koradeh/STM32_Drone/Datasheets/GEPRC-ESP8285-ELRS-Nano-Receiver-Nano-Receiver-diagram.webp

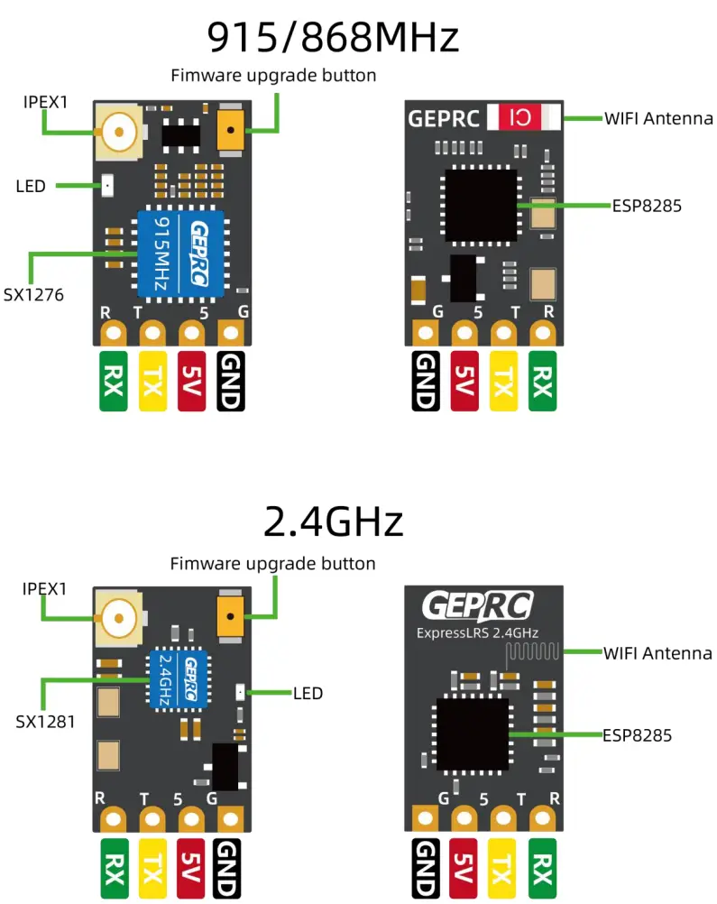
Datasheets/GEPRC-ESP8285-ELRS-Nano-Receiver-Nano-Receiver-diagram.webp
