koradeh/STM32_Drone/Datasheets/SpeedyBee F405 V4.webp

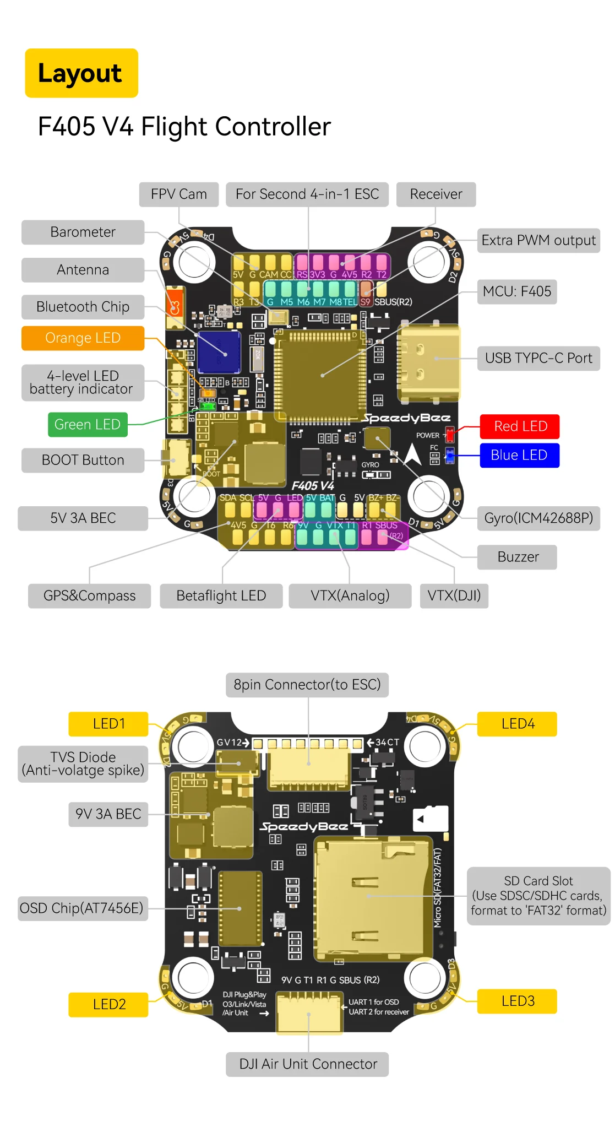
Datasheets/SpeedyBee F405 V4.webp
