koradeh/STM32_Drone/Datasheets/buzzerConnection.png

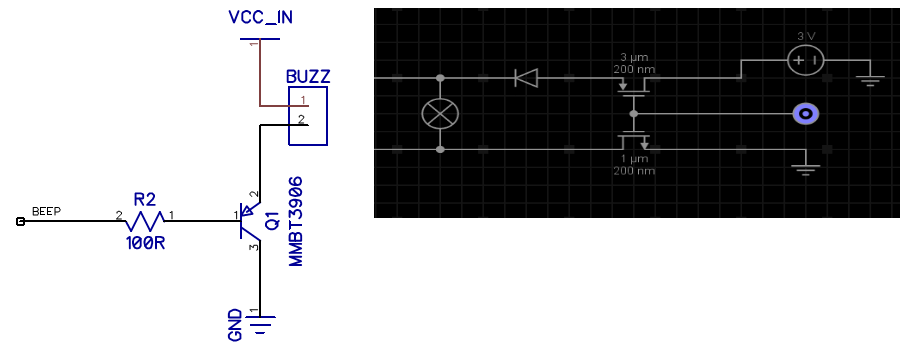
Datasheets/buzzerConnection.png
