koradeh/STM32_Drone/Datasheets/Flight Controller Sample 1.png

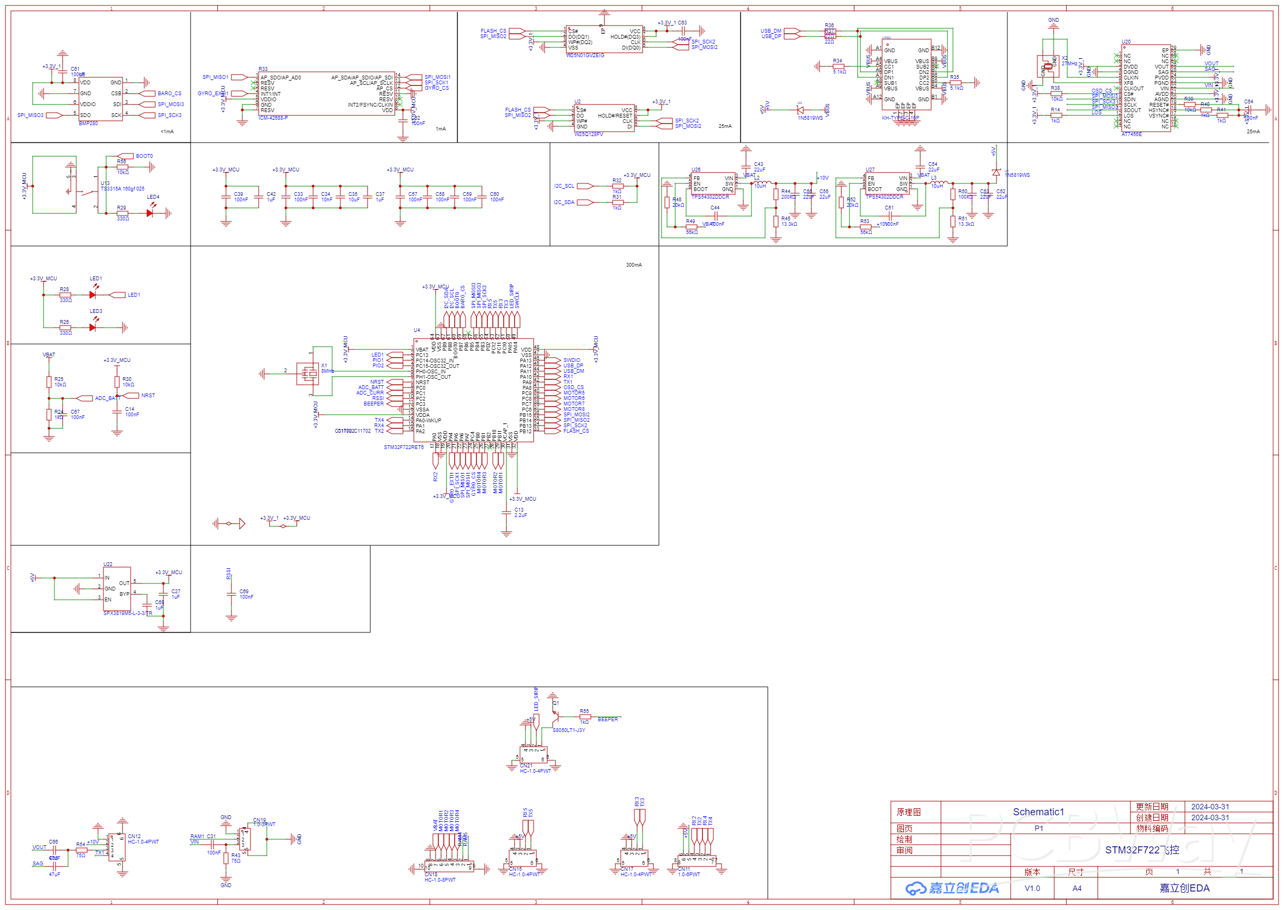
Datasheets/Flight Controller Sample 1.png
