koradeh/STM32_Drone/Sample Firmware/Liberty-X-main/LIBERTY-X.png

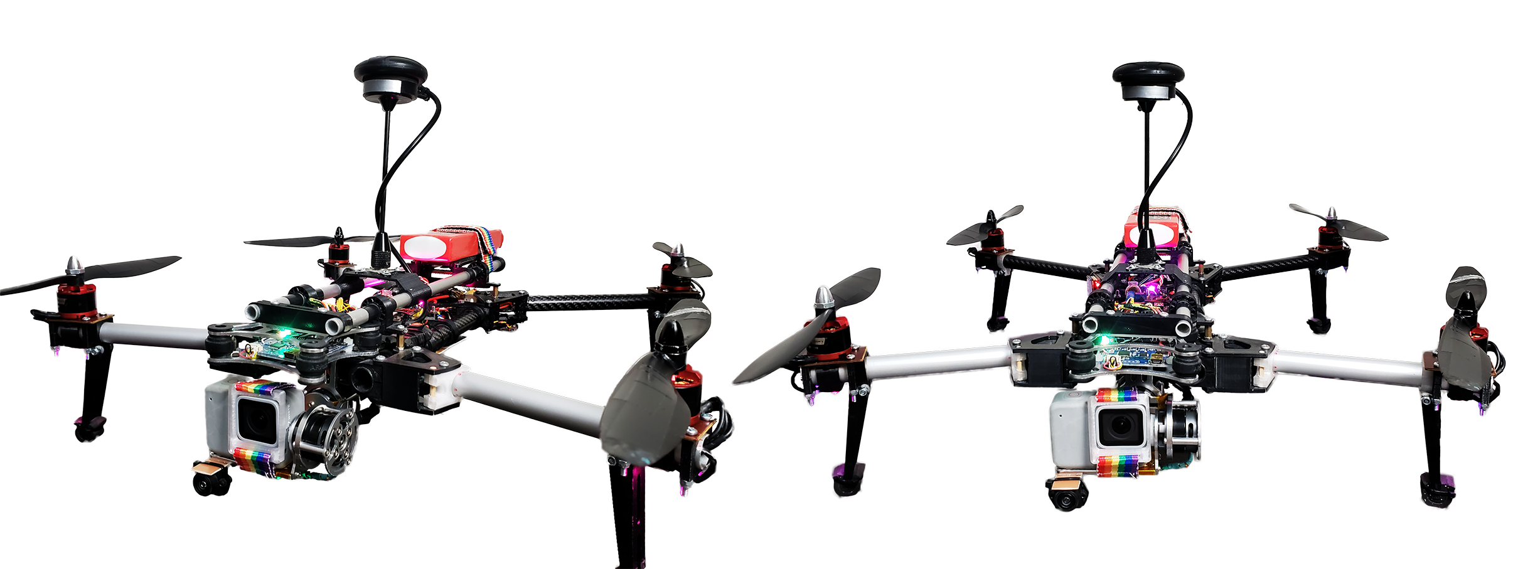
Sample Firmware/Liberty-X-main/LIBERTY-X.png
