koradeh/STM32_Drone/ZenFlyF7II_Clean/ZenFly F71.png

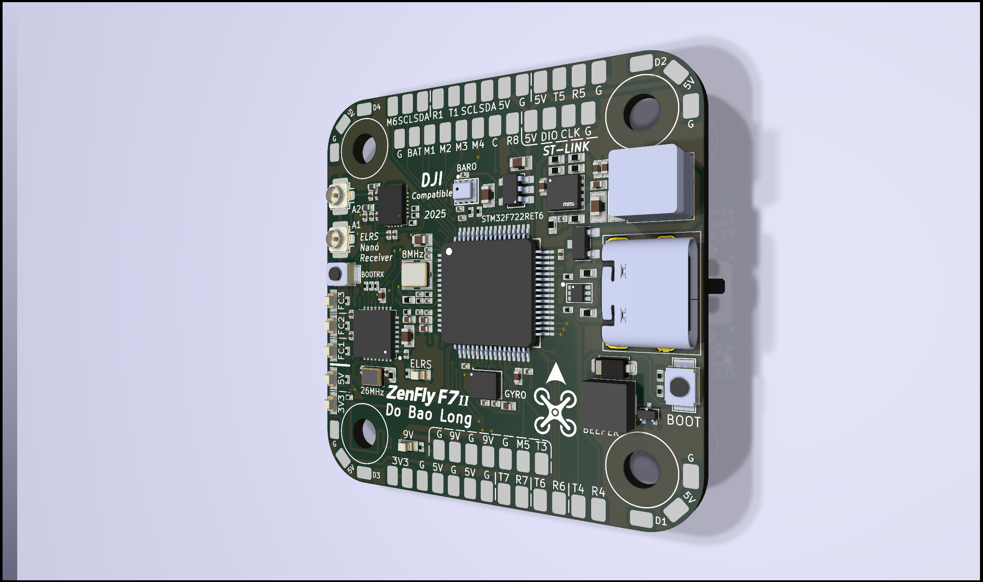
ZenFlyF7II_Clean/ZenFly F71.png
