koradeh/STM32_Drone/ZenFlyF72_Refine/ZenFly F71.jpg

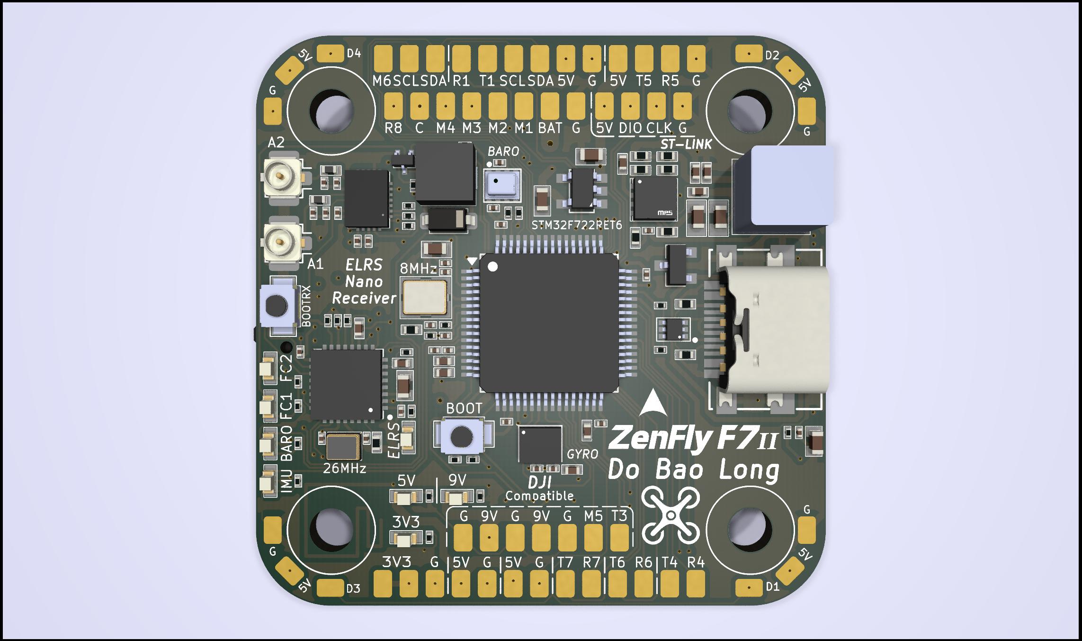
ZenFlyF72_Refine/ZenFly F71.jpg
