koradeh/STM32_Drone/Components.xlsx

Resistor | Value | LCSC | Footprint | Spec
R1 | 0 | None | #0201 | None
R2 | 10K | C319932 | #0201 | 1/32W Thin Film Resistor 15V ±0.5% ±50ppm/℃ 10kΩ 0201 Chip Resistor - Surface Mount ROHS
R3 | 10K | C319932 | #0201 | 1/32W Thin Film Resistor 15V ±0.5% ±50ppm/℃ 10kΩ 0201 Chip Resistor - Surface Mount ROHS
R4 | 4.7K | C852254 | #0201 | 50mW Thin Film Resistor ±25ppm/℃ ±0.1% 4.7kΩ 0201 Chip Resistor - Surface Mount ROHS
R5 | 4.7K | C852254 | #0201 | 50mW Thin Film Resistor ±25ppm/℃ ±0.1% 4.7kΩ 0201 Chip Resistor - Surface Mount ROHS
R6 | 5.1K | C851767 (https://www.lcsc.com/product-detail/Chip-Resistor-Surface-Mount_YAGEO-RC0201DR-075K1L_C851767.html) | #0402 | 50mW Thick Film Resistors ±0.5% ±200ppm/℃ 5.1kΩ 0201 Chip Resistor - Surface Mount ROHS
R7 | 5.1K | C851767 (https://www.lcsc.com/product-detail/Chip-Resistor-Surface-Mount_YAGEO-RC0201DR-075K1L_C851767.html) | #0201 | 50mW Thick Film Resistors ±0.5% ±200ppm/℃ 5.1kΩ 0201 Chip Resistor - Surface Mount ROHS
R8 | 22 | C2991382 (https://www.lcsc.com/product-detail/Chip-Resistor-Surface-Mount_Walsin-Tech-Corp-MR02X22R0FAL_C2991382.html) | #0201 | 1/20W Thick Film Resistors 25V ±100ppm/℃ ±1% 22Ω 0201 Chip Resistor - Surface Mount ROHS
R9 | 22 | C2991382 (https://www.lcsc.com/product-detail/Chip-Resistor-Surface-Mount_Walsin-Tech-Corp-MR02X22R0FAL_C2991382.html) | #0201 | 1/20W Thick Film Resistors 25V ±100ppm/℃ ±1% 22Ω 0201 Chip Resistor - Surface Mount ROHS
R10 | 10K | C319932 | #0201 | 1/32W Thin Film Resistor 15V ±0.5% ±50ppm/℃ 10kΩ 0201 Chip Resistor - Surface Mount ROHS
R11 | 10K | C319932 | #0201 | 1/32W Thin Film Resistor 15V ±0.5% ±50ppm/℃ 10kΩ 0201 Chip Resistor - Surface Mount ROHS
R12 | 12K | C2693077 (https://www.lcsc.com/product-detail/Chip-Resistor-Surface-Mount_RESI-PTFR0402B12K0N9_C2693077.html) | #0402 | 50mW 25V ±100ppm/℃ ±1% 12kΩ 0201 Chip Resistor - Surface Mount ROHS
R13 | 10K | C319932 | #0201 | 1/32W Thin Film Resistor 15V ±0.5% ±50ppm/℃ 10kΩ 0201 Chip Resistor - Surface Mount ROHS
R14 | 18K | C246974 (https://www.lcsc.com/product-detail/Chip-Resistor-Surface-Mount_UNI-ROYAL-Uniroyal-Elec-0201WMF1802TCE_C246974.html) | #0402 | 1/16W Thin Film Resistor 50V ±25ppm/℃ ±0.1% 18kΩ 0402 Chip Resistor - Surface Mount ROHS
R15 | 2K | C490810 | #0201 | 0.05W Thin Film Resistor 25V ±0.1% ±25ppm/℃ 2kΩ 0201 Chip Resistor - Surface Mount ROHS
R16 | 560 | C490810 | #0201 | 0.05W Thin Film Resistor 25V ±0.1% ±25ppm/℃ 2kΩ 0201 Chip Resistor - Surface Mount ROHS
R17 | 330 | C274872 (https://www.lcsc.com/product-detail/Chip-Resistor-Surface-Mount_YAGEO-RC0201FR-07330RL_C274872.html) | #0201 | 50mW Thick Film Resistors 25V ±1% ±200ppm/℃ 330Ω 0201 Chip Resistor - Surface Mount ROHS
R18 | 330 | C274872 (https://www.lcsc.com/product-detail/Chip-Resistor-Surface-Mount_YAGEO-RC0201FR-07330RL_C274872.html) | #0201 | 50mW Thick Film Resistors 25V ±1% ±200ppm/℃ 330Ω 0201 Chip Resistor - Surface Mount ROHS
R19 | 1.1K | C490809 | #0201 | 0.05W Thin Film Resistor 25V ±0.1% ±25ppm/℃ 1.1kΩ 0201 Chip Resistor - Surface Mount ROHS
R20 | 330 | C274872 (https://www.lcsc.com/product-detail/Chip-Resistor-Surface-Mount_YAGEO-RC0201FR-07330RL_C274872.html) | #0201 | 50mW Thick Film Resistors 25V ±1% ±200ppm/℃ 330Ω 0201 Chip Resistor - Surface Mount ROHS
R21 | 330 | C274872 (https://www.lcsc.com/product-detail/Chip-Resistor-Surface-Mount_YAGEO-RC0201FR-07330RL_C274872.html) | #0201 | 50mW Thick Film Resistors 25V ±1% ±200ppm/℃ 330Ω 0201 Chip Resistor - Surface Mount ROHS
R22 | 330 | C274872 (https://www.lcsc.com/product-detail/Chip-Resistor-Surface-Mount_YAGEO-RC0201FR-07330RL_C274872.html) | #0201 | 50mW Thick Film Resistors 25V ±1% ±200ppm/℃ 330Ω 0201 Chip Resistor - Surface Mount ROHS
R23 | 18 | C384425 (https://www.lcsc.com/product-detail/Chip-Resistor-Surface-Mount_Walsin-Tech-Corp-WR02X18R0FAL_C384425.html) | #0201 | 50mW 25V ±100ppm/℃ ±1% 18Ω 0201 Chip Resistor - Surface Mount ROHS
R24 | 10K | C319932 | #0201 | 1/32W Thin Film Resistor 15V ±0.5% ±50ppm/℃ 10kΩ 0201 Chip Resistor - Surface Mount ROHS
R25 | 10K | C319932 | #0201 | 1/32W Thin Film Resistor 15V ±0.5% ±50ppm/℃ 10kΩ 0201 Chip Resistor - Surface Mount ROHS
R26 | 2.2K | C2074393 | #0201 | 50mW Thick Film Resistors 30V ±1% ±100ppm/℃ 2.2kΩ 0201 Chip Resistor - Surface Mount ROHS
R27 | 1.2K | C319992 (https://www.lcsc.com/product-detail/Chip-Resistor-Surface-Mount_Viking-Tech-AR01DTD1201_C319992.html) | #0201 | 1/32W Thin Film Resistor 15V ±0.5% ±50ppm/℃ 1.2kΩ 0201 Chip Resistor - Surface Mount ROHS
R28 | 100K | C2108139 (https://www.lcsc.com/product-detail/Chip-Resistor-Surface-Mount_BOURNS-CR0201-FW-1003GLF_C2108139.html) | #0201 | 50mW Thick Film Resistors 15V ±1% ±200ppm/℃ 100kΩ 0201 Chip Resistor - Surface Mount ROHS
R29 | 330 | C274872 (https://www.lcsc.com/product-detail/Chip-Resistor-Surface-Mount_YAGEO-RC0201FR-07330RL_C274872.html) | #0201 | 50mW Thick Film Resistors 25V ±1% ±200ppm/℃ 330Ω 0201 Chip Resistor - Surface Mount ROHS
R30 | 100K | C2108139 (https://www.lcsc.com/product-detail/Chip-Resistor-Surface-Mount_BOURNS-CR0201-FW-1003GLF_C2108139.html) | #0201 | 50mW Thick Film Resistors 15V ±1% ±200ppm/℃ 100kΩ 0201 Chip Resistor - Surface Mount ROHS
R31_BEC2 | 41.2K | C2683018 (https://www.lcsc.com/product-detail/Chip-Resistor-Surface-Mount_Viking-Tech-ARG02BTC4122_C2683018.html) | #0402 | 1/16W Thin Film Resistor 50V ±25ppm/℃ ±0.1% 41.2kΩ 0402 Chip Resistor - Surface Mount ROHS
R31_BEC1 | 41.2K | C2683018 (https://www.lcsc.com/product-detail/Chip-Resistor-Surface-Mount_Viking-Tech-ARG02BTC4122_C2683018.html) | #0402 | 1/16W Thin Film Resistor 50V ±25ppm/℃ ±0.1% 41.2kΩ 0402 Chip Resistor - Surface Mount ROHS
R30_BEC2 | 7.5K | C728565 (https://www.lcsc.com/product-detail/Chip-Resistor-Surface-Mount_YAGEO-RT0402BRD077K5L_C728565.html) | #0402 | 62.5mW Thin Film Resistor 50V ±25ppm/℃ ±0.1% 7.5kΩ 0402 Chip Resistor - Surface Mount ROHS
R30_BEC1 | 3.92K | C284551 (https://www.lcsc.com/product-detail/Chip-Resistor-Surface-Mount_Viking-Tech-ARG02FTC3921_C284551.html) | #0402 | 1/16W Thin Film Resistor 50V ±25ppm/℃ ±1% 3.92kΩ 0402 Chip Resistor - Surface Mount ROHS
R29_BEC2 | 51K | C284600 (https://www.lcsc.com/product-detail/Chip-Resistor-Surface-Mount_Viking-Tech-ARG02FTC5102_C284600.html) | #0402 | 1/16W Thin Film Resistor 50V ±25ppm/℃ ±1% 51kΩ 0402 Chip Resistor - Surface Mount ROHS
R29_BEC1 | 51K | C284600 (https://www.lcsc.com/product-detail/Chip-Resistor-Surface-Mount_Viking-Tech-ARG02FTC5102_C284600.html) | #0402 | 1/16W Thin Film Resistor 50V ±25ppm/℃ ±1% 51kΩ 0402 Chip Resistor - Surface Mount ROHS
R28_BEC2 | 20 | C2686477 (https://www.lcsc.com/product-detail/Chip-Resistor-Surface-Mount_Viking-Tech-ARG02DTC0200_C2686477.html) | #0402 | 1/16W Thin Film Resistor 50V ±0.5% ±25ppm/℃ 20Ω 0402 Chip Resistor - Surface Mount ROHS
R28_BEC1 | 20 | C2686477 (https://www.lcsc.com/product-detail/Chip-Resistor-Surface-Mount_Viking-Tech-ARG02DTC0200_C2686477.html) | #0402 | 1/16W Thin Film Resistor 50V ±0.5% ±25ppm/℃ 20Ω 0402 Chip Resistor - Surface Mount ROHS
R27_BEC2 | 100K | C852472 (https://www.lcsc.com/product-detail/Chip-Resistor-Surface-Mount_YAGEO-RT0402BRD07100KL_C852472.html) | #0402 | 62.5mW Thin Film Resistor 50V ±25ppm/℃ ±0.1% 100kΩ 0402 Chip Resistor - Surface Mount ROHS
R27_BEC1 | 100K | C852472 (https://www.lcsc.com/product-detail/Chip-Resistor-Surface-Mount_YAGEO-RT0402BRD07100KL_C852472.html) | #0402 | 62.5mW Thin Film Resistor 50V ±25ppm/℃ ±0.1% 100kΩ 0402 Chip Resistor - Surface Mount ROHS
R26_BEC2 | 1M | C1884615 (https://www.lcsc.com/product-detail/Chip-Resistor-Surface-Mount_Vishay-Intertech-MCS04020C1004FE000_C1884615.html) | #0402 | 100mW Thin Film Resistor 50V ±50ppm/℃ ±1% 1MΩ 0402 Chip Resistor - Surface Mount ROHS
R26_BEC1 | 1M | C1884615 | #0402 | 100mW Thin Film Resistor 50V ±50ppm/℃ ±1% 1MΩ 0402 Chip Resistor - Surface Mount ROHS
Capacitor | Value | LCSC | Footprint | Spec
C1 | 100nF | C161494 (https://www.lcsc.com/product-detail/Multilayer-Ceramic-Capacitors-MLCC-SMD-SMT_Murata-Electronics-GRM033Z71A104KE14D_C161494.html) | #0201 | 10V 100nF X7R ±10% 0201 Multilayer Ceramic Capacitors MLCC - SMD/SMT ROHS
C2 | 100nF | C161494 (https://www.lcsc.com/product-detail/Multilayer-Ceramic-Capacitors-MLCC-SMD-SMT_Murata-Electronics-GRM033Z71A104KE14D_C161494.html) | #0201 | 10V 100nF X7R ±10% 0201 Multilayer Ceramic Capacitors MLCC - SMD/SMT ROHS
C3 | 100nF | C161494 (https://www.lcsc.com/product-detail/Multilayer-Ceramic-Capacitors-MLCC-SMD-SMT_Murata-Electronics-GRM033Z71A104KE14D_C161494.html) | #0201 | 10V 100nF X7R ±10% 0201 Multilayer Ceramic Capacitors MLCC - SMD/SMT ROHS
C4 | 100nF | C161494 (https://www.lcsc.com/product-detail/Multilayer-Ceramic-Capacitors-MLCC-SMD-SMT_Murata-Electronics-GRM033Z71A104KE14D_C161494.html) | #0201 | 10V 100nF X7R ±10% 0201 Multilayer Ceramic Capacitors MLCC - SMD/SMT ROHS
C5 | 4.7uF | C913474 (https://www.lcsc.com/product-detail/Multilayer-Ceramic-Capacitors-MLCC-SMD-SMT_Murata-Electronics-GRM188Z71A475KE15D_C913474.html) | #0603 | 10V 4.7uF X7R ±10% 0603 Multilayer Ceramic Capacitors MLCC - SMD/SMT ROHS
C6 | 100nF | C161494 (https://www.lcsc.com/product-detail/Multilayer-Ceramic-Capacitors-MLCC-SMD-SMT_Murata-Electronics-GRM033Z71A104KE14D_C161494.html) | #0201 | 10V 100nF X7R ±10% 0201 Multilayer Ceramic Capacitors MLCC - SMD/SMT ROHS
C7 | 100nF | C161494 (https://www.lcsc.com/product-detail/Multilayer-Ceramic-Capacitors-MLCC-SMD-SMT_Murata-Electronics-GRM033Z71A104KE14D_C161494.html) | #0201 | 10V 100nF X7R ±10% 0201 Multilayer Ceramic Capacitors MLCC - SMD/SMT ROHS
C8 | 2.2uF | C2997286 (https://www.lcsc.com/product-detail/Multilayer-Ceramic-Capacitors-MLCC-SMD-SMT_Murata-Electronics-GRM155Z71A225KE01D_C2997286.html) | #0402 | 10V 2.2uF X7R ±10% 0402 Multilayer Ceramic Capacitors MLCC - SMD/SMT ROHS
C9 | 100nF | C161494 (https://www.lcsc.com/product-detail/Multilayer-Ceramic-Capacitors-MLCC-SMD-SMT_Murata-Electronics-GRM033Z71A104KE14D_C161494.html) | #0201 | 10V 100nF X7R ±10% 0201 Multilayer Ceramic Capacitors MLCC - SMD/SMT ROHS
C10 | 10uF | C2959727 (https://www.lcsc.com/product-detail/Multilayer-Ceramic-Capacitors-MLCC-SMD-SMT_Murata-Electronics-GRM188Z71A106KA73D_C2959727.html) | #0603 | 10V 10uF X7R ±10% 0603 Multilayer Ceramic Capacitors MLCC - SMD/SMT ROHS
C11 | 100nF | C161494 (https://www.lcsc.com/product-detail/Multilayer-Ceramic-Capacitors-MLCC-SMD-SMT_Murata-Electronics-GRM033Z71A104KE14D_C161494.html) | #0201 | 10V 100nF X7R ±10% 0201 Multilayer Ceramic Capacitors MLCC - SMD/SMT ROHS
C12 | 2.2uF | C2997286 (https://www.lcsc.com/product-detail/Multilayer-Ceramic-Capacitors-MLCC-SMD-SMT_Murata-Electronics-GRM155Z71A225KE01D_C2997286.html) | #0402 | 10V 2.2uF X7R ±10% 0402 Multilayer Ceramic Capacitors MLCC - SMD/SMT ROHS
C13 | 10nF | C6049498 (https://www.lcsc.com/product-detail/Multilayer-Ceramic-Capacitors-MLCC-SMD-SMT_Murata-Electronics-GRM033R71A103JA01D_C6049498.html) | #0201 | 10V 10nF X7R ±5% 0201 Multilayer Ceramic Capacitors MLCC - SMD/SMT ROHS
C14 | 100nF | C161494 (https://www.lcsc.com/product-detail/Multilayer-Ceramic-Capacitors-MLCC-SMD-SMT_Murata-Electronics-GRM033Z71A104KE14D_C161494.html) | #0201 | 10V 100nF X7R ±10% 0201 Multilayer Ceramic Capacitors MLCC - SMD/SMT ROHS
C15 | 100nF | C161494 (https://www.lcsc.com/product-detail/Multilayer-Ceramic-Capacitors-MLCC-SMD-SMT_Murata-Electronics-GRM033Z71A104KE14D_C161494.html) | #0201 | 10V 100nF X7R ±10% 0201 Multilayer Ceramic Capacitors MLCC - SMD/SMT ROHS
C16 | 100nF | C161494 (https://www.lcsc.com/product-detail/Multilayer-Ceramic-Capacitors-MLCC-SMD-SMT_Murata-Electronics-GRM033Z71A104KE14D_C161494.html) | #0201 | 10V 100nF X7R ±10% 0201 Multilayer Ceramic Capacitors MLCC - SMD/SMT ROHS
C17 | 1uF | C528974 (https://www.lcsc.com/product-detail/Multilayer-Ceramic-Capacitors-MLCC-SMD-SMT_Murata-Electronics-GRM155Z71A105KE01D_C528974.html) | #0402 | 10V 1uF X7R ±10% 0402 Multilayer Ceramic Capacitors MLCC - SMD/SMT ROHS
C18 | 1uF | C528974 (https://www.lcsc.com/product-detail/Multilayer-Ceramic-Capacitors-MLCC-SMD-SMT_Murata-Electronics-GRM155Z71A105KE01D_C528974.html) | #0402 | 10V 1uF X7R ±10% 0402 Multilayer Ceramic Capacitors MLCC - SMD/SMT ROHS
C19 | 10pF | C18213215 (https://www.lcsc.com/product-detail/Multilayer-Ceramic-Capacitors-MLCC-SMD-SMT_FH-Guangdong-Fenghua-Advanced-Tech-0201CG100J160NT_C18213215.html) | #0201 | 16V 10pF C0G ±5% 0201 Multilayer Ceramic Capacitors MLCC - SMD/SMT ROHS
C20 | 10pF | C18213215 (https://www.lcsc.com/product-detail/Multilayer-Ceramic-Capacitors-MLCC-SMD-SMT_FH-Guangdong-Fenghua-Advanced-Tech-0201CG100J160NT_C18213215.html) | #0201 | 16V 10pF C0G ±5% 0201 Multilayer Ceramic Capacitors MLCC - SMD/SMT ROHS
C21 | 10pF | C18213215 (https://www.lcsc.com/product-detail/Multilayer-Ceramic-Capacitors-MLCC-SMD-SMT_FH-Guangdong-Fenghua-Advanced-Tech-0201CG100J160NT_C18213215.html) | #0201 | 16V 10pF C0G ±5% 0201 Multilayer Ceramic Capacitors MLCC - SMD/SMT ROHS
C22 | 10pF | C18213215 (https://www.lcsc.com/product-detail/Multilayer-Ceramic-Capacitors-MLCC-SMD-SMT_FH-Guangdong-Fenghua-Advanced-Tech-0201CG100J160NT_C18213215.html) | #0201 | 16V 10pF C0G ±5% 0201 Multilayer Ceramic Capacitors MLCC - SMD/SMT ROHS
C23 | 100nF | C161494 (https://www.lcsc.com/product-detail/Multilayer-Ceramic-Capacitors-MLCC-SMD-SMT_Murata-Electronics-GRM033Z71A104KE14D_C161494.html) | #0201 | 10V 100nF X7R ±10% 0201 Multilayer Ceramic Capacitors MLCC - SMD/SMT ROHS
C24 | 10nF | C6049498 (https://www.lcsc.com/product-detail/Multilayer-Ceramic-Capacitors-MLCC-SMD-SMT_Murata-Electronics-GRM033R71A103JA01D_C6049498.html) | #0201 | 10V 10nF X7R ±5% 0201 Multilayer Ceramic Capacitors MLCC - SMD/SMT ROHS
C25 | 4.7uF | C913474 (https://www.lcsc.com/product-detail/Multilayer-Ceramic-Capacitors-MLCC-SMD-SMT_Murata-Electronics-GRM188Z71A475KE15D_C913474.html) | #0603 | 10V 4.7uF X7R ±10% 0603 Multilayer Ceramic Capacitors MLCC - SMD/SMT ROHS
C26 | 4.7uF | C913474 (https://www.lcsc.com/product-detail/Multilayer-Ceramic-Capacitors-MLCC-SMD-SMT_Murata-Electronics-GRM188Z71A475KE15D_C913474.html) | #0603 | 10V 4.7uF X7R ±10% 0603 Multilayer Ceramic Capacitors MLCC - SMD/SMT ROHS
C27 | 100nF | C161494 (https://www.lcsc.com/product-detail/Multilayer-Ceramic-Capacitors-MLCC-SMD-SMT_Murata-Electronics-GRM033Z71A104KE14D_C161494.html) | #0201 | 10V 100nF X7R ±10% 0201 Multilayer Ceramic Capacitors MLCC - SMD/SMT ROHS
C28 | 100nF | C161494 (https://www.lcsc.com/product-detail/Multilayer-Ceramic-Capacitors-MLCC-SMD-SMT_Murata-Electronics-GRM033Z71A104KE14D_C161494.html) | #0201 | 10V 100nF X7R ±10% 0201 Multilayer Ceramic Capacitors MLCC - SMD/SMT ROHS
C29 | 10nF | C6049498 (https://www.lcsc.com/product-detail/Multilayer-Ceramic-Capacitors-MLCC-SMD-SMT_Murata-Electronics-GRM033R71A103JA01D_C6049498.html) | #0201 | 10V 10nF X7R ±5% 0201 Multilayer Ceramic Capacitors MLCC - SMD/SMT ROHS
C30 | 100nF | C161494 (https://www.lcsc.com/product-detail/Multilayer-Ceramic-Capacitors-MLCC-SMD-SMT_Murata-Electronics-GRM033Z71A104KE14D_C161494.html) | #0201 | 10V 100nF X7R ±10% 0201 Multilayer Ceramic Capacitors MLCC - SMD/SMT ROHS
C31 | 100nF | C161494 (https://www.lcsc.com/product-detail/Multilayer-Ceramic-Capacitors-MLCC-SMD-SMT_Murata-Electronics-GRM033Z71A104KE14D_C161494.html) | #0201 | 10V 100nF X7R ±10% 0201 Multilayer Ceramic Capacitors MLCC - SMD/SMT ROHS
C32 | 470nF | C36911354 (https://www.lcsc.com/product-detail/Multilayer-Ceramic-Capacitors-MLCC-SMD-SMT_HRE-CGA0402X7R474K100GT_C36911354.html) | #0402 | 10V 470nF X7R ±10% 0402 Multilayer Ceramic Capacitors MLCC - SMD/SMT ROHS
C33 | 18pF | C18213178 (https://www.lcsc.com/product-detail/Multilayer-Ceramic-Capacitors-MLCC-SMD-SMT_FH-Guangdong-Fenghua-Advanced-Tech-0201CG180J160NT_C18213178.html) | #0201 | 16V 18pF C0G ±5% 0201 Multilayer Ceramic Capacitors MLCC - SMD/SMT ROHS
C34 | 18pF | C18213178 (https://www.lcsc.com/product-detail/Multilayer-Ceramic-Capacitors-MLCC-SMD-SMT_FH-Guangdong-Fenghua-Advanced-Tech-0201CG180J160NT_C18213178.html) | #0201 | 16V 18pF C0G ±5% 0201 Multilayer Ceramic Capacitors MLCC - SMD/SMT ROHS
C35 | 1.2pF | C20069200 (https://www.lcsc.com/product-detail/Multilayer-Ceramic-Capacitors-MLCC-SMD-SMT_HRE-CGA0201C0G1R2C250ET_C20069200.html) | #0201 | 25V 1.2pF C0G 0201 Multilayer Ceramic Capacitors MLCC - SMD/SMT ROHS
C36 | 1.2pF | C20069200 (https://www.lcsc.com/product-detail/Multilayer-Ceramic-Capacitors-MLCC-SMD-SMT_HRE-CGA0201C0G1R2C250ET_C20069200.html) | #0201 | 25V 1.2pF C0G 0201 Multilayer Ceramic Capacitors MLCC - SMD/SMT ROHS
C37 | 1.2pF | C20069200 (https://www.lcsc.com/product-detail/Multilayer-Ceramic-Capacitors-MLCC-SMD-SMT_HRE-CGA0201C0G1R2C250ET_C20069200.html) | #0201 | 25V 1.2pF C0G 0201 Multilayer Ceramic Capacitors MLCC - SMD/SMT ROHS
C38 | 1.2pF | C20069200 (https://www.lcsc.com/product-detail/Multilayer-Ceramic-Capacitors-MLCC-SMD-SMT_HRE-CGA0201C0G1R2C250ET_C20069200.html) | #0201 | 25V 1.2pF C0G 0201 Multilayer Ceramic Capacitors MLCC - SMD/SMT ROHS
C39 | 10pF | C18213215 (https://www.lcsc.com/product-detail/Multilayer-Ceramic-Capacitors-MLCC-SMD-SMT_FH-Guangdong-Fenghua-Advanced-Tech-0201CG100J160NT_C18213215.html) | #0201 | 16V 10pF C0G ±5% 0201 Multilayer Ceramic Capacitors MLCC - SMD/SMT ROHS
C40 | 10pF | C18213215 (https://www.lcsc.com/product-detail/Multilayer-Ceramic-Capacitors-MLCC-SMD-SMT_FH-Guangdong-Fenghua-Advanced-Tech-0201CG100J160NT_C18213215.html) | #0201 | 16V 10pF C0G ±5% 0201 Multilayer Ceramic Capacitors MLCC - SMD/SMT ROHS
C41 | 1uF | C528974 (https://www.lcsc.com/product-detail/Multilayer-Ceramic-Capacitors-MLCC-SMD-SMT_Murata-Electronics-GRM155Z71A105KE01D_C528974.html) | #0402 | 10V 1uF X7R ±10% 0402 Multilayer Ceramic Capacitors MLCC - SMD/SMT ROHS
C42 | 1uF | C528974 (https://www.lcsc.com/product-detail/Multilayer-Ceramic-Capacitors-MLCC-SMD-SMT_Murata-Electronics-GRM155Z71A105KE01D_C528974.html) | #0402 | 10V 1uF X7R ±10% 0402 Multilayer Ceramic Capacitors MLCC - SMD/SMT ROHS
C43 | 10uF | C2959727 (https://www.lcsc.com/product-detail/Multilayer-Ceramic-Capacitors-MLCC-SMD-SMT_Murata-Electronics-GRM188Z71A106KA73D_C2959727.html) | #0603 | 10V 10uF X7R ±10% 0603 Multilayer Ceramic Capacitors MLCC - SMD/SMT ROHS
C29_BEC1 | 10uF | C22367826 (https://www.lcsc.com/product-detail/Multilayer-Ceramic-Capacitors-MLCC-SMD-SMT_Chinocera-HGC0603R5106K350NTHJ_C22367826.html) | #0603 | 35V 10uF X5R ±10% 0603 Multilayer Ceramic Capacitors MLCC - SMD/SMT ROHS
C29_BEC2 | 10uF | C22367826 (https://www.lcsc.com/product-detail/Multilayer-Ceramic-Capacitors-MLCC-SMD-SMT_Chinocera-HGC0603R5106K350NTHJ_C22367826.html) | #0603 | 35V 10uF X5R ±10% 0603 Multilayer Ceramic Capacitors MLCC - SMD/SMT ROHS
C30_BEC1 | 10uF | C22367826 (https://www.lcsc.com/product-detail/Multilayer-Ceramic-Capacitors-MLCC-SMD-SMT_Chinocera-HGC0603R5106K350NTHJ_C22367826.html) | #0603 | 35V 10uF X5R ±10% 0603 Multilayer Ceramic Capacitors MLCC - SMD/SMT ROHS
C30_BEC2 | 10uF | C22367826 (https://www.lcsc.com/product-detail/Multilayer-Ceramic-Capacitors-MLCC-SMD-SMT_Chinocera-HGC0603R5106K350NTHJ_C22367826.html) | #0603 | 35V 10uF X5R ±10% 0603 Multilayer Ceramic Capacitors MLCC - SMD/SMT ROHS
C31_BEC1 | 1uF | C361059 (https://www.lcsc.com/product-detail/Multilayer-Ceramic-Capacitors-MLCC-SMD-SMT_Murata-Electronics-GRM155R6YA105KE11D_C361059.html) | #0402 | 35V 1uF X5R ±10% 0402 Multilayer Ceramic Capacitors MLCC - SMD/SMT ROHS
C31_BEC2 | 1uF | C361059 (https://www.lcsc.com/product-detail/Multilayer-Ceramic-Capacitors-MLCC-SMD-SMT_Murata-Electronics-GRM155R6YA105KE11D_C361059.html) | #0402 | 35V 1uF X5R ±10% 0402 Multilayer Ceramic Capacitors MLCC - SMD/SMT ROHS
C32_BEC1 | 100nF | C181043 (https://www.lcsc.com/product-detail/Multilayer-Ceramic-Capacitors-MLCC-SMD-SMT_Murata-Electronics-GRM033R6YA104KE14D_C181043.html) | #0201 | 35V 100nF X5R ±10% 0201 Multilayer Ceramic Capacitors MLCC - SMD/SMT ROHS
C32_BEC2 | 100nF | C181043 (https://www.lcsc.com/product-detail/Multilayer-Ceramic-Capacitors-MLCC-SMD-SMT_Murata-Electronics-GRM033R6YA104KE14D_C181043.html) | #0201 | 35V 100nF X5R ±10% 0201 Multilayer Ceramic Capacitors MLCC - SMD/SMT ROHS
C33_BEC1 | 100nF | C181043 (https://www.lcsc.com/product-detail/Multilayer-Ceramic-Capacitors-MLCC-SMD-SMT_Murata-Electronics-GRM033R6YA104KE14D_C181043.html) | #0201 | 35V 100nF X5R ±10% 0201 Multilayer Ceramic Capacitors MLCC - SMD/SMT ROHS
C33_BEC2 | 100nF | C181043 (https://www.lcsc.com/product-detail/Multilayer-Ceramic-Capacitors-MLCC-SMD-SMT_Murata-Electronics-GRM033R6YA104KE14D_C181043.html) | #0201 | 35V 100nF X5R ±10% 0201 Multilayer Ceramic Capacitors MLCC - SMD/SMT ROHS
C34_BEC1 | 22uF | C6119868 (https://www.lcsc.com/product-detail/Multilayer-Ceramic-Capacitors-MLCC-SMD-SMT_HRE-CGA0603X5R226M160JT_C6119868.html) | #0603 | 16V 22uF X5R ±20% 0603 Multilayer Ceramic Capacitors MLCC - SMD/SMT ROHS
C34_BEC2 | 22uF | C3845593 (https://www.lcsc.com/product-detail/Multilayer-Ceramic-Capacitors-MLCC-SMD-SMT_Murata-Electronics-GRM158R61A226ME15D_C3845593.html) | #0402 | 10V 22uF X5R ±20% 0402 Multilayer Ceramic Capacitors MLCC - SMD/SMT ROHS
C35_BEC1 | 22uF | C6119868 (https://www.lcsc.com/product-detail/Multilayer-Ceramic-Capacitors-MLCC-SMD-SMT_HRE-CGA0603X5R226M160JT_C6119868.html) | #0603 | 16V 22uF X5R ±20% 0603 Multilayer Ceramic Capacitors MLCC - SMD/SMT ROHS
C35_BEC2 | 22uF | C3845593 (https://www.lcsc.com/product-detail/Multilayer-Ceramic-Capacitors-MLCC-SMD-SMT_Murata-Electronics-GRM158R61A226ME15D_C3845593.html) | #0402 | 10V 22uF X5R ±20% 0402 Multilayer Ceramic Capacitors MLCC - SMD/SMT ROHS
Others | Name | LCSC | Footprint | Specification
BZ1 | KLJ-4020 | C556936 (https://www.lcsc.com/product-detail/Buzzers_KELIKING-KLJ-4020_C556936.html) |  | 73dB 4kHz SMD,4x4mm Buzzers ROHS
D1 | BAT54C, 215 | C37704 (https://www.lcsc.com/product-detail/Schottky-Diodes_Nexperia-BAT54C-215_C37704.html?s_z=n_BAt54C%252C%2520215) | SOT-23 | 30V 1 pair of common cathodes 800mV@100mA 200mA SOT-23 Schottky Diodes ROHS
D2 | SMF45A | C5764435 (https://www.lcsc.com/product-detail/ESD-and-Surge-Protection-TVS-ESD_YFW-SMF45A_C5764435.html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) | SOD-123FL | 2.8A 200W 72.7V 50V Unidirectional 45V SOD-123FL ESD and Surge Protection (TVS/ESD) ROHS
D4 | LMBR130T1G | C48974 (https://www.lcsc.com/product-detail/Schottky-Diodes_LRC-LMBR130T1G_C48974.html) | SOD-123 | 30V 350mV 1A SOD-123 Schottky Diodes ROHS
D5 | 1N4148WS | C2128 (https://www.lcsc.com/product-detail/Switching-Diodes_Jiangsu-Changjing-Electronics-Technology-Co-Ltd-1N4148WS_C2128.html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) | SOD-323 | 100V Independent Type 1.25V@150mA 4ns 150mA SOD-323 Switching Diodes ROHS
D6 | 1N4148WS | C2128 (https://www.lcsc.com/product-detail/Switching-Diodes_Jiangsu-Changjing-Electronics-Technology-Co-Ltd-1N4148WS_C2128.html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) | SOD-323 | 100V Independent Type 1.25V@150mA 4ns 150mA SOD-323 Switching Diodes ROHS
FB1 | BLM03AX121SN1D | C83991 (https://www.lcsc.com/product-detail/Ferrite-Beads_Murata-Electronics-BLM03AX121SN1D_C83991.html?s_z=n_FB) | #0201 | 230mΩ ±25% 120Ω@100MHz 0201 Ferrite Beads ROHS
FL1 | 2450FM07D0034T | Shopee | SMD-4P, 0.5x1mm | 100MHz 0.75dB SMD-4P,0.5x1mm RF Filters ROHS (Designed for SX1280)
Q2 | MMBT3904TT1G | C242260 (https://www.lcsc.com/product-detail/Bipolar-BJT_onsemi-MMBT3904TT1G_C242260.html?s_z=n_MMBT3904TT1G) | SOT-416 | 40V 200mW 100@0.1mA,1.0V 200mA NPN SOT-416 Bipolar (BJT) ROHS
J14 | U.FL-R-SMT-1(10) | C88373 (https://www.lcsc.com/product-detail/Coaxial-Connectors-RF_HRS-Hirose-U-FL-R-SMT-1-10_C88373.html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) | FL_Hirose_U.FL-R-SMT-1_Vertical | 1 Inner pin IPEX Board-End 1.25mm -40℃~+90℃ 6GHz 50Ω 2mm SMD Coaxial Connectors (RF) ROHS
J17 | U.FL-R-SMT-1(10) | C88373 (https://www.lcsc.com/product-detail/Coaxial-Connectors-RF_HRS-Hirose-U-FL-R-SMT-1-10_C88373.html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) | FL_Hirose_U.FL-R-SMT-1_Vertical | 1 Inner pin IPEX Board-End 1.25mm -40℃~+90℃ 6GHz 50Ω 2mm SMD Coaxial Connectors (RF) ROHS
LED1 | 19-213/Y2C-CQ2R2L/3T(CY) | C72038 (https://www.lcsc.com/product-detail/LED-Indication-Discrete_Everlight-Elec-19-213-Y2C-CQ2R2L-3T-CY_C72038.html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) | #0603 | 20mA Colorless Transparent Lens -40℃~+85℃ 585.5nm~591.5nm Yellow 120° 60mW 0603 LED Indication - Discrete ROHS
LED2 | 19-213/Y2C-CQ2R2L/3T(CY) | C72038 (https://www.lcsc.com/product-detail/LED-Indication-Discrete_Everlight-Elec-19-213-Y2C-CQ2R2L-3T-CY_C72038.html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) | #0603 | 20mA Colorless Transparent Lens -40℃~+85℃ 585.5nm~591.5nm Yellow 120° 60mW 0603 LED Indication - Discrete ROHS
LED4 | 19-213/Y2C-CQ2R2L/3T(CY) | C72038 (https://www.lcsc.com/product-detail/LED-Indication-Discrete_Everlight-Elec-19-213-Y2C-CQ2R2L-3T-CY_C72038.html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) | #0603 | 20mA Colorless Transparent Lens -40℃~+85℃ 585.5nm~591.5nm Yellow 120° 60mW 0603 LED Indication - Discrete ROHS
LED3 | 19-213/R6C-AP1Q2B/5T | C2984264 (https://www.lcsc.com/product-detail/LED-Indication-Discrete_Everlight-Elec-19-213-R6C-AP1Q2B-5T_C2984264.html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) | #0603 | 112mcd 617.5nm~633.5nm Red 0603 LED Indication - Discrete ROHS
LED5 | 19-213/R6C-AP1Q2B/5T | C2984264 (https://www.lcsc.com/product-detail/LED-Indication-Discrete_Everlight-Elec-19-213-R6C-AP1Q2B-5T_C2984264.html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) | #0603 | 112mcd 617.5nm~633.5nm Red 0603 LED Indication - Discrete ROHS
LED6 | 19-213/GVC-AMNB/5T | C2986021 (https://www.lcsc.com/product-detail/LED-Indication-Discrete_Everlight-Elec-19-213-GVC-AMNB-5T_C2986021.html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) | #0603 | 20mA Colorless Transparent Lens -40℃~+85℃ 563.5nm~571.5nm Yellow-green 120° 60mW 0603 LED Indication - Discrete ROHS
LED7 | 19-213/GHC-XS1T1N/5T | C2984266 (https://www.lcsc.com/product-detail/LED-Indication-Discrete_Everlight-Elec-19-213-GHC-XS1T1N-5T_C2984266.html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) | #0603 | 360mcd Colorless Transparent Lens -40℃~+85℃ 515nm~530nm Emerald 120° 95mW 3.7V 0603 LED Indication - Discrete ROHS
SW1 | B3U-1000P | C231329 (https://www.lcsc.com/product-detail/Tactile-Switches_Omron-Electronics-B3U-1000P_C231329.html?s_z=n_B3U-1000) | Custom | 2.5mm 1.6mm Round Button 50mA Standing paste 3mm SPST 153gf 12V SMD,2.5x3mm Tactile Switches ROHS
SW2 | TA-3514-A1-B | C513999 (https://www.lcsc.com/product-detail/Slide-Switches_Yuandi-TA-3514-A1-B_C513999.html?s_z=n_TA-3514-A1-B) | Custom | SMD,2.7x5mm Slide Switches ROHS
SW3 | B3U-1000P | C231329 (https://www.lcsc.com/product-detail/Tactile-Switches_Omron-Electronics-B3U-1000P_C231329.html?s_z=n_B3U-1000) | Custom | 2.5mm 1.6mm Round Button 50mA Standing paste 3mm SPST 153gf 12V SMD,2.5x3mm Tactile Switches ROHS
L1 | 10uH (FEXL0550A-100M) | C5378517 (https://www.lcsc.com/product-detail/Power-Inductors_cjiang-Changjiang-Microelectronics-Tech-FEXL0550A-100M_C5378517.html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) | Custom | 5A 10uH Winding Inductor ±20% 6.5A SMD,5.5x5.3mm Power Inductors ROHS
L2 | 10uH (FEXL0550A-100M) | C5378517 (https://www.lcsc.com/product-detail/Power-Inductors_cjiang-Changjiang-Microelectronics-Tech-FEXL0550A-100M_C5378517.html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) | Custom | 5A 10uH Winding Inductor ±20% 6.5A SMD,5.5x5.3mm Power Inductors ROHS
L3 | 15uH (MGFL2012F150MT-LF) | C486333 (https://www.lcsc.com/product-detail/Inductors-SMD_microgate-MGFL2012F150MT-LF_C486333.html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) | #0805 | 400mA 15uH ±20% 500mΩ 0805 Inductors (SMD) ROHS
L4 | 3nH (LQW15AN3N0B00D) | C269824 (https://www.lcsc.com/product-detail/Power-Inductors_Murata-Electronics-LQW15AN3N0B00D_C269824.html) | #0402 | 750mA 3nH 0402 Power Inductors ROHS
FL2 | MEM1608P75R0T001 (CLC Filter) | C6300481 (https://www.lcsc.com/product-detail/EMI-RFI-Filters-LC-RC-Networks_TDK-MEM1608P75R0T001_C6300481.html) | #0603 | 0603(1608METRIC),3PCPAD EMI/RFI Filters (LC, RC Networks) ROHS
J21 | 503398-1892 | C428492 (https://www.lcsc.com/product-detail/SD-Card-Memory-Card-Connector_MOLEX-5033981892_C428492.html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) | Custom | *-25℃~+85℃ 1.28mm Card Slot MicroSD card (TF card) Self-bouncing SMD SD Card / Memory Card Connector ROHS
