koradeh/STM32_Drone/Footprints/2450FM07D0034T/2450FM07A0035T_JOT.step

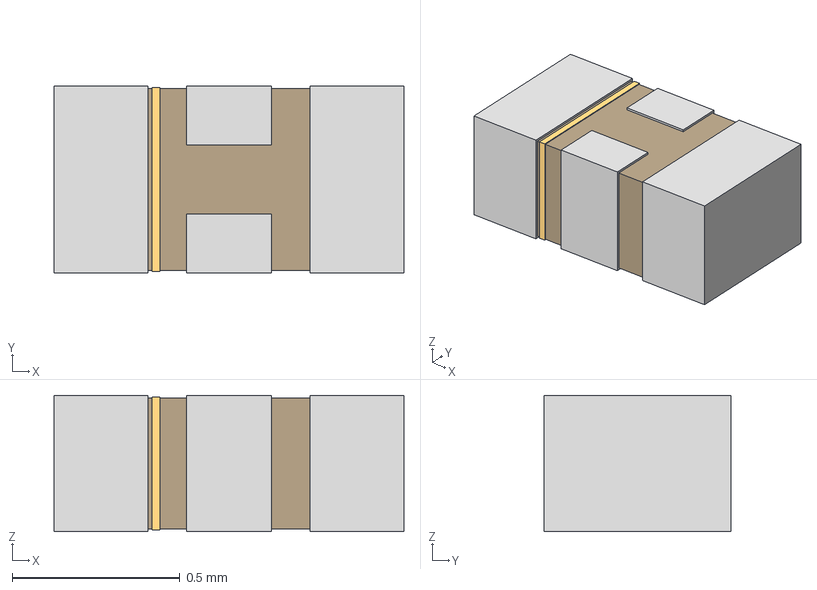
[picture p8: CAD file, 2025-04-08]
Footprints/2450FM07D0034T/2450FM07A0035T_JOT.step
1.04 x 0.558 x 0.406 mm
