koradeh/STM32_Drone/Footprints/AT7456E/AT7456E.stp

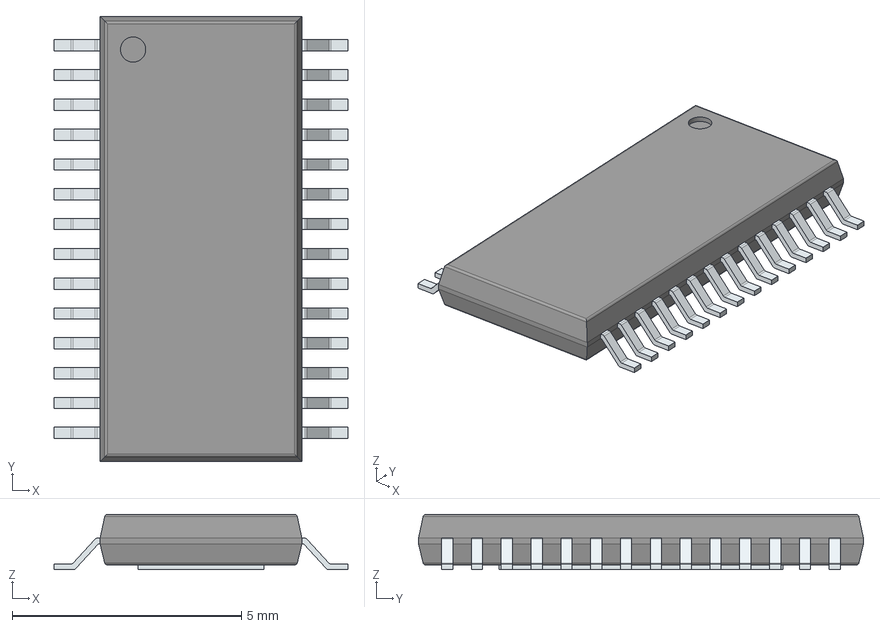
[picture p9: CAD file, 2025-04-08]
Footprints/AT7456E/AT7456E.stp
6.40 x 9.70 x 1.20 mm
PinsArrayLR
ThermalPad
