koradeh/STM32_Drone/Footprints/B3U-1000P/B3U-1000P.step

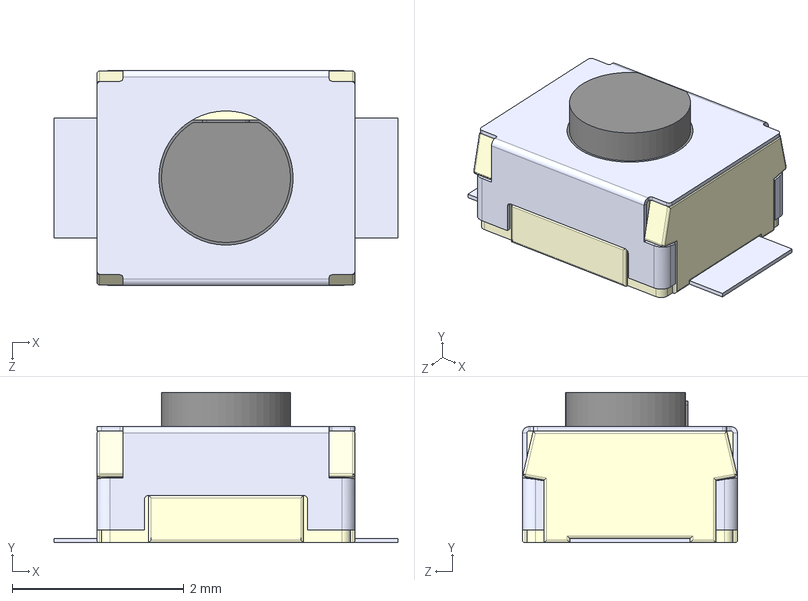
[picture p10: CAD file, 2025-04-08]
Footprints/B3U-1000P/B3U-1000P.step
4.00 x 1.75 x 2.50 mm
