koradeh/STM32_Drone/Footprints/BAT54C,215/SMD-DIODE-SCHOTTKY-30V-200MA_SOT-23_.step

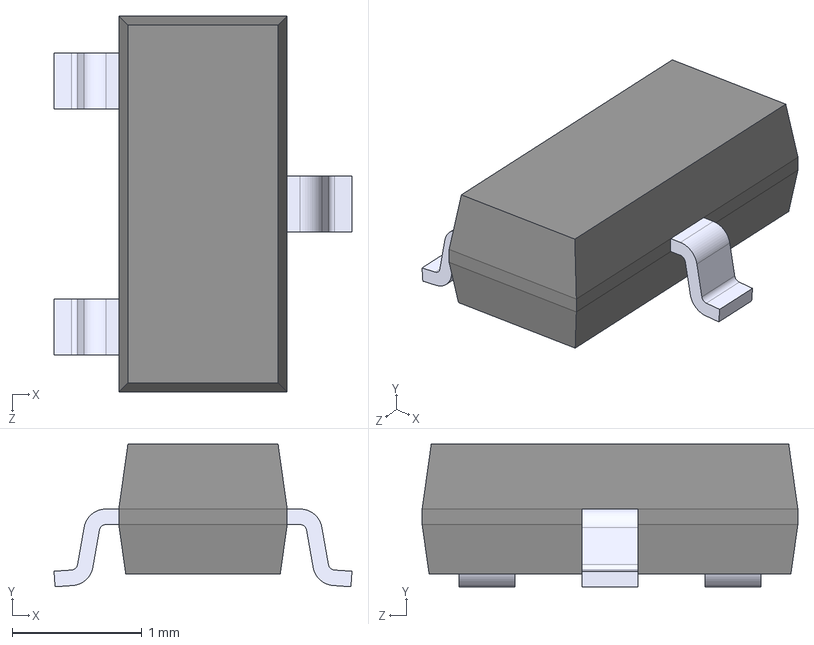
[picture p11: CAD file, 2025-04-08]
Footprints/BAT54C,215/SMD-DIODE-SCHOTTKY-30V-200MA_SOT-23_.step
2.30 x 1.10 x 2.90 mm
