koradeh/STM32_Drone/Footprints/BMP280/BMP280.step

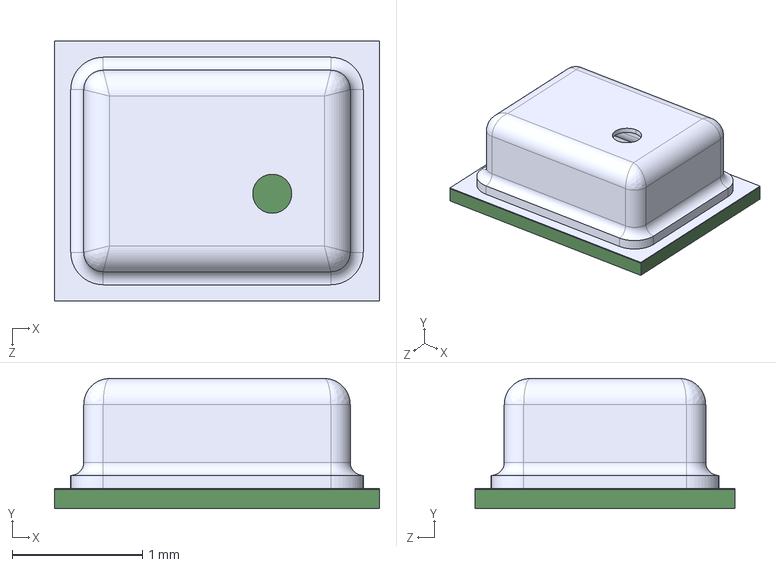
[picture p12: CAD file, 2025-04-08]
Footprints/BMP280/BMP280.step
2.50 x 1.00 x 2.00 mm
