koradeh/STM32_Drone/Footprints/ESP8285/ESP8285.step

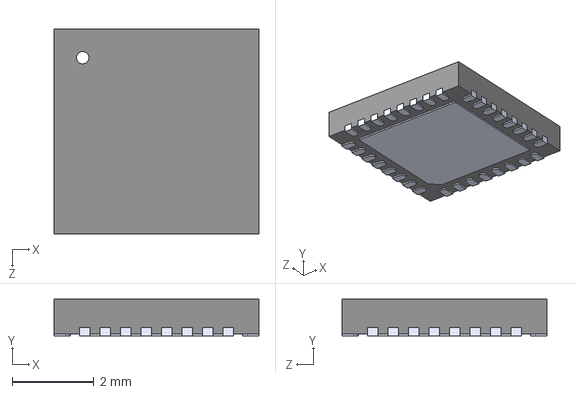
[picture p13: CAD file, 2025-04-08]
Footprints/ESP8285/ESP8285.step
5.00 x 0.9 x 5.00 mm
