koradeh/STM32_Drone/Footprints/FEXL0550A-100M.STEP

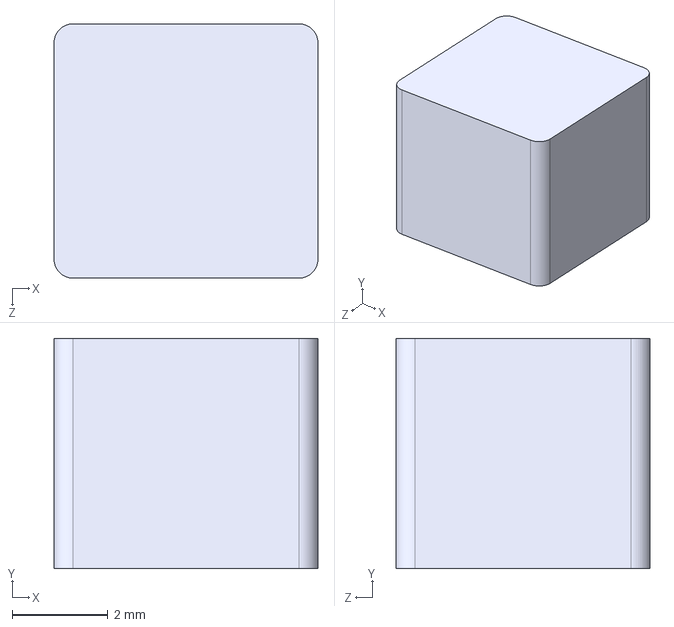
[picture p14: CAD file, 2025-04-08]
Footprints/FEXL0550A-100M.STEP
5.50 x 4.80 x 5.30 mm
