koradeh/STM32_Drone/Footprints/ICM-42688-P/ICM-42688-P.step

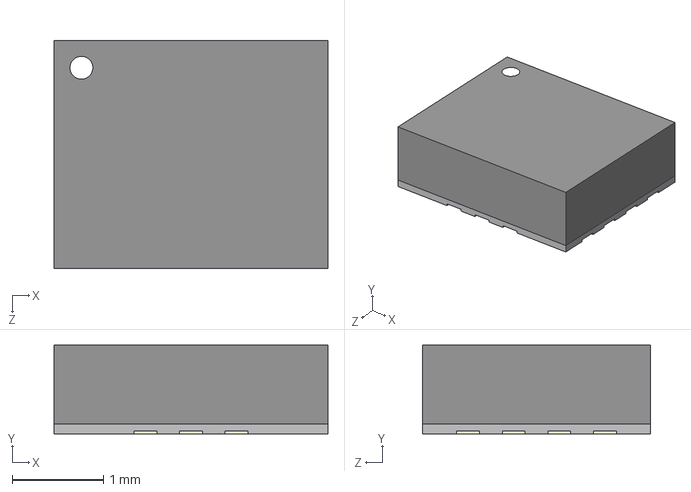
[picture p15: CAD file, 2025-04-08]
Footprints/ICM-42688-P/ICM-42688-P.step
3.00 x 0.97 x 2.50 mm
