koradeh/STM32_Drone/Footprints/Inductors/100M/YSPI0420-100M.stp

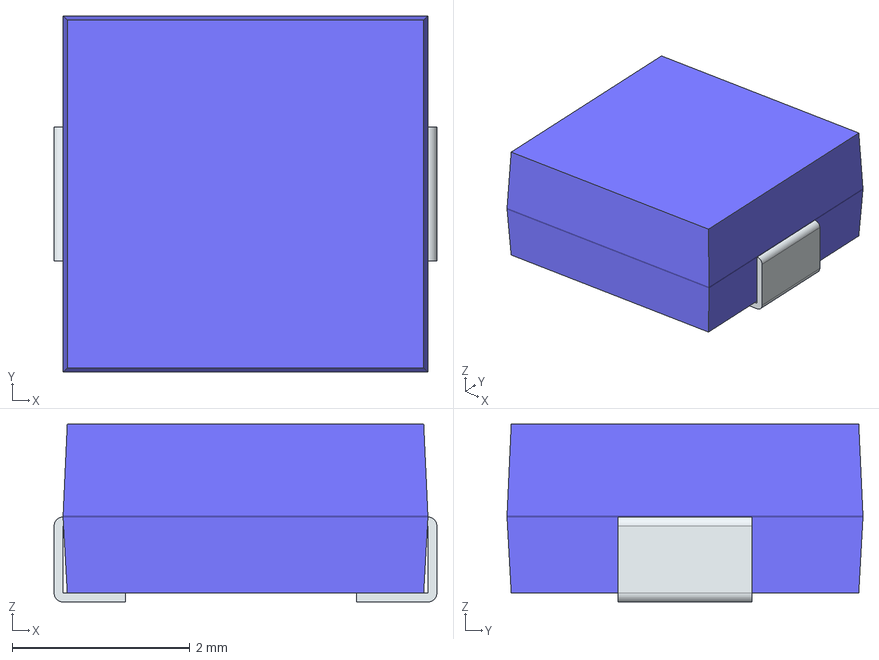
[picture p16: CAD file, 2025-04-08]
Footprints/Inductors/100M/YSPI0420-100M.stp
4.30 x 4.00 x 2.00 mm
FilletPin1
FilletPin2
