koradeh/STM32_Drone/Footprints/KLJ-4020/KLJ-4020.stp

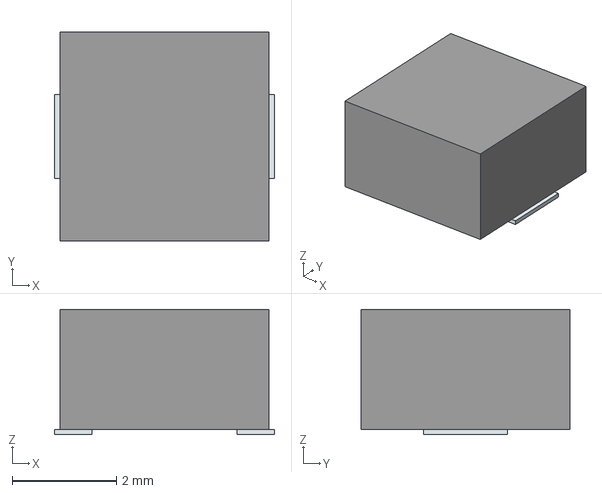
[picture p17: CAD file, 2025-04-08]
Footprints/KLJ-4020/KLJ-4020.stp
4.22 x 4.00 x 2.40 mm
Pins
