koradeh/STM32_Drone/Footprints/MMBT3904TT1G/MMBT3904TT1G.step

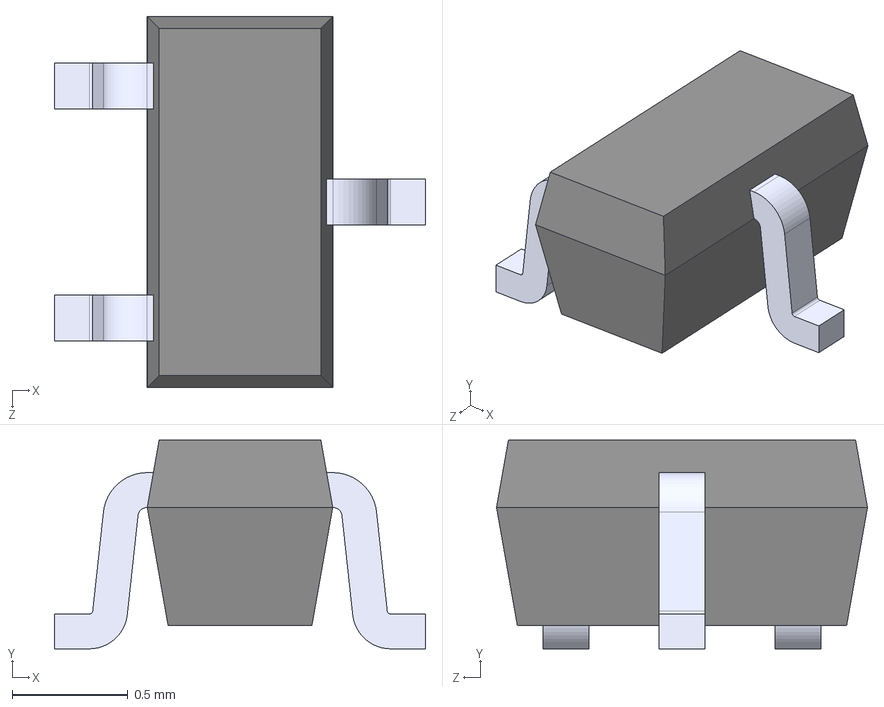
[picture p18: CAD file, 2025-04-08]
Footprints/MMBT3904TT1G/MMBT3904TT1G.step
1.60 x 0.9 x 1.60 mm
