koradeh/STM32_Drone/Footprints/MP9943GQZ/MP9943GQ-Z.step

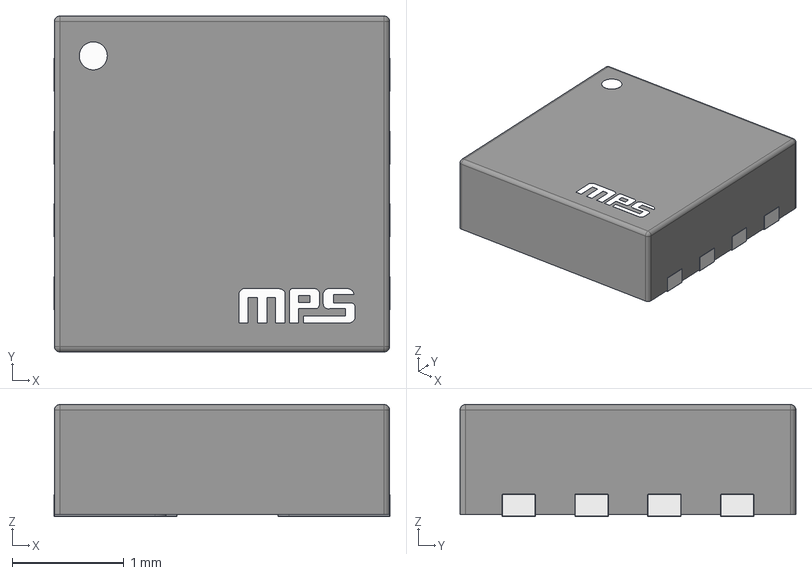
[picture p19: CAD file, 2025-04-08]
Footprints/MP9943GQZ/MP9943GQ-Z.step
3.00 x 3.00 x 1.00 mm
Pads
Pin1_Dot
Monolithic Power Systems
