koradeh/STM32_Drone/Footprints/SE2431/SE2431L_SKY.step

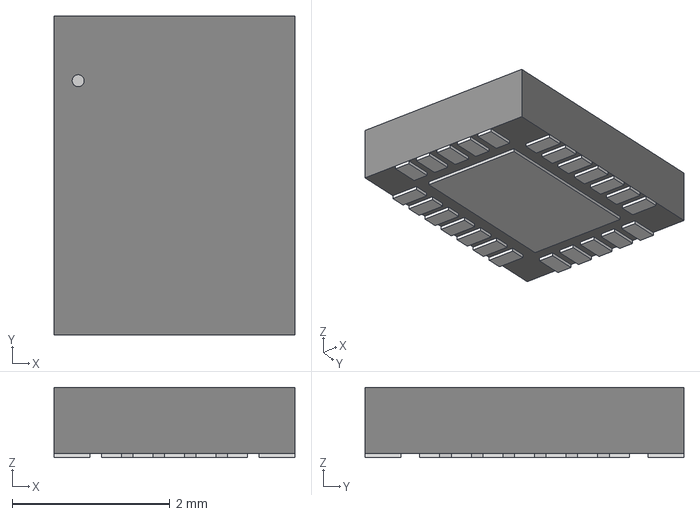
[picture p20: CAD file, 2025-04-08]
Footprints/SE2431/SE2431L_SKY.step
3.05 x 4.04 x 0.892 mm
