koradeh/STM32_Drone/Footprints/SM03B-SRSS-TB_LF__SN_/SM03B-SRSS-TB_LF__SN_.step

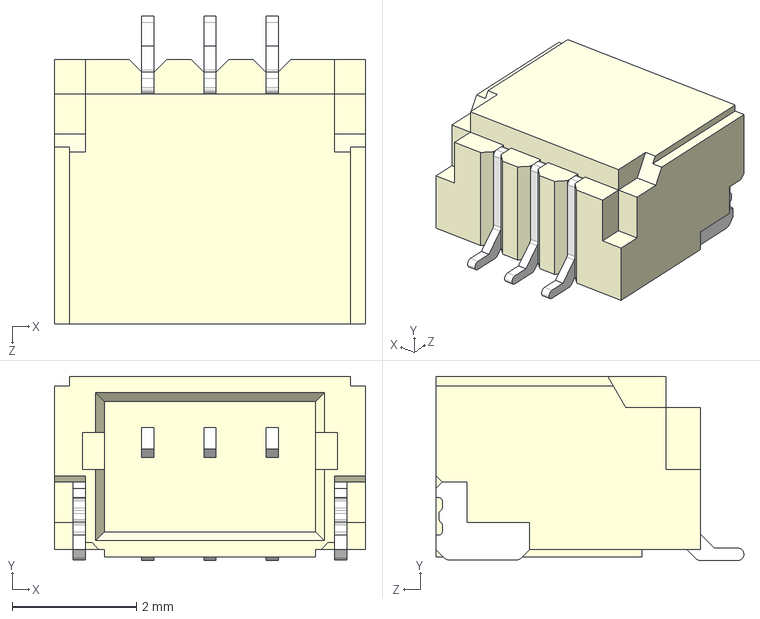
[picture p21: CAD file, 2025-04-08]
Footprints/SM03B-SRSS-TB_LF__SN_/SM03B-SRSS-TB_LF__SN_.step
5.00 x 2.96 x 4.95 mm
