koradeh/STM32_Drone/Footprints/SM04B-SRSS-TB_LF__SN_/SM04B-SRSS-TB_LF__SN_.step

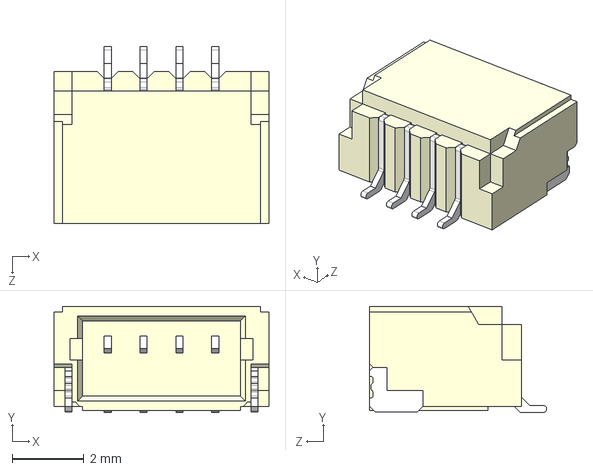
[picture p22: CAD file, 2025-04-08]
Footprints/SM04B-SRSS-TB_LF__SN_/SM04B-SRSS-TB_LF__SN_.step
6.00 x 2.96 x 4.95 mm
