koradeh/STM32_Drone/Footprints/SM06B-SRSS-TB_LF__SN_/SM06B-SRSS-TB_LF__SN_.step

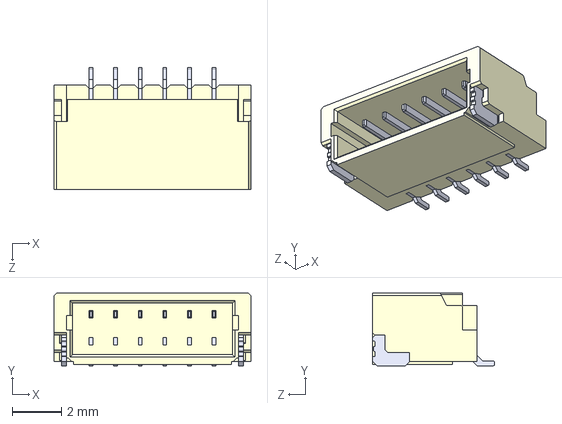
[picture p23: CAD file, 2025-04-08]
Footprints/SM06B-SRSS-TB_LF__SN_/SM06B-SRSS-TB_LF__SN_.step
8.00 x 2.95 x 4.95 mm
