koradeh/STM32_Drone/Footprints/SM08B-SRSS-TB_LF_SN_/SM08B-SRSS-TB_LF_SN.step

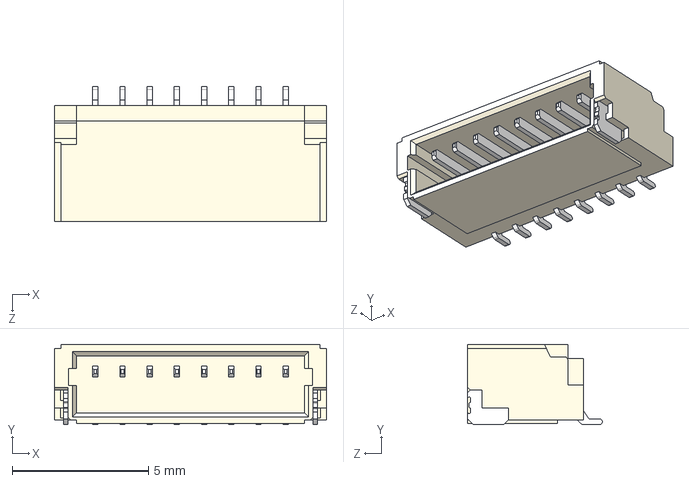
[picture p24: CAD file, 2025-04-08]
Footprints/SM08B-SRSS-TB_LF_SN_/SM08B-SRSS-TB_LF_SN.step
10.00 x 2.95 x 4.95 mm
