koradeh/STM32_Drone/Footprints/STM32F722RET6/STM32F722RET6.step

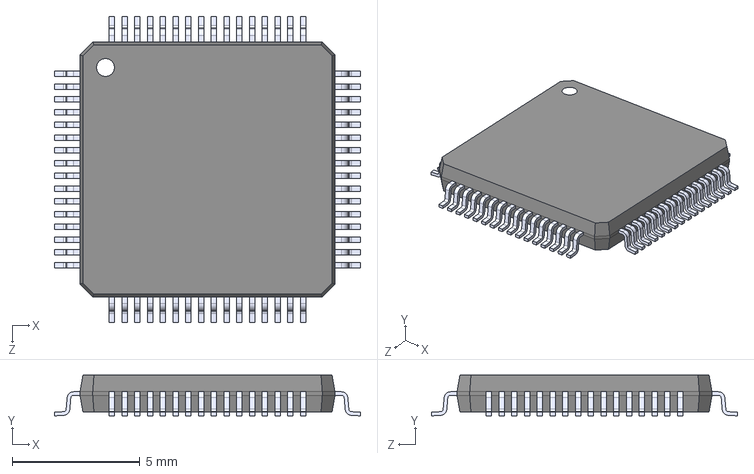
[picture p25: CAD file, 2025-04-08]
Footprints/STM32F722RET6/STM32F722RET6.step
12.0 x 1.60 x 12.0 mm
