koradeh/STM32_Drone/Footprints/SX1280/SX1280IMLTRT.step

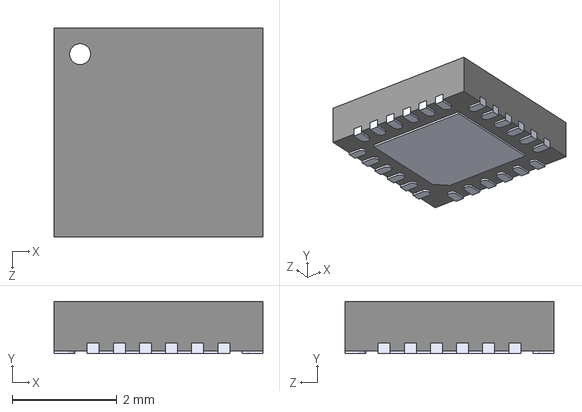
[picture p26: CAD file, 2025-04-08]
Footprints/SX1280/SX1280IMLTRT.step
4.00 x 1.00 x 4.00 mm
