koradeh/STM32_Drone/Footprints/TYPE-C_16PIN_2MD__073_/TYPE-C_16PIN_2MD__073_.step

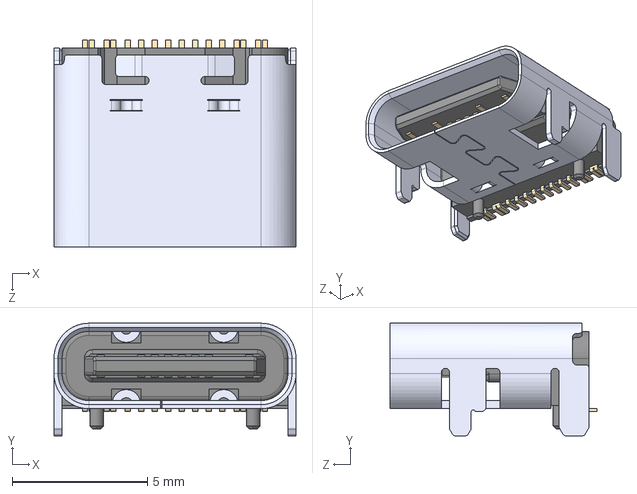
[picture p27: CAD file, 2025-04-08]
Footprints/TYPE-C_16PIN_2MD__073_/TYPE-C_16PIN_2MD__073_.step
8.94 x 4.16 x 7.65 mm
