koradeh/STM32_Drone/Footprints/USBLC6-2P6/USBLC6-2P6.step

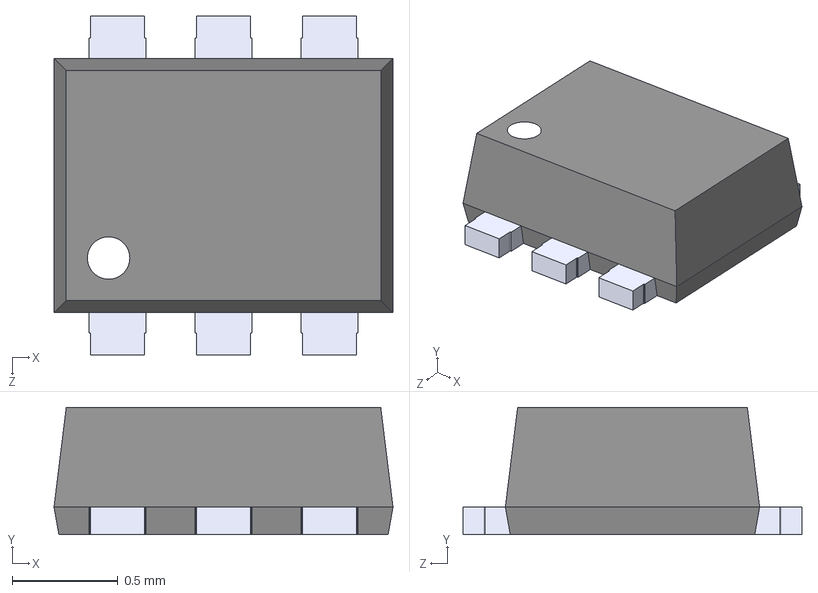
[picture p28: CAD file, 2025-04-08]
Footprints/USBLC6-2P6/USBLC6-2P6.step
1.60 x 0.6 x 1.60 mm
