koradeh/STM32_Drone/Footprints/W25Q128JVSIQ/W25Q128JVSIQ.step

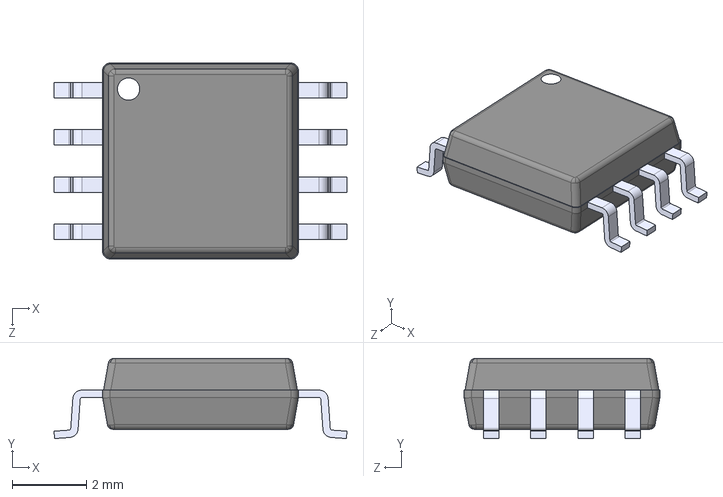
[picture p29: CAD file, 2025-04-08]
Footprints/W25Q128JVSIQ/W25Q128JVSIQ.step
7.90 x 2.16 x 5.28 mm
