koradeh/STM32_Drone/(list of files, cad)

Other CAD files:
Footprints/503398-1892/503398-1892.step
Footprints/TLV75733PDBVR/TLV75733PDBVR.step
Footprints/X50328MSB2GI/X50328MSB2GI.step
