koradeh/STM32_Drone/ZenFlyF72_Refine/ZenFly F71.kicad_pcb

## KiCad design ZenFlyF72_Refine/ZenFly F71.kicad_pcb (2025-04-08)

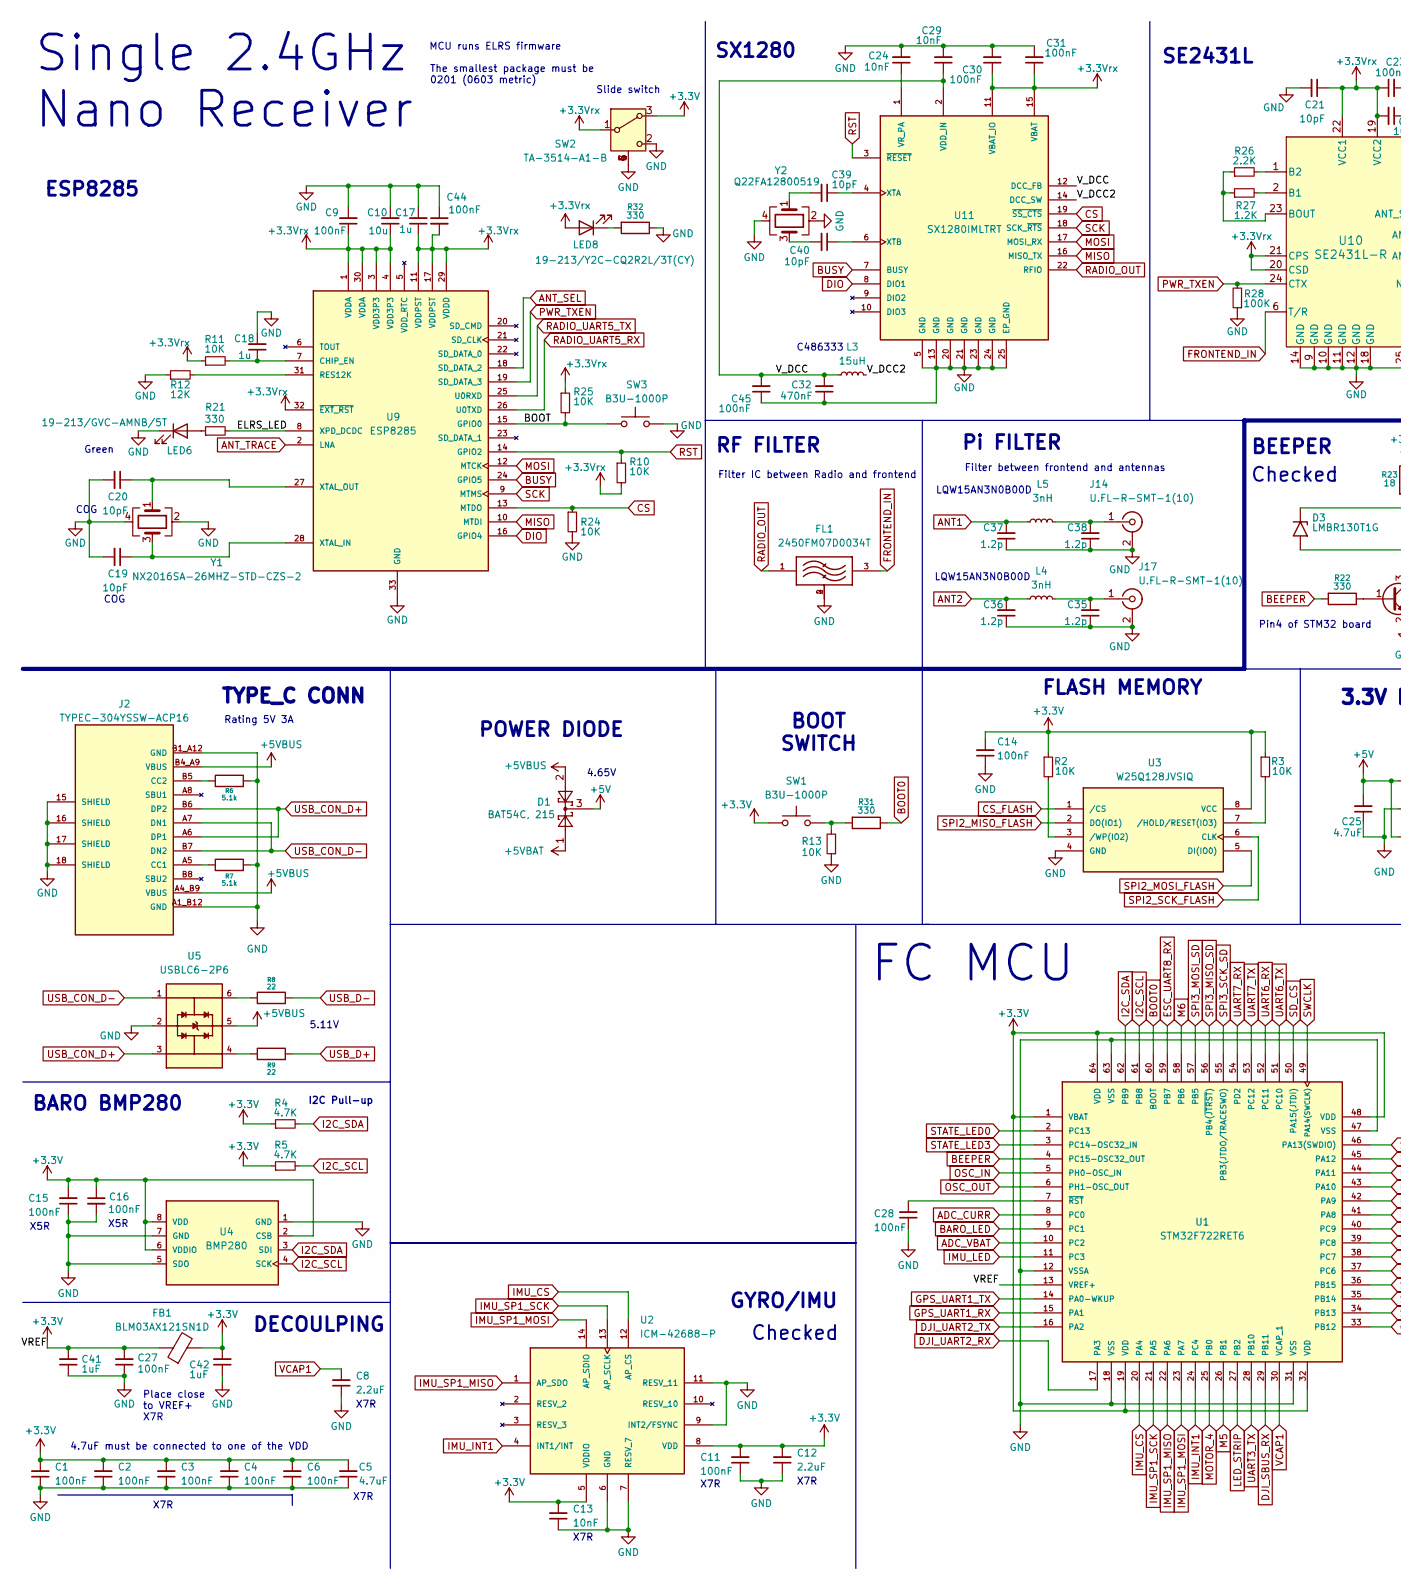
[picture p30: schematic ZenFly F71.kicad_sch, part in row 1, column 1]

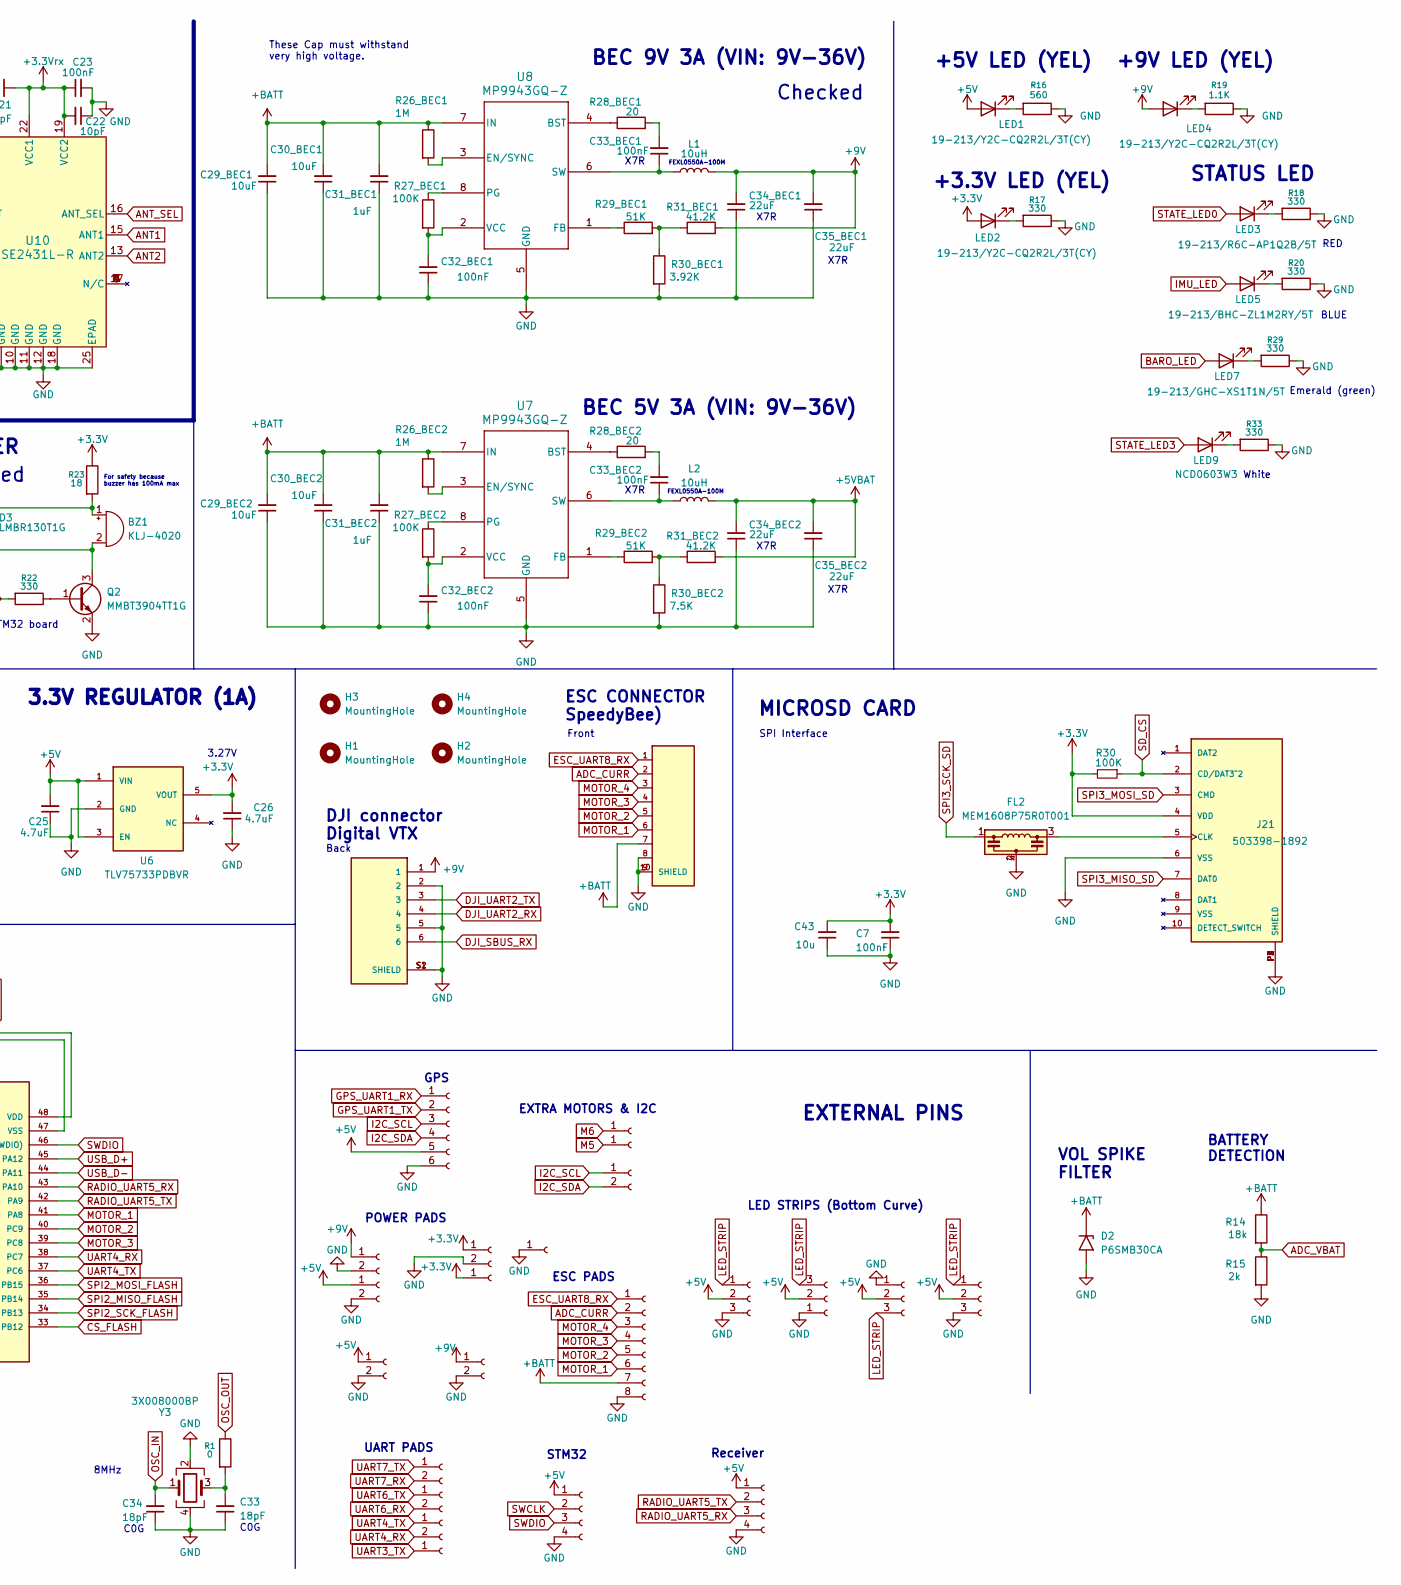
[picture p31: schematic ZenFly F71.kicad_sch, part in row 1, column 2]

Parts:
BZ1: KLJ-4020
C1, C2, C3, C4, C6, C7, C9, C11, C14, C15, C16, C23, C27, C28, C30, C31, C33_BEC1, C33_BEC2, C44, C45: 100nF; C_0201_0603Metric
C5, C25, C26: 4.7uF; C_0603_1608Metric
C8, C12: 2.2uF; C_0402_1005Metric
C10, C43: 10u; C_0603_1608Metric
C13, C24, C29: 10nF; C_0201_0603Metric
C17, C18: 1u; C_0402_1005Metric
C19, C20, C21, C22, C39, C40: 10pF; C_0201_0603Metric
C29_BEC1, C29_BEC2, C30_BEC1, C30_BEC2: 10uF; C_0805_2012Metric
C31_BEC1, C31_BEC2, C41, C42: 1uF; C_0402_1005Metric
C32: 470nF; C_0402_1005Metric
C32_BEC1, C32_BEC2: 100nF; C_0402_1005Metric
C33, C34: 18pF; C_0201_0603Metric
C34_BEC1, C35_BEC1: 22uF; C_0603_1608Metric
C34_BEC2, C35_BEC2: 22uF; C_0402_1005Metric
C35, C36, C37, C38: 1.2p; C_0201_0603Metric
D1: BAT54C, 215; SMD-DIODE-SCHOTTKY-30V-200MA_SOT-23
D2: P6SMB30CA; D_SMB
D3: LMBR130T1G; D_SOD-123
FB1: BLM03AX121SN1D; C_0201_0603Metric
FL1: 2450FM07D0034T; PARTREV 1.2
FL2: MEM1608P75R0T001
H1, H2, H3, H4: MountingHole; MountingHole_3.2mm_M3
J1, J6, J9, J10, J13, J22, J23, J25, J27: Conn_01x02_Socket; SMD_2Pads_Small
J2: TYPEC-304YSSW-ACP16; TYPEC-304-ACP16_XNP; PARTREV A
J3, J18, J19, J20: Conn_01x03_Socket; SMD_3Pads_41mmCurve
J4: SM06B-SRSS-TB_LF__SN_; JST_SM06B-SRSS-TB_LF__SN_
J5, J7: Conn_01x04_Socket; SMD_4Pads_Small
J8: SM08B-SRSS-TB_LF__SN_; SM08B-SRSS-TB_LF_SN
J11: Conn_01x06_Socket; SMD_6Pads_Small
J12, J15, J24, J26, J28: Conn_01x01_Socket; SMD_1Pad_Small
J14, J17: U.FL-R-SMT-1(10); U.FL_Hirose_U.FL-R-SMT-1_Vertical
J16: Conn_01x08_Socket; SMD_8Pads_Small
J21: 503398-1892; MOLEX_503398-1892; PARTREV 0
L1, L2: 10uH; FEXL0550A-100M
L3: 15uH; L_0805_2012Metric
L4, L5: 3nH; L_0402_1005Metric
LED1, LED2, LED4, LED8: 19-213/Y2C-CQ2R2L/3T(CY); LED_0603
LED3: 19-213/R6C-AP1Q2B/5T; LED_0603
LED5: 19-213/BHC-ZL1M2RY/5T; LED_0603
LED6: 19-213/GVC-AMNB/5T; LED_0603
LED7: 19-213/GHC-XS1T1N/5T; LED_0603
LED9: NCD0603W3; LED_0603
Q2: MMBT3904TT1G; TRANS_MMBT3904TT1G
R1: 0; R_0201_0603Metric
R2, R3, R10, R11, R13, R24, R25: 10K; R_0201_0603Metric
R4, R5: 4.7K; R_0201_0603Metric
R6, R7: 5.1k; R_0402_1005Metric
R8, R9: 22; R_0201_0603Metric
R12: 12K; R_0402_1005Metric
R14: 18k; R_0402_1005Metric
R15: 2k; R_0201_0603Metric
R16: 560; R_0201_0603Metric
R17, R18, R20, R21, R22, R29, R31, R32, R33: 330; R_0201_0603Metric
R19: 1.1K; R_0201_0603Metric
R23: 18; R_0201_0603Metric
R26: 2.2K; R_0201_0603Metric
R26_BEC1, R26_BEC2: 1M; R_0402_1005Metric
R27: 1.2K; R_0201_0603Metric
R27_BEC1, R27_BEC2: 100K; R_0402_1005Metric
R28, R30: 100K; R_0201_0603Metric
R28_BEC1, R28_BEC2: 20; R_0402_1005Metric
R29_BEC1, R29_BEC2: 51K; R_0402_1005Metric
R30_BEC1: 3.92K; R_0402_1005Metric
R30_BEC2: 7.5K; R_0402_1005Metric
R31_BEC1, R31_BEC2: 41.2K; R_0402_1005Metric
SW1, SW3: B3U-1000P; SW_B3U-1000P
SW2: TA-3514-A1-B; Slide Switch TA-3514-A1-B
U1: STM32F722RET6
U2: ICM-42688-P; PARTREV 1.2
U3: W25Q128JVSIQ; SOIC127P790X216-8N; PARTREV I
U4: BMP280; XDCR_BMP280; PART_REV 1.19
U5: USBLC6-2P6; PARTREV 5
U6: TLV75733PDBVR; PARTREV Aprill 2011
U7, U8: MP9943GQ-Z; QFN-8_MP9943_MNP
U9: ESP8285; QFN50P500X500X90-33N; PARTREV 2.0
U10: SE2431L-R; SE2431L_SKY-L
U11: SX1280IMLTRT; XCVR_SX1280IMLTRT; PARTREV 3.3
Y1: NX2016SA-26MHZ-STD-CZS-2; Crystal_SMD_2016-4Pin_2.0x1.6mm
Y2: Q22FA12800519; Crystal_SMD_2016-4Pin_2.0x1.6mm
Y3: 3X008000BP; Crystal_SMD_3225-4Pin_3.2x2.5mm

Connections:
+3.3V: C1.2, C2.2, C3.2, C4.2, C5.2, C6.2, C7.2, C11.2, C12.2, C13.2, C14.2, C15.2, C16.1, C26.2, C27.2, C41.2, C42.2, C43.2, FB1.1, FB1.2, J10.1, J15.1, J21.4 (VDD), LED2.E, R2.1, R3.1, R4.1, R5.1, R23.1, R30.2, SW1.1, SW2.3 (A), U1.1 (VBAT), U1.13 (VREF+), U1.19 (VDD), U1.32 (VDD), U1.48 (VDD), U1.64 (VDD), U2.5 (VDDIO), U2.8 (VDD), U3.8 (VCC), U4.2 (CSB), U4.6 (VDDIO), U4.8 (VDD), U6.5 (VOUT)
+3.3Vrx: C9.1, C10.1, C17.1, C21.1, C22.2, C23.1, C30.1, C31.1, C44.2, LED8.E, R10.2, R11.1, R25.1, SW2.1 (B), U9.1 (VDDA), U9.3 (VDD3P3), U9.4 (VDD3P3), U9.11 (VDDPST), U9.17 (VDDPST), U9.29 (VDDD), U9.30 (VDDA), U9.32 (~EXT_RST), U10.19 (VCC2), U10.20 (CSD), U10.21 (CPS), U10.22 (VCC1), U11.11 (VBAT_IO), U11.15 (VBAT)
+5V: C25.2, D1.3, J3.2, J5.1, J7.1, J11.5, J13.1, J18.2, J19.2, J20.2, J27.1, LED1.E, U6.1 (VIN), U6.3 (EN)
+5VBAT: C34_BEC2.2, C35_BEC2.2, D1.1, L2.2, R31_BEC2.2
+5VBUS: D1.2, J2.A4_B9 (VBUS), J2.B4_A9 (VBUS), U5.5
+9V: C34_BEC1.2, C35_BEC1.2, J4.1, J6.1, J22.1, L1.2, LED4.E, R31_BEC1.2
+BATT: C29_BEC1.2, C29_BEC2.2, C30_BEC1.2, C30_BEC2.2, C31_BEC1.2, C31_BEC2.2, D2.1 (A1), J8.7, J16.7, R14.1, R26_BEC1.1, R26_BEC2.1, U7.7 (IN), U8.7 (IN)
/BOOT: R25.2, SW3.1, U9.15 (GPIO0)
/ELRS_LED: R21.2, U9.8 (XPD_DCDC)
/V_DCC: C29.1, C32.2, C45.2, L3.1, U11.2 (VDD_IN), U11.12 (DCC_FB)
/V_DCC2: L3.2, U11.14 (DCC_SW)
ADC_CURR: J8.2, J16.2, U1.8 (PC0)
ADC_VBAT: R14.2, R15.1, U1.10 (PC2)
ANT1: C37.2, L5.1, U10.15 (ANT1)
ANT2: C36.2, L4.1, U10.13 (ANT2)
ANT_SEL: U9.18 (SD_DATA_2), U10.16 (ANT_SEL)
ANT_TRACE: U9.2 (LNA)
BARO_LED: LED7.E, U1.9 (PC1)
BEEPER: R22.2, U1.4 (PC15-OSC32_OUT)
BOOT0: R31.1, U1.60 (BOOT)
BUSY: U9.24 (GPIO5), U11.7 (BUSY)
CS: R24.1, U9.13 (MTDO), U11.19 (~SS_CTS)
CS_FLASH: U1.33 (PB12), U3.1 (/CS)
DIO: U9.16 (GPIO4), U11.8 (DIO1)
DJI_SBUS_RX: J4.6, U1.29 (PB11)
DJI_UART2_RX: J4.4, U1.17 (PA3)
DJI_UART2_TX: J4.3, U1.16 (PA2)
ESC_UART8_RX: J8.1, J16.1, U1.59 (PB7)
FRONTEND_IN: FL1.3, U10.6 (T/R)
GND: C1.1, C2.1, C3.1, C4.1, C5.1, C6.1, C7.1, C8.1, C9.2, C10.2, C11.1, C12.1, C13.1, C14.1, C15.1, C16.2, C17.2, C18.2, C19.2, C20.2, C21.2, C22.1, C23.2, C24.2, C25.1, C26.1, C27.1, C28.1, C29.2, C29_BEC1.1, C29_BEC2.1, C30.2, C30_BEC1.1, C30_BEC2.1, C31.2, C31_BEC1.1, C31_BEC2.1, C32.1, C32_BEC1.1, C32_BEC2.1, C33.1, C34.1, C34_BEC1.1, C34_BEC2.1, C35.1, C35_BEC1.1, C35_BEC2.1, C36.1, C37.1, C38.1, C41.1, C42.1, C43.1, C44.1, C45.1, D2.2 (A2), FL1.2, FL1.4, FL2.2, FL2.4, J2.15 (SHIELD), J2.16 (SHIELD), J2.17 (SHIELD), J2.18 (SHIELD), J2.A1_B12 (GND), J2.B1_A12 (GND), J3.1, J4.2, J4.5, J4.S1 (SHIELD), J4.S2 (SHIELD), J5.4, J6.2, J7.4, J8.8, J8.9 (SHIELD), J8.10 (SHIELD), J10.2, J11.6, J12.1, J13.2, J14.2 (Ext), J16.8, J17.2 (Ext), J18.3, J19.3, J20.1, J21.6 (VSS), J21.P1 (SHIELD), J21.P2 (SHIELD), J21.P3 (SHIELD), J21.P4 (SHIELD), J22.2, J27.2, LED6.C, Q2.2 (E), R6.2, R7.2, R12.1, R13.1, R15.2, R16.1, R17.1, R18.1, R19.1, R20.1, R24.2, R28.1, R29.1, R30_BEC1.2, R30_BEC2.2, R32.1, R33.1, SW2.2 (C), SW2.4 (G), SW2.5 (G), SW2.6 (G), SW2.7 (G), SW3.2, U1.12 (VSSA), U1.18 (VSS), U1.31 (VSS), U1.47 (VSS), U1.63 (VSS), U2.6 (GND), U2.7 (RESV_7), U2.9 (INT2/FSYNC), U2.11 (RESV_11), U3.4 (GND), U4.1 (GND), U4.5 (SDO), U4.7 (GND), U5.2, U6.2 (GND), U7.5 (GND), U8.5 (GND), U9.33 (GND), U10.9 (GND), U10.10 (GND), U10.11 (GND), U10.12 (GND), U10.14 (GND), U10.18 (GND), U10.25 (EPAD), U11.5 (GND), U11.13 (GND), U11.20 (GND), U11.21 (GND), U11.23 (GND), U11.24 (GND), U11.25 (EP_GND), Y1.2, Y1.4, Y2.2, Y2.4, Y3.2, Y3.4
GPS_UART1_RX: J11.1, U1.15 (PA1)
GPS_UART1_TX: J11.2, U1.14 (PA0-WKUP)
I2C_SCL: J1.1, J11.3, R5.2, U1.61 (PB8), U4.4 (SCK)
I2C_SDA: J1.2, J11.4, R4.2, U1.62 (PB9), U4.3 (SDI)
IMU_CS: U1.20 (PA4), U2.12 (AP_CS)
IMU_INT1: U1.24 (PC4), U2.4 (INT1/INT)
IMU_LED: LED5.E, U1.11 (PC3)
IMU_SP1_MISO: U1.22 (PA6), U2.1 (AP_SDO)
IMU_SP1_MOSI: U1.23 (PA7), U2.14 (AP_SDIO)
IMU_SP1_SCK: U1.21 (PA5), U2.13 (AP_SCLK)
LED_STRIP: J3.3, J18.1, J19.1, J20.3, U1.27 (PB2)
M5: J28.1, U1.26 (PB1)
M6: J24.1, U1.58 (PB6)
MISO: U9.10 (MTDI), U11.16 (MISO_TX)
MOSI: U9.12 (MTCK), U11.17 (MOSI_RX)
MOTOR_1: J8.6, J16.6, U1.41 (PA8)
MOTOR_2: J8.5, J16.5, U1.40 (PC9)
MOTOR_3: J8.4, J16.4, U1.39 (PC8)
MOTOR_4: J8.3, J16.3, U1.25 (PB0)
unnamed: BZ1.1 (+), D3.1 (A1), R23.2
unnamed: BZ1.2 (-), D3.2 (A2), Q2.3 (C)
unnamed: C33.2, R1.2, Y3.3
unnamed: C33_BEC1.2, R28_BEC1.2
unnamed: C33_BEC2.2, R28_BEC2.2
unnamed: C39.2, Y2.1
unnamed: C40.2, Y2.3
unnamed: J2.A5 (CC1), R7.1
unnamed: J2.B5 (CC2), R6.1
unnamed: C38.2, J14.1 (In), L5.2
unnamed: C35.2, J17.1 (In), L4.2
unnamed: FL2.3, J21.5 (CLK)
unnamed: LED1.C, R16.2
unnamed: LED2.C, R17.2
unnamed: LED3.C, R18.2
unnamed: LED4.C, R19.2
unnamed: LED5.C, R20.2
unnamed: LED6.E, R21.1
unnamed: LED7.C, R29.2
unnamed: LED8.C, R32.2
unnamed: LED9.C, R33.2
unnamed: Q2.1 (B), R22.1
unnamed: R8.1, U5.6
unnamed: R9.1, U5.4
unnamed: R13.2, R31.2, SW1.2
unnamed: R29_BEC1.2, R30_BEC1.1, R31_BEC1.1
unnamed: R29_BEC2.2, R30_BEC2.1, R31_BEC2.1
unnamed: C28.2, U1.7 (~RST)
unnamed: R3.2, U3.7 (/HOLD/RESET(IO3))
unnamed: R2.2, U3.3 (/WP(IO2))
unnamed: R28_BEC2.1, U7.4 (BST)
unnamed: R26_BEC2.2, U7.3 (EN/SYNC)
unnamed: R29_BEC2.1, U7.1 (FB)
unnamed: R27_BEC2.1, U7.8 (PG)
unnamed: C33_BEC2.1, L2.1, U7.6 (SW)
unnamed: C32_BEC2.2, R27_BEC2.2, U7.2 (VCC)
unnamed: R28_BEC1.1, U8.4 (BST)
unnamed: R26_BEC1.2, U8.3 (EN/SYNC)
unnamed: R29_BEC1.1, U8.1 (FB)
unnamed: R27_BEC1.1, U8.8 (PG)
unnamed: C33_BEC1.1, L1.1, U8.6 (SW)
unnamed: C32_BEC1.2, R27_BEC1.2, U8.2 (VCC)
unnamed: C18.1, R11.2, U9.7 (CHIP_EN)
unnamed: R12.2, U9.31 (RES12K)
unnamed: C19.1, U9.28 (XTAL_IN), Y1.3
unnamed: C20.1, U9.27 (XTAL_OUT), Y1.1
unnamed: R27.2, U10.2 (B1)
unnamed: R26.2, U10.1 (B2)
unnamed: R26.1, R27.1, U10.23 (BOUT)
unnamed: C24.1, U11.1 (VR_PA)
unnamed: C39.1, U11.4 (XTA)
unnamed: C40.1, U11.6 (XTB)
OSC_IN: C34.2, U1.5 (PH0-OSC_IN), Y3.1
OSC_OUT: R1.1, U1.6 (PH1-OSC_OUT)
PWR_TXEN: R28.2, U9.19 (SD_DATA_3), U10.24 (CTX)
RADIO_OUT: FL1.1, U11.22 (RFIO)
RADIO_UART5_RX: J5.3, U1.43 (PA10), U9.26 (U0TXD)
RADIO_UART5_TX: J5.2, U1.42 (PA9), U9.25 (U0RXD)
RST: R10.1, U9.14 (GPIO2), U11.3 (~RESET)
SCK: U9.9 (MTMS), U11.18 (SCK_~RTS)
SD_CS: J21.2 (CD/DAT3^2), R30.1, U1.50 (PA15(JTDI))
SPI2_MISO_FLASH: U1.35 (PB14), U3.2 (DO(IO1))
SPI2_MOSI_FLASH: U1.36 (PB15), U3.5 (DI(IO0))
SPI2_SCK_FLASH: U1.34 (PB13), U3.6 (CLK)
SPI3_MISO_SD: J21.7 (DAT0), U1.56 (PB4(~JTRST))
SPI3_MOSI_SD: J21.3 (CMD), U1.57 (PB5)
SPI3_SCK_SD: FL2.1, U1.55 (PB3(JTDO/TRACESWO))
STATE_LED0: LED3.E, U1.2 (PC13)
STATE_LED3: LED9.E, U1.3 (PC14-OSC32_IN)
SWCLK: J7.2, U1.49 (PA14(SWCLK))
SWDIO: J7.3, U1.46 (PA13(SWDIO))
UART3_TX: J26.1, U1.28 (PB10)
UART4_RX: J25.2, U1.38 (PC7)
UART4_TX: J25.1, U1.37 (PC6)
UART6_RX: J23.2, U1.52 (PC11)
UART6_TX: J23.1, U1.51 (PC10)
UART7_RX: J9.2, U1.54 (PD2)
UART7_TX: J9.1, U1.53 (PC12)
USB_CON_D+: J2.A6 (DP1), J2.B6 (DP2), U5.3
USB_CON_D-: J2.A7 (DN1), J2.B7 (DN2), U5.1
USB_D+: R9.2, U1.45 (PA12)
USB_D-: R8.2, U1.44 (PA11)
VCAP1: C8.2, U1.30 (VCAP_1)

Notes on the sheet:
LQW15AN3N0B00D
Rating 5V 3A
ESC CONNECTOR SpeedyBee)
Checked
X7R
Pin4 of STM32 board
+3.3V LED (YEL)
UART PADS
Single 2.4GHz Nano Receiver
BLUE
Place close to VREF+ X7R
RF FILTER
STM32
SX1280
FEXL0550A-100M
SE2431L
C486333
STATUS LED
White
X5R
BEC 5V 3A (VIN: 9V-36V)
Back
These Cap must withstand very high voltage.
LED STRIPS (Bottom Curve)
Filter IC between Radio and frontend
Emerald (green)
EXTERNAL PINS
BEC 9V 3A (VIN: 9V-36V)
C0G
COG
5.11V
POWER DIODE
Receiver
4.65V
BOOT SWITCH
Front
DECOULPING
GPS
+9V LED (YEL)
Filter between frontend and antennas
VOL SPIKE FILTER
BATTERY DETECTION
The smallest package must be 0201 (0603 metric)
3.27V
ESP8285
TYPE_C CONN
ESC PADS
BARO BMP280
For safety because buzzer has 100mA max
MICROSD CARD
3.3V REGULATOR (1A)
+5V LED (YEL)
FLASH MEMORY
FC MCU
8MHz
MCU runs ELRS firmware
Slide switch
I2C Pull-up
POWER PADS
4.7uF must be connected to one of the VDD
DJI connector Digital VTX
SPI Interface
RED
BEEPER
Pi FILTER
Green
GYRO/IMU
EXTRA MOTORS & I2C

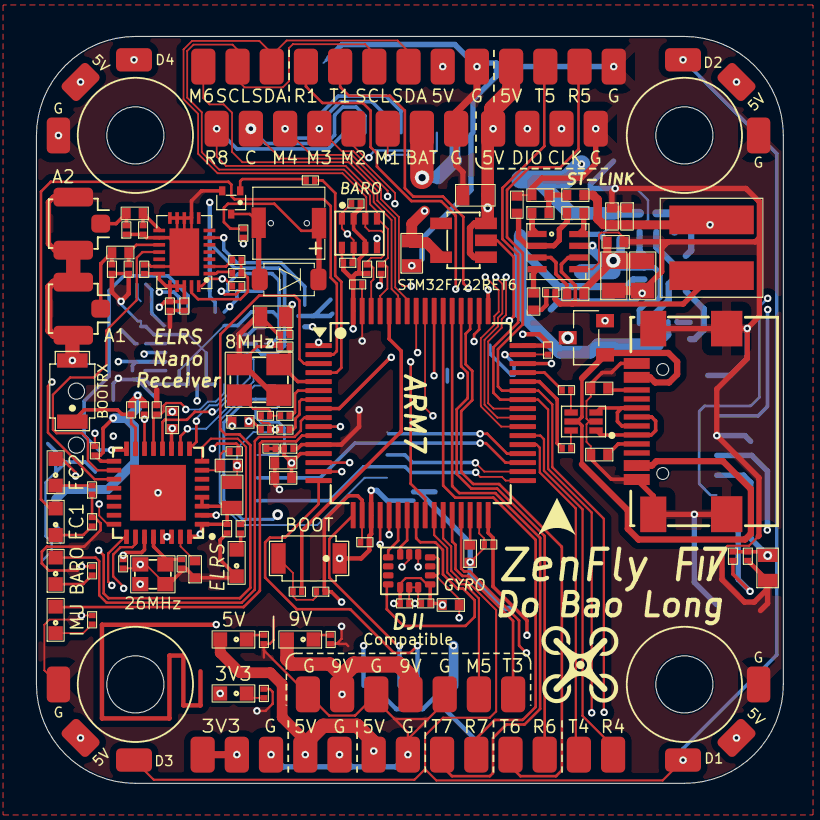
[picture p32: board ZenFly F71.kicad_pcb from above]

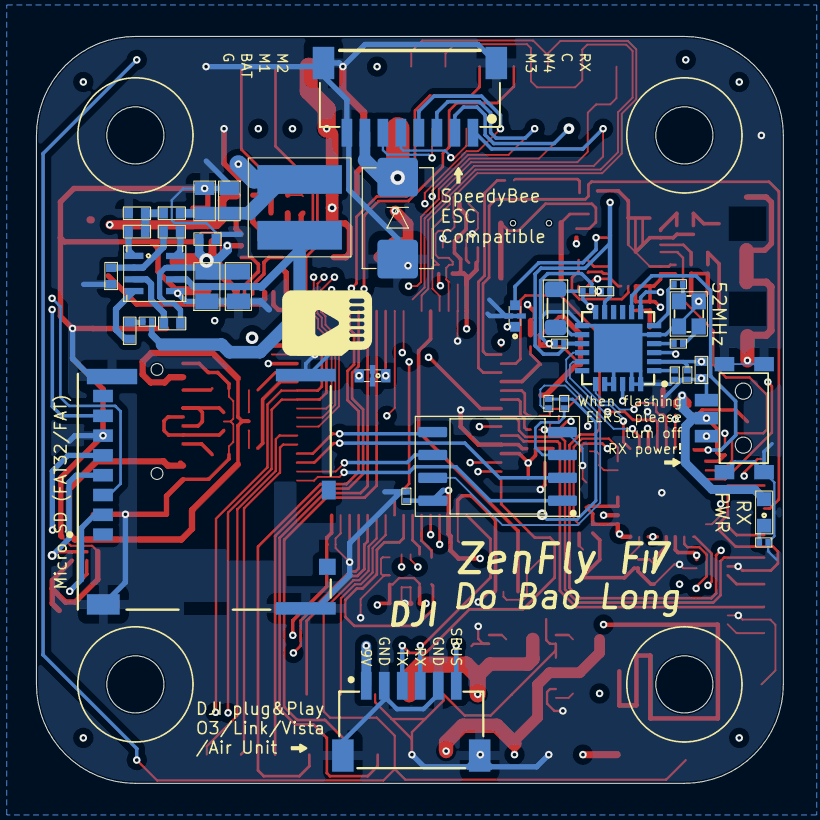
[picture p33: board ZenFly F71.kicad_pcb from below]

Board: 4 copper layers, 41.5 x 41.5 mm, 175 parts (39 on the bottom side), 131 nets.
