koradeh/STM32_Drone/Flight Controller Sample/STM32F7_FC-main/Flight_Controller.kicad_pcb

## KiCad design Flight Controller Sample/STM32F7_FC-main/Flight_Controller.kicad_pcb (2025-04-08)

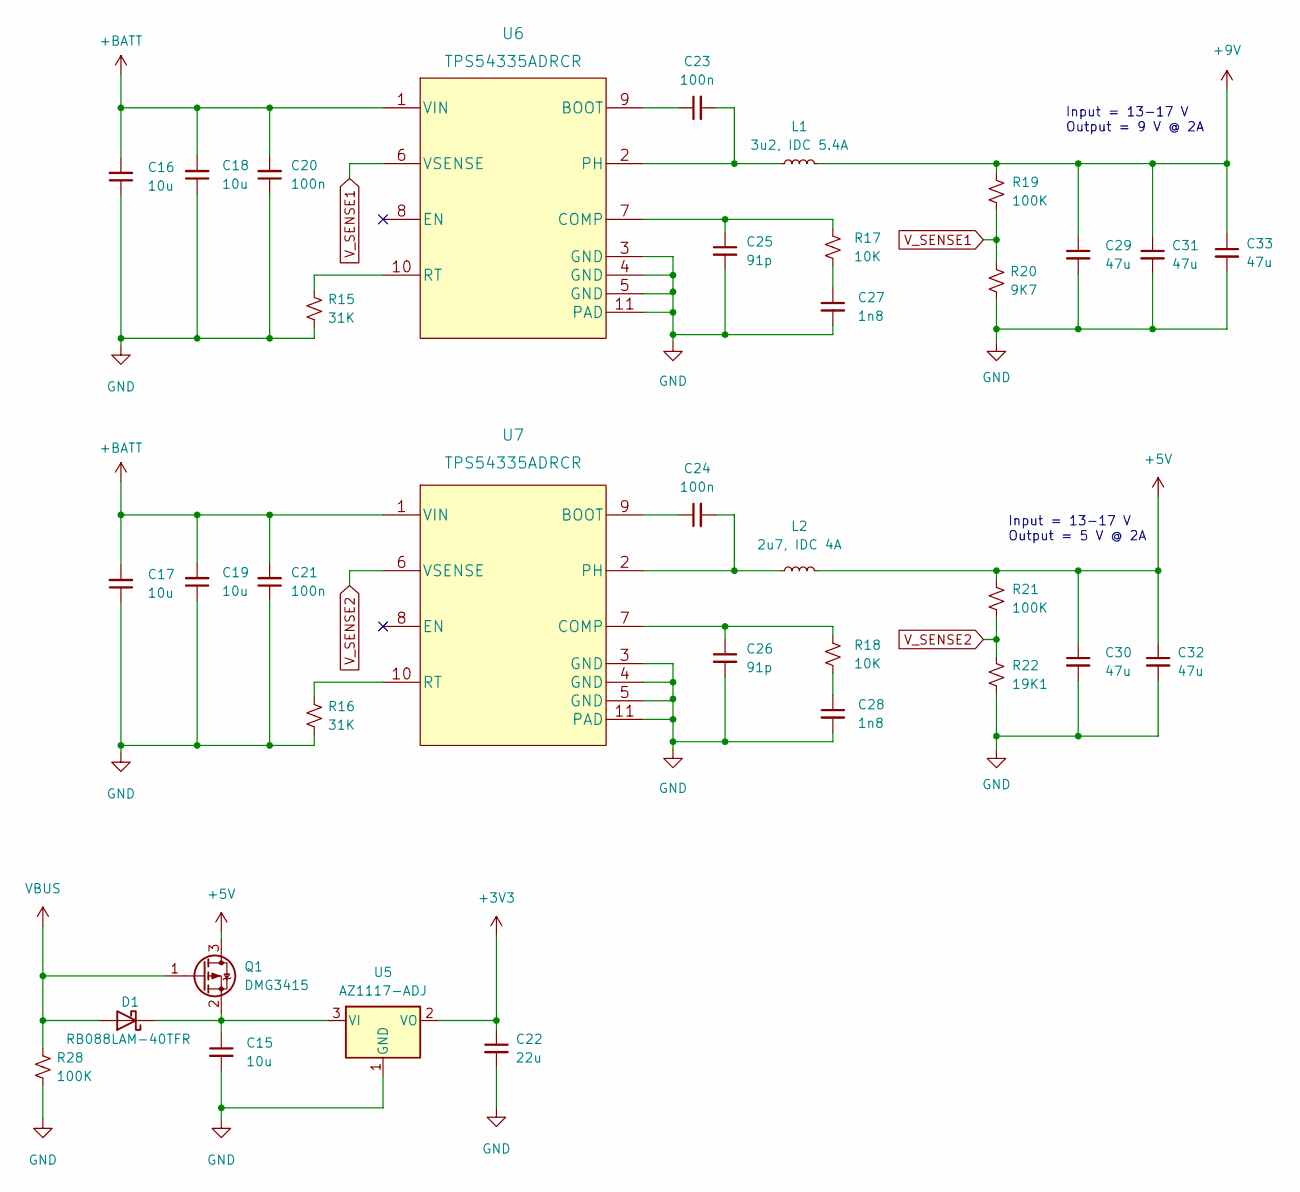
[picture p34: schematic FC_Power.kicad_sch]

Parts:
C15, C16, C17, C18, C19: 10u; C_0805_2012Metric
C20, C21, C23, C24: 100n; C_0402_1005Metric
C22: 22u; C_0805_2012Metric
C25, C26: 91p; C_0201_0603Metric
C27, C28: 1n8; C_0603_1608Metric
C29, C30, C31, C32, C33: 47u; C_1210_3225Metric
D1: RB088LAM-40TFR; D_SOD-123
L1: 3u2, IDC 5.4A; MDE0530-6R8M
L2: 2u7, IDC 4A; MDE0530-6R8M
Q1: DMG3415; SOT-23
R15, R16: 31K; R_0402_1005Metric
R17, R18: 10K; R_0402_1005Metric
R19: 100K; R_0402_1005Metric
R20: 9K7; R_0402_1005Metric
R21, R28: 100K; R_0201_0603Metric
R22: 19K1; R_0201_0603Metric
U5: AZ1117-ADJ; SOT-223-3_TabPin2
U6, U7: TPS54335ADRCR

Connections:
+3V3: C22.1, U5.2 (VO); also elsewhere on the board
+5V: C30.1, C32.1, L2.2, Q1.3 (D), R21.1; also elsewhere on the board
+9V: C29.1, C31.1, C33.1, L1.2, R19.1; also elsewhere on the board
+BATT: C16.2, C17.2, C18.2, C19.2, C20.2, C21.2, U6.1 (VIN), U7.1 (VIN); also elsewhere on the board
GND: C15.2, C16.1, C17.1, C18.1, C19.1, C20.1, C21.1, C22.2, C25.2, C26.2, C27.2, C28.2, C29.2, C30.2, C31.2, C32.2, C33.2, R15.2, R16.2, R20.2, R22.2, R28.2, U5.1 (GND), U6.3 (GND), U6.4 (GND), U6.5 (GND), U6.11 (PAD), U7.3 (GND), U7.4 (GND), U7.5 (GND), U7.11 (PAD); also elsewhere on the board
unnamed: C15.1, D1.1 (K), Q1.2 (S), U5.3 (VI)
unnamed: C23.1, U6.9 (BOOT)
unnamed: C23.2, L1.1, U6.2 (PH)
unnamed: C24.1, U7.9 (BOOT)
unnamed: C24.2, L2.1, U7.2 (PH)
unnamed: C25.1, R17.1, U6.7 (COMP)
unnamed: C26.1, R18.1, U7.7 (COMP)
unnamed: C27.1, R17.2
unnamed: C28.1, R18.2
unnamed: R15.1, U6.10 (RT)
unnamed: R16.1, U7.10 (RT)
VBUS: D1.2 (A), Q1.1 (G), R28.1; also elsewhere on the board
V_SENSE1: R19.2, R20.1, U6.6 (VSENSE)
V_SENSE2: R21.2, R22.1, U7.6 (VSENSE)

Notes on the sheet:
Input = 13-17 V Output = 9 V @ 2A
Input = 13-17 V Output = 5 V @ 2A

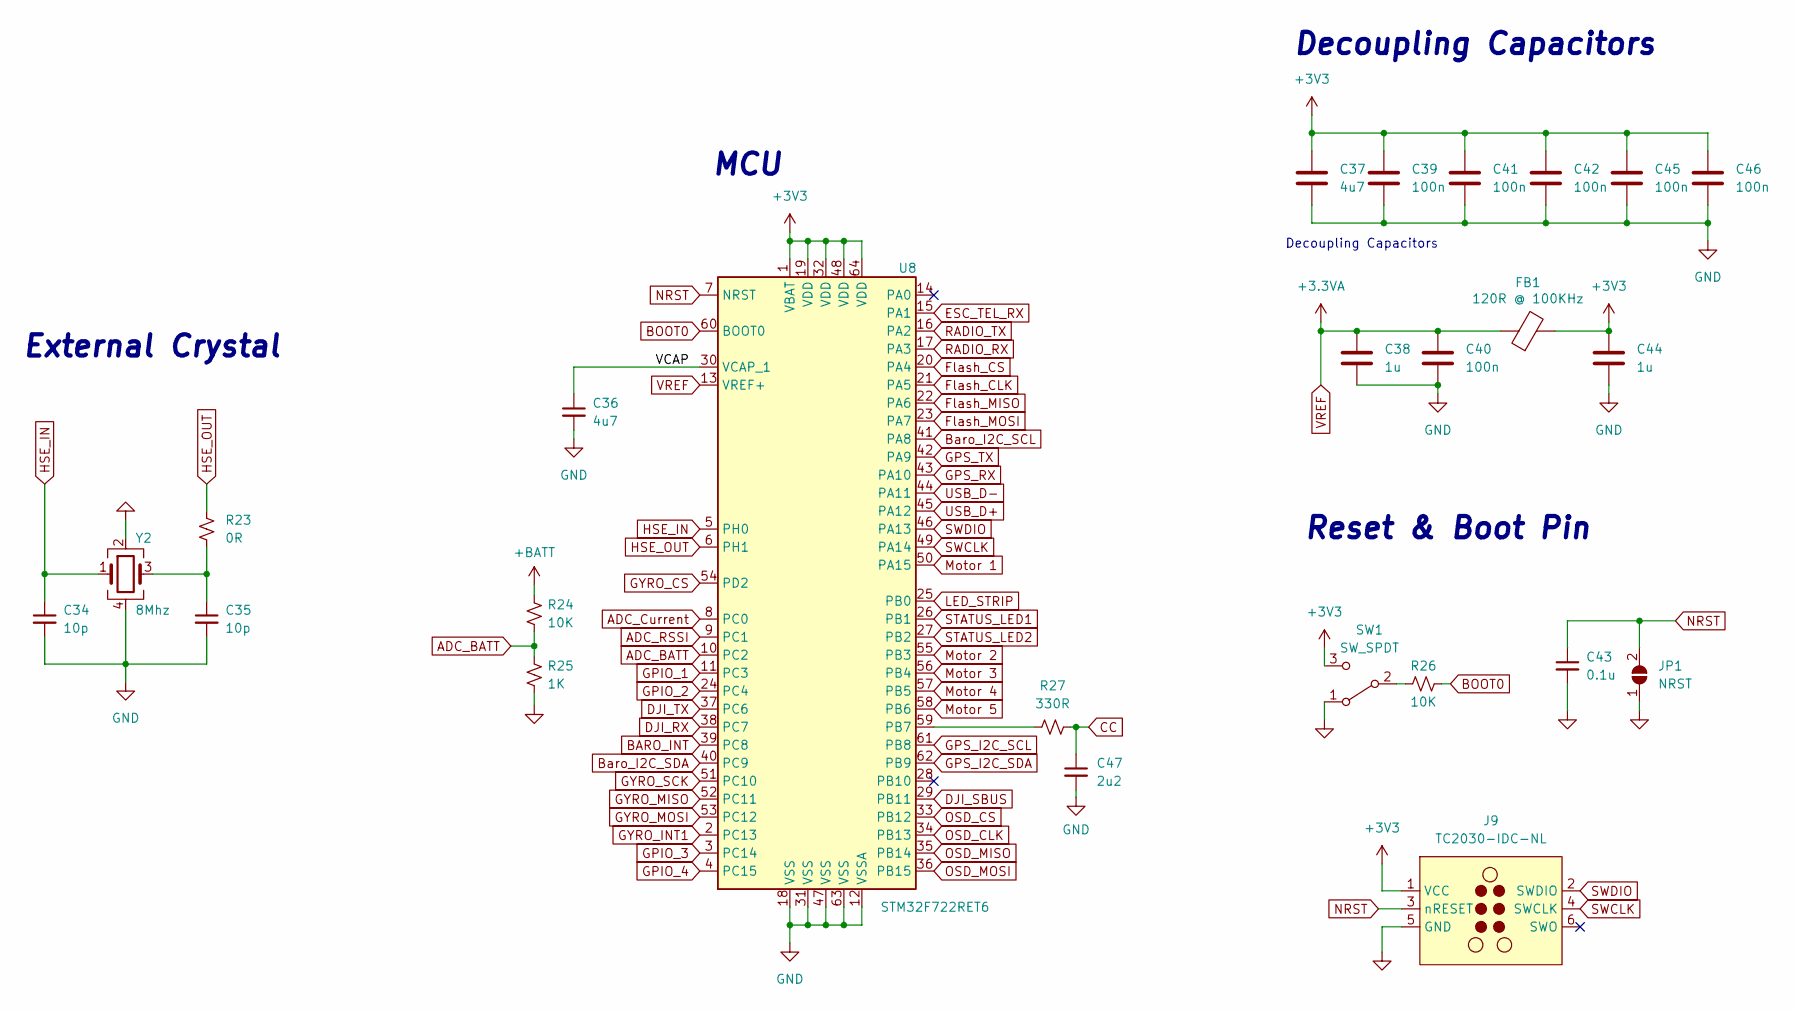
[picture p35: schematic FC_MCU.kicad_sch]

Parts:
C34, C35: 10p; C_0402_1005Metric
C36: 4u7; C_0603_1608Metric
C37: 4u7; C_0402_1005Metric
C38, C44: 1u; C_0402_1005Metric
C39, C40, C41, C42, C45, C46: 100n; C_0201_0603Metric
C43: 0.1u; C_0402_1005Metric
C47: 2u2; C_0603_1608Metric
FB1: 120R @ 100KHz; R_0603_1608Metric
J9: TC2030-IDC-NL; Tag-Connect_TC2030-IDC-NL_2x03_P1.27mm_Vertical
JP1: NRST; SolderJumper-2_P1.3mm_Open_TrianglePad1.0x1.5mm
R23: 0R; R_0402_1005Metric
R24: 10K; R_0201_0603Metric
R25: 1K; R_0201_0603Metric
R26: 10K; R_0402_1005Metric
R27: 330R; R_0603_1608Metric
SW1: SW_SPDT; SSSS810701
U8: STM32F722RET6; LQFP-64_10x10mm_P0.5mm
Y2: 8Mhz; Crystal_SMD_3225-4Pin_3.2x2.5mm

Connections:
+3V3: C37.1, C39.1, C41.1, C42.1, C44.1, C45.1, C46.1, FB1.2, J9.1 (VCC), SW1.3 (C), U8.1 (VBAT), U8.19 (VDD), U8.32 (VDD), U8.48 (VDD), U8.64 (VDD); also elsewhere on the board
+BATT: R24.1; also elsewhere on the board
/MCU/VCAP: C36.1, U8.30 (VCAP_1)
ADC_BATT: R24.2, R25.1, U8.10 (PC2)
ADC_Current: U8.8 (PC0); also elsewhere on the board
ADC_RSSI: U8.9 (PC1)
BARO_INT: U8.39 (PC8); also elsewhere on the board
BOOT0: R26.2, U8.60 (BOOT0)
Baro_I2C_SCL: U8.41 (PA8); also elsewhere on the board
Baro_I2C_SDA: U8.40 (PC9); also elsewhere on the board
CC: C47.1, R27.2; also elsewhere on the board
DJI_RX: U8.38 (PC7); also elsewhere on the board
DJI_SBUS: U8.29 (PB11); also elsewhere on the board
DJI_TX: U8.37 (PC6); also elsewhere on the board
ESC_TEL_RX: U8.15 (PA1); also elsewhere on the board
Flash_CLK: U8.21 (PA5); also elsewhere on the board
Flash_CS: U8.20 (PA4); also elsewhere on the board
Flash_MISO: U8.22 (PA6); also elsewhere on the board
Flash_MOSI: U8.23 (PA7); also elsewhere on the board
GND: C34.2, C35.2, C36.2, C37.2, C38.2, C39.2, C40.2, C41.2, C42.2, C43.2, C44.2, C45.2, C46.2, C47.2, J9.5 (GND), JP1.1 (A), R25.2, SW1.1 (A), U8.12 (VSSA), U8.18 (VSS), U8.31 (VSS), U8.47 (VSS), U8.63 (VSS), Y2.2, Y2.4; also elsewhere on the board
GPIO_1: U8.11 (PC3); also elsewhere on the board
GPIO_2: U8.24 (PC4); also elsewhere on the board
GPIO_3: U8.3 (PC14); also elsewhere on the board
GPIO_4: U8.4 (PC15); also elsewhere on the board
GPS_I2C_SCL: U8.61 (PB8); also elsewhere on the board
GPS_I2C_SDA: U8.62 (PB9); also elsewhere on the board
GPS_RX: U8.43 (PA10); also elsewhere on the board
GPS_TX: U8.42 (PA9); also elsewhere on the board
GYRO_CS: U8.54 (PD2); also elsewhere on the board
GYRO_INT1: U8.2 (PC13); also elsewhere on the board
GYRO_MISO: U8.52 (PC11); also elsewhere on the board
GYRO_MOSI: U8.53 (PC12); also elsewhere on the board
GYRO_SCK: U8.51 (PC10); also elsewhere on the board
HSE_IN: C34.1, U8.5 (PH0), Y2.1
HSE_OUT: R23.1, U8.6 (PH1)
LED_STRIP: U8.25 (PB0); also elsewhere on the board
Motor 1: U8.50 (PA15); also elsewhere on the board
Motor 2: U8.55 (PB3); also elsewhere on the board
Motor 3: U8.56 (PB4); also elsewhere on the board
Motor 4: U8.57 (PB5); also elsewhere on the board
Motor 5: U8.58 (PB6); also elsewhere on the board
NRST: C43.1, J9.3 (nRESET), JP1.2 (B), U8.7 (NRST)
unnamed: C35.1, R23.2, Y2.3
unnamed: R26.1, SW1.2 (B)
unnamed: R27.1, U8.59 (PB7)
OSD_CLK: U8.34 (PB13); also elsewhere on the board
OSD_CS: U8.33 (PB12); also elsewhere on the board
OSD_MISO: U8.35 (PB14); also elsewhere on the board
OSD_MOSI: U8.36 (PB15); also elsewhere on the board
RADIO_RX: U8.17 (PA3); also elsewhere on the board
RADIO_TX: U8.16 (PA2); also elsewhere on the board
STATUS_LED1: U8.26 (PB1); also elsewhere on the board
STATUS_LED2: U8.27 (PB2); also elsewhere on the board
SWCLK: J9.4 (SWCLK), U8.49 (PA14)
SWDIO: J9.2 (SWDIO), U8.46 (PA13)
USB_D+: U8.45 (PA12); also elsewhere on the board
USB_D-: U8.44 (PA11); also elsewhere on the board
VREF: C38.1, C40.1, FB1.1, U8.13 (VREF+)

Notes on the sheet:
External Crystal
MCU
Decoupling Capacitors
Reset & Boot Pin
