koradeh/STM32_Drone/Flight Controller Sample/STM32F7_FC-main/Flight_Controller.kicad_pcb

## KiCad design Flight Controller Sample/STM32F7_FC-main/Flight_Controller.kicad_pcb (continued)

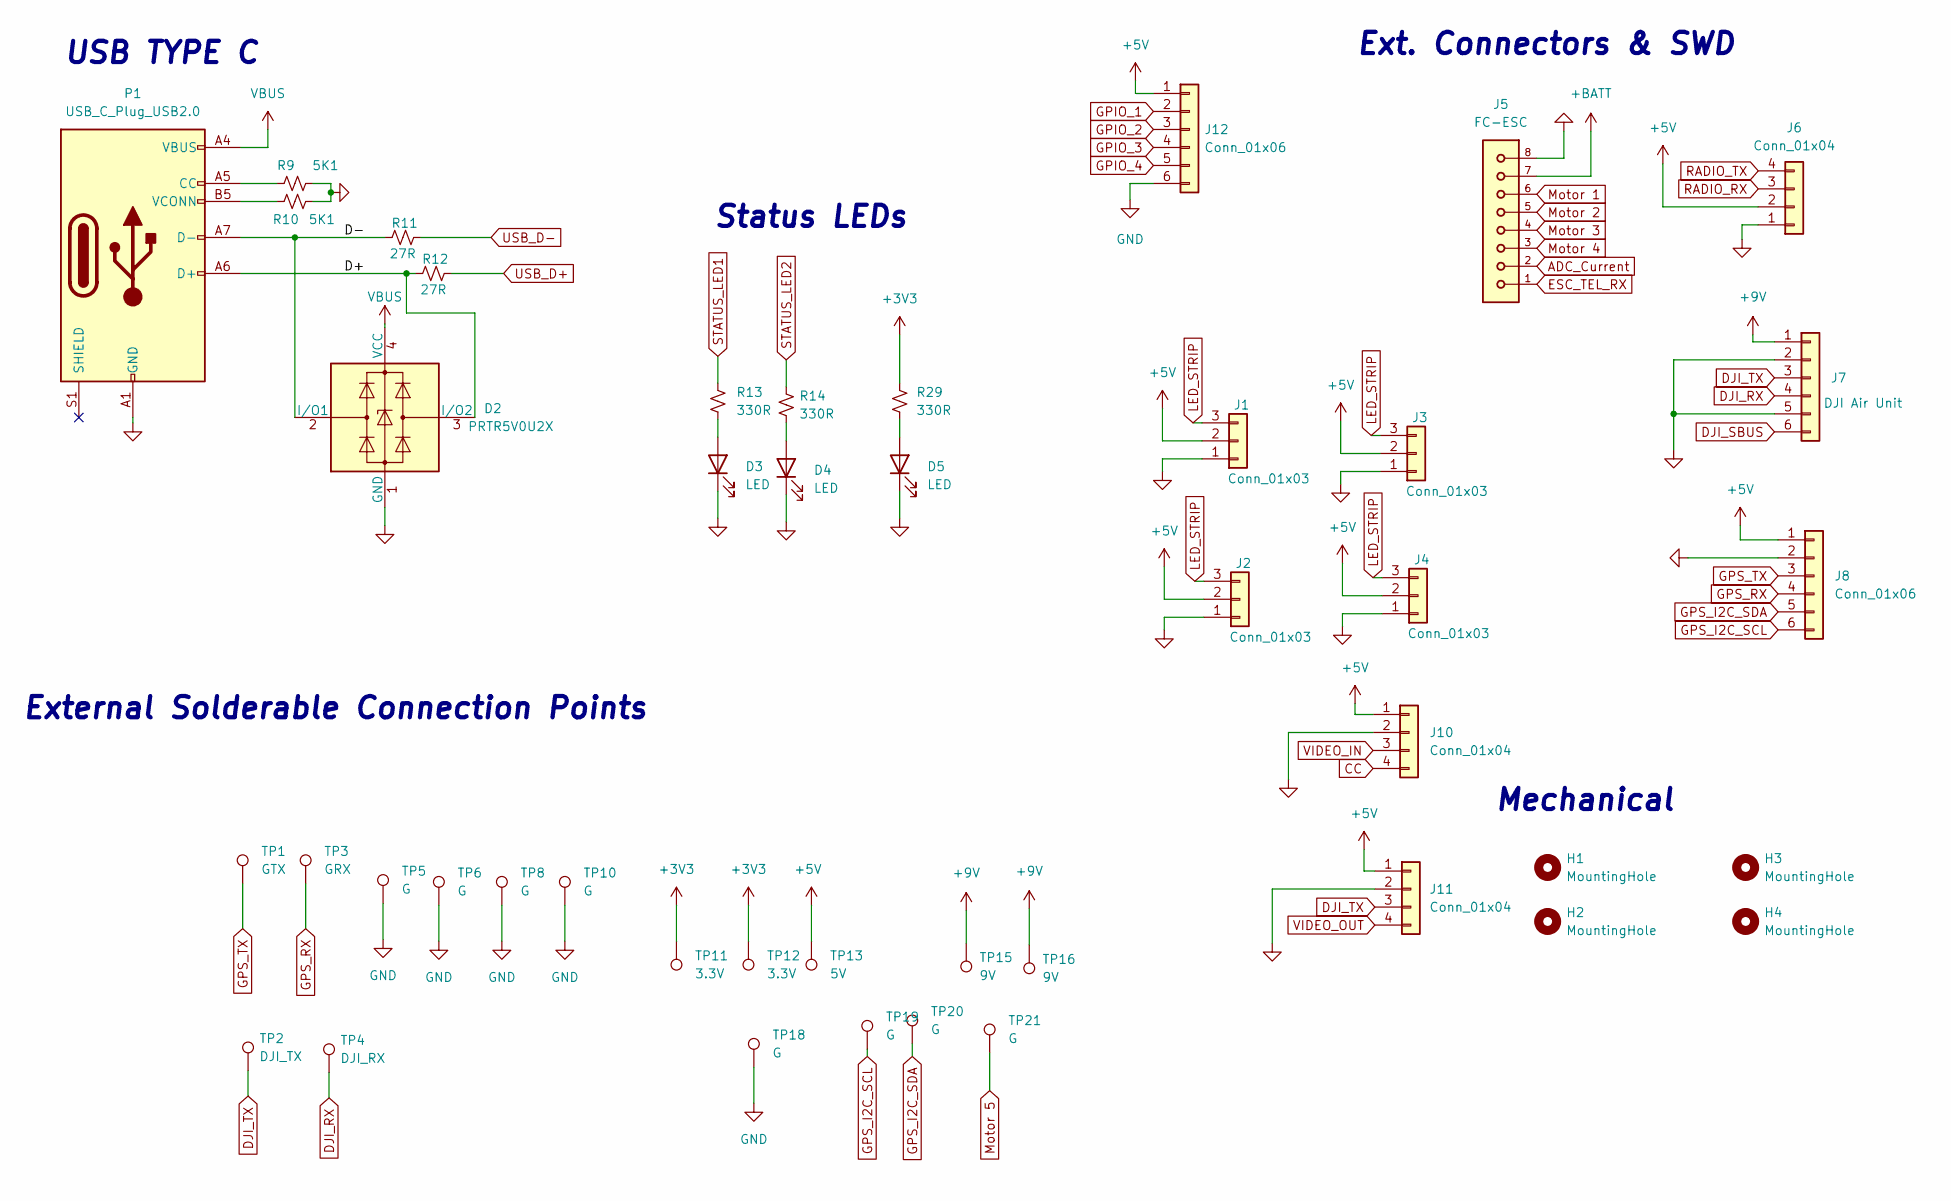
[picture p36: schematic FC_Connectors.kicad_sch]

Parts:
D2: PRTR5V0U2X; SOT-143
D3, D4, D5: LED; LED_0402_1005Metric
H1, H2, H3, H4: MountingHole; MountingHole_2.2mm_M2_Pad_Via
J1, J2, J3, J4: Conn_01x03; JST_SH_SM03B-SRSS-TB_1x03-1MP_P1.00mm_Horizontal
J5: FC-ESC; JST_SH_SM08B-SRSS-TB_1x08-1MP_P1.00mm_Horizontal
J6, J10, J11: Conn_01x04; JST_SH_SM04B-SRSS-TB_1x04-1MP_P1.00mm_Horizontal
J7: DJI Air Unit; JST_SH_SM06B-SRSS-TB_1x06-1MP_P1.00mm_Horizontal
J8, J12: Conn_01x06; JST_SH_SM06B-SRSS-TB_1x06-1MP_P1.00mm_Horizontal
P1: USB_C_Plug_USB2.0; USB4110GFA
R9, R10: 5K1; R_0201_0603Metric
R11, R12: 27R; R_0201_0603Metric
R13, R14, R29: 330R; R_0402_1005Metric
TP1: GTX; Solderable Point
TP2: DJI_TX; Solderable Point
TP3: GRX; Solderable Point
TP4: DJI_RX; Solderable Point
TP5, TP6, TP8, TP10, TP18, TP19, TP20, TP21: G; Solderable Point
TP11, TP12: 3.3V; Solderable Point
TP13: 5V; Solderable Point
TP15, TP16: 9V; Solderable Point

Connections:
+3V3: R29.1, TP11.1, TP12.1; also elsewhere on the board
+5V: J1.2, J2.2, J3.2, J4.2, J6.2, J8.1, J10.1, J11.1, J12.1, TP13.1; also elsewhere on the board
+9V: J7.1, TP15.1, TP16.1; also elsewhere on the board
+BATT: J5.7; also elsewhere on the board
/Connectors/D+: D2.3 (I/O2), P1.A6 (D+), R12.1
/Connectors/D-: D2.2 (I/O1), P1.A7 (D-), R11.1
ADC_Current: J5.2; also elsewhere on the board
CC: J10.4; also elsewhere on the board
DJI_RX: J7.4, TP4.1; also elsewhere on the board
DJI_SBUS: J7.6; also elsewhere on the board
DJI_TX: J7.3, J11.3, TP2.1; also elsewhere on the board
ESC_TEL_RX: J5.1; also elsewhere on the board
GND: D2.1 (GND), D3.1 (K), D4.1 (K), D5.1 (K), J1.1, J2.1, J3.1, J4.1, J5.8, J6.1, J7.2, J7.5, J8.2, J10.2, J11.2, J12.6, P1.A1 (GND), P1.A12 (GND), P1.B1 (GND), P1.B12 (GND), R9.1, R10.2, TP5.1, TP6.1, TP8.1, TP10.1, TP18.1; also elsewhere on the board
GPIO_1: J12.2; also elsewhere on the board
GPIO_2: J12.3; also elsewhere on the board
GPIO_3: J12.4; also elsewhere on the board
GPIO_4: J12.5; also elsewhere on the board
GPS_I2C_SCL: J8.6, TP19.1; also elsewhere on the board
GPS_I2C_SDA: J8.5, TP20.1; also elsewhere on the board
GPS_RX: J8.4, TP3.1; also elsewhere on the board
GPS_TX: J8.3, TP1.1; also elsewhere on the board
LED_STRIP: J1.3, J2.3, J3.3, J4.3; also elsewhere on the board
Motor 1: J5.6; also elsewhere on the board
Motor 2: J5.5; also elsewhere on the board
Motor 3: J5.4; also elsewhere on the board
Motor 4: J5.3; also elsewhere on the board
Motor 5: TP21.1; also elsewhere on the board
unnamed: D3.2 (A), R13.2
unnamed: D4.2 (A), R14.2
unnamed: D5.2 (A), R29.2
unnamed: P1.A5 (CC), R9.2
unnamed: P1.B5 (VCONN), R10.1
RADIO_RX: J6.3; also elsewhere on the board
RADIO_TX: J6.4; also elsewhere on the board
STATUS_LED1: R13.1; also elsewhere on the board
STATUS_LED2: R14.1; also elsewhere on the board
USB_D+: R12.2; also elsewhere on the board
USB_D-: R11.2; also elsewhere on the board
VBUS: D2.4 (VCC), P1.A4 (VBUS), P1.A9 (VBUS), P1.B4 (VBUS), P1.B9 (VBUS); also elsewhere on the board
VIDEO_IN: J10.3; also elsewhere on the board
VIDEO_OUT: J11.4; also elsewhere on the board

Notes on the sheet:
USB TYPE C
Status LEDs
Ext. Connectors & SWD
External Solderable Connection Points
Mechanical

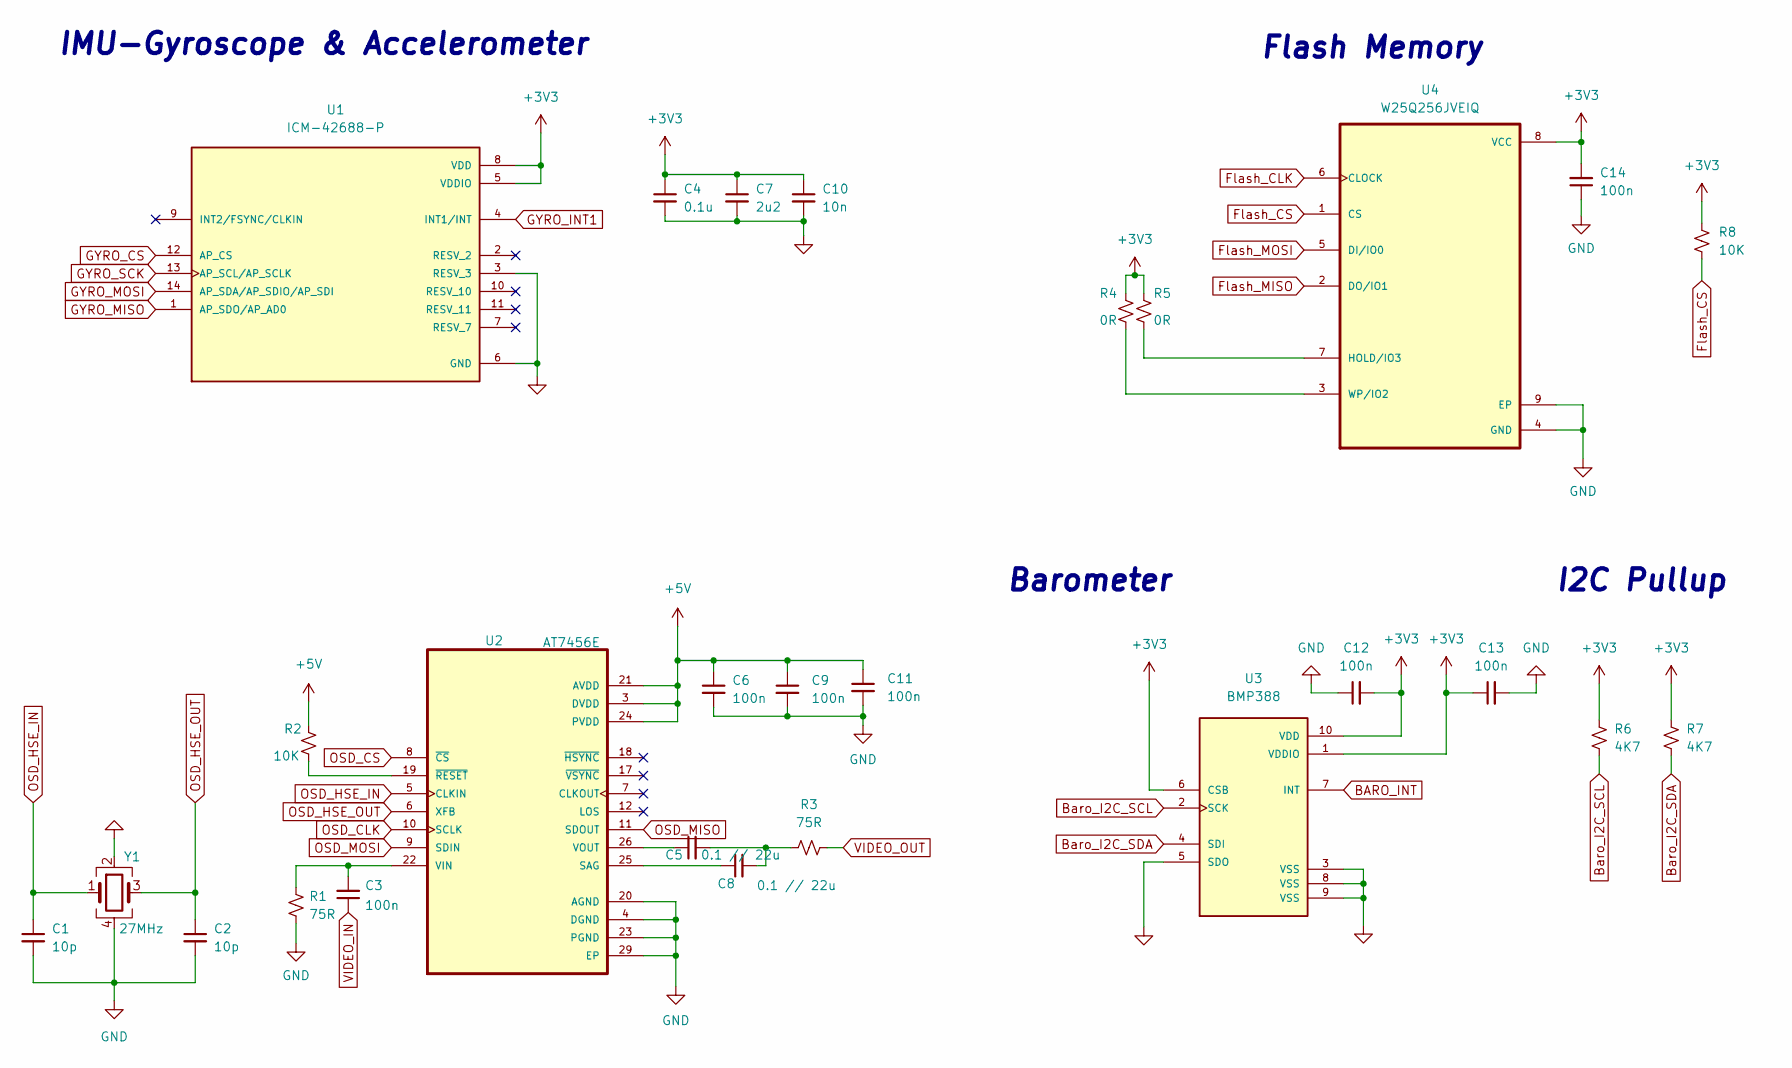
[picture p37: schematic Sensors & Peripherals.kicad_sch]

Parts:
C1, C2: 10p; C_0201_0603Metric
C3, C6, C9, C11, C12, C13: 100n; C_0201_0603Metric
C4: 0.1u; C_0402_1005Metric
C5, C8: 0.1 // 22u; C_0201_0603Metric
C7: 2u2; C_0603_1608Metric
C10: 10n; C_0201_0603Metric
C14: 100n; C_0402_1005Metric
R1, R3: 75R; R_0201_0603Metric
R2, R8: 10K; R_0201_0603Metric
R4, R5: 0R; R_0201_0603Metric
R6, R7: 4K7; R_0201_0603Metric
U1: ICM-42688-P; ICP-42688-P; PARTREV 1.2
U2: AT7456E; SOP65P637X110-28N
U3: BMP388; PARTREV 1.1
U4: W25Q256JVEIQ; SON127P600X800X80-9N
Y1: 27MHz; Crystal_SMD_3225-4Pin_3.2x2.5mm

Connections:
+3V3: C4.1, C7.1, C10.1, C12.2, C13.1, C14.2, R4.1, R5.1, R6.1, R7.1, R8.1, U1.5 (VDDIO), U1.8 (VDD), U3.1 (VDDIO), U3.6 (CSB), U3.10 (VDD), U4.8 (VCC); also elsewhere on the board
+5V: C6.1, C9.1, C11.1, R2.2, U2.3 (DVDD), U2.21 (AVDD), U2.24 (PVDD); also elsewhere on the board
BARO_INT: U3.7 (INT); also elsewhere on the board
Baro_I2C_SCL: R6.2, U3.2 (SCK); also elsewhere on the board
Baro_I2C_SDA: R7.2, U3.4 (SDI); also elsewhere on the board
Flash_CLK: U4.6 (CLOCK); also elsewhere on the board
Flash_CS: R8.2, U4.1 (CS); also elsewhere on the board
Flash_MISO: U4.2 (DO/IO1); also elsewhere on the board
Flash_MOSI: U4.5 (DI/IO0); also elsewhere on the board
GND: C1.2, C2.2, C4.2, C6.2, C7.2, C9.2, C10.2, C11.2, C12.1, C13.2, C14.1, R1.2, U1.3 (RESV_3), U1.6 (GND), U2.4 (DGND), U2.20 (AGND), U2.23 (PGND), U2.29 (EP), U3.3 (VSS), U3.5 (SDO), U3.8 (VSS), U3.9 (VSS), U4.4 (GND), U4.9 (EP), Y1.2, Y1.4; also elsewhere on the board
GYRO_CS: U1.12 (AP_CS); also elsewhere on the board
GYRO_INT1: U1.4 (INT1/INT); also elsewhere on the board
GYRO_MISO: U1.1 (AP_SDO/AP_AD0); also elsewhere on the board
GYRO_MOSI: U1.14 (AP_SDA/AP_SDIO/AP_SDI); also elsewhere on the board
GYRO_SCK: U1.13 (AP_SCL/AP_SCLK); also elsewhere on the board
unnamed: C3.2, R1.1, U2.22 (VIN)
unnamed: C5.1, U2.26 (VOUT)
unnamed: C5.2, C8.2, R3.1
unnamed: C8.1, U2.25 (SAG)
unnamed: R2.1, U2.19 (~RESET)
unnamed: R4.2, U4.3 (WP/IO2)
unnamed: R5.2, U4.7 (HOLD/IO3)
OSD_CLK: U2.10 (SCLK); also elsewhere on the board
OSD_CS: U2.8 (~CS); also elsewhere on the board
OSD_HSE_IN: C1.1, U2.5 (CLKIN), Y1.1
OSD_HSE_OUT: C2.1, U2.6 (XFB), Y1.3
OSD_MISO: U2.11 (SDOUT); also elsewhere on the board
OSD_MOSI: U2.9 (SDIN); also elsewhere on the board
VIDEO_IN: C3.1; also elsewhere on the board
VIDEO_OUT: R3.2; also elsewhere on the board

Notes on the sheet:
I2C Pullup
Flash Memory
IMU-Gyroscope & Accelerometer
Barometer

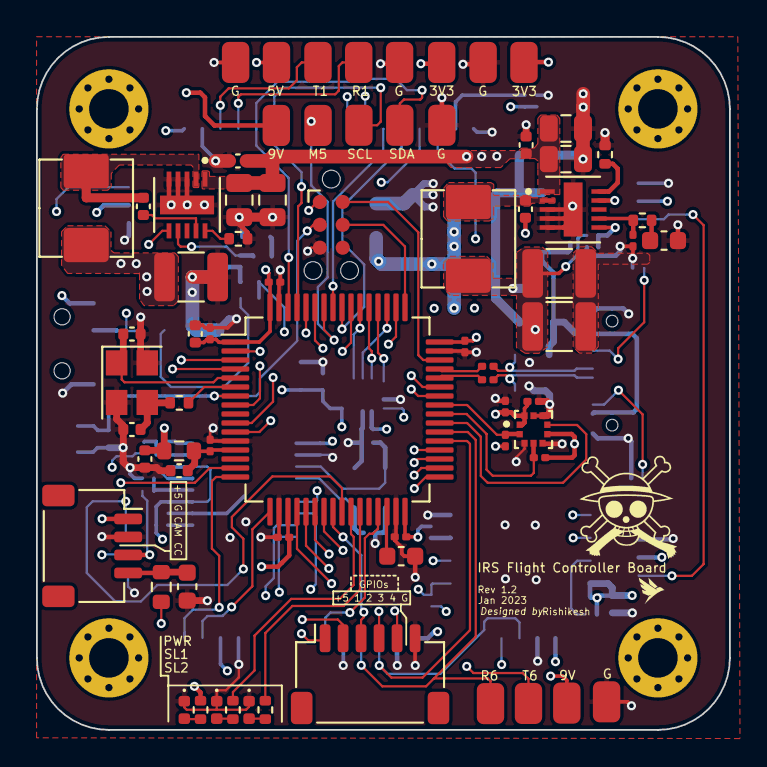
[picture p38: board Flight_Controller.kicad_pcb from above]

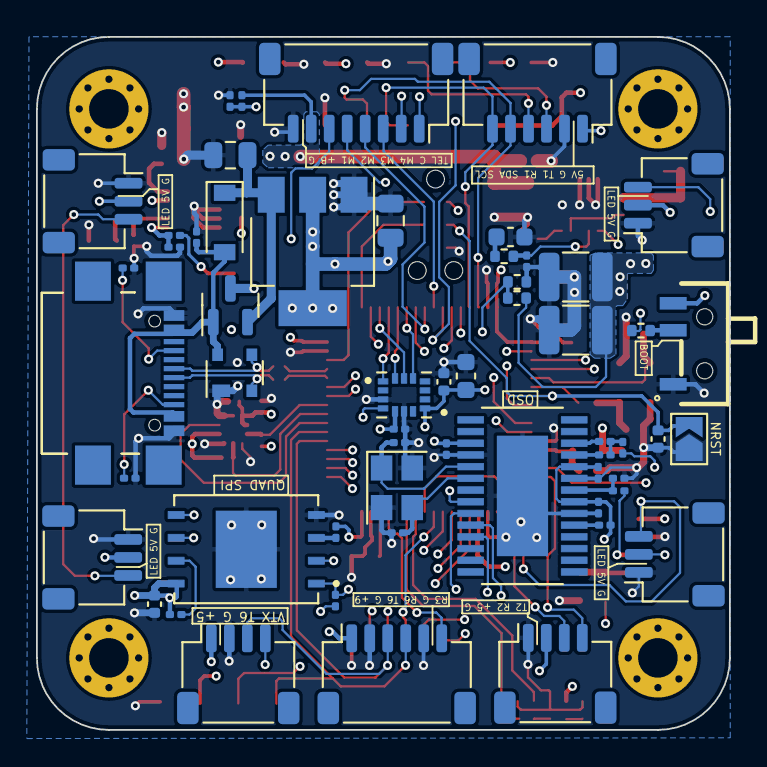
[picture p39: board Flight_Controller.kicad_pcb from below]

Board: 8 copper layers, 38.5 x 38.5 mm, 131 parts (56 on the bottom side), 91 nets.
