koradeh/STM32_Drone/AnyLeaf/single radio pcb.kicad_pcb

## KiCad design AnyLeaf/single radio pcb.kicad_pcb (2025-04-08)

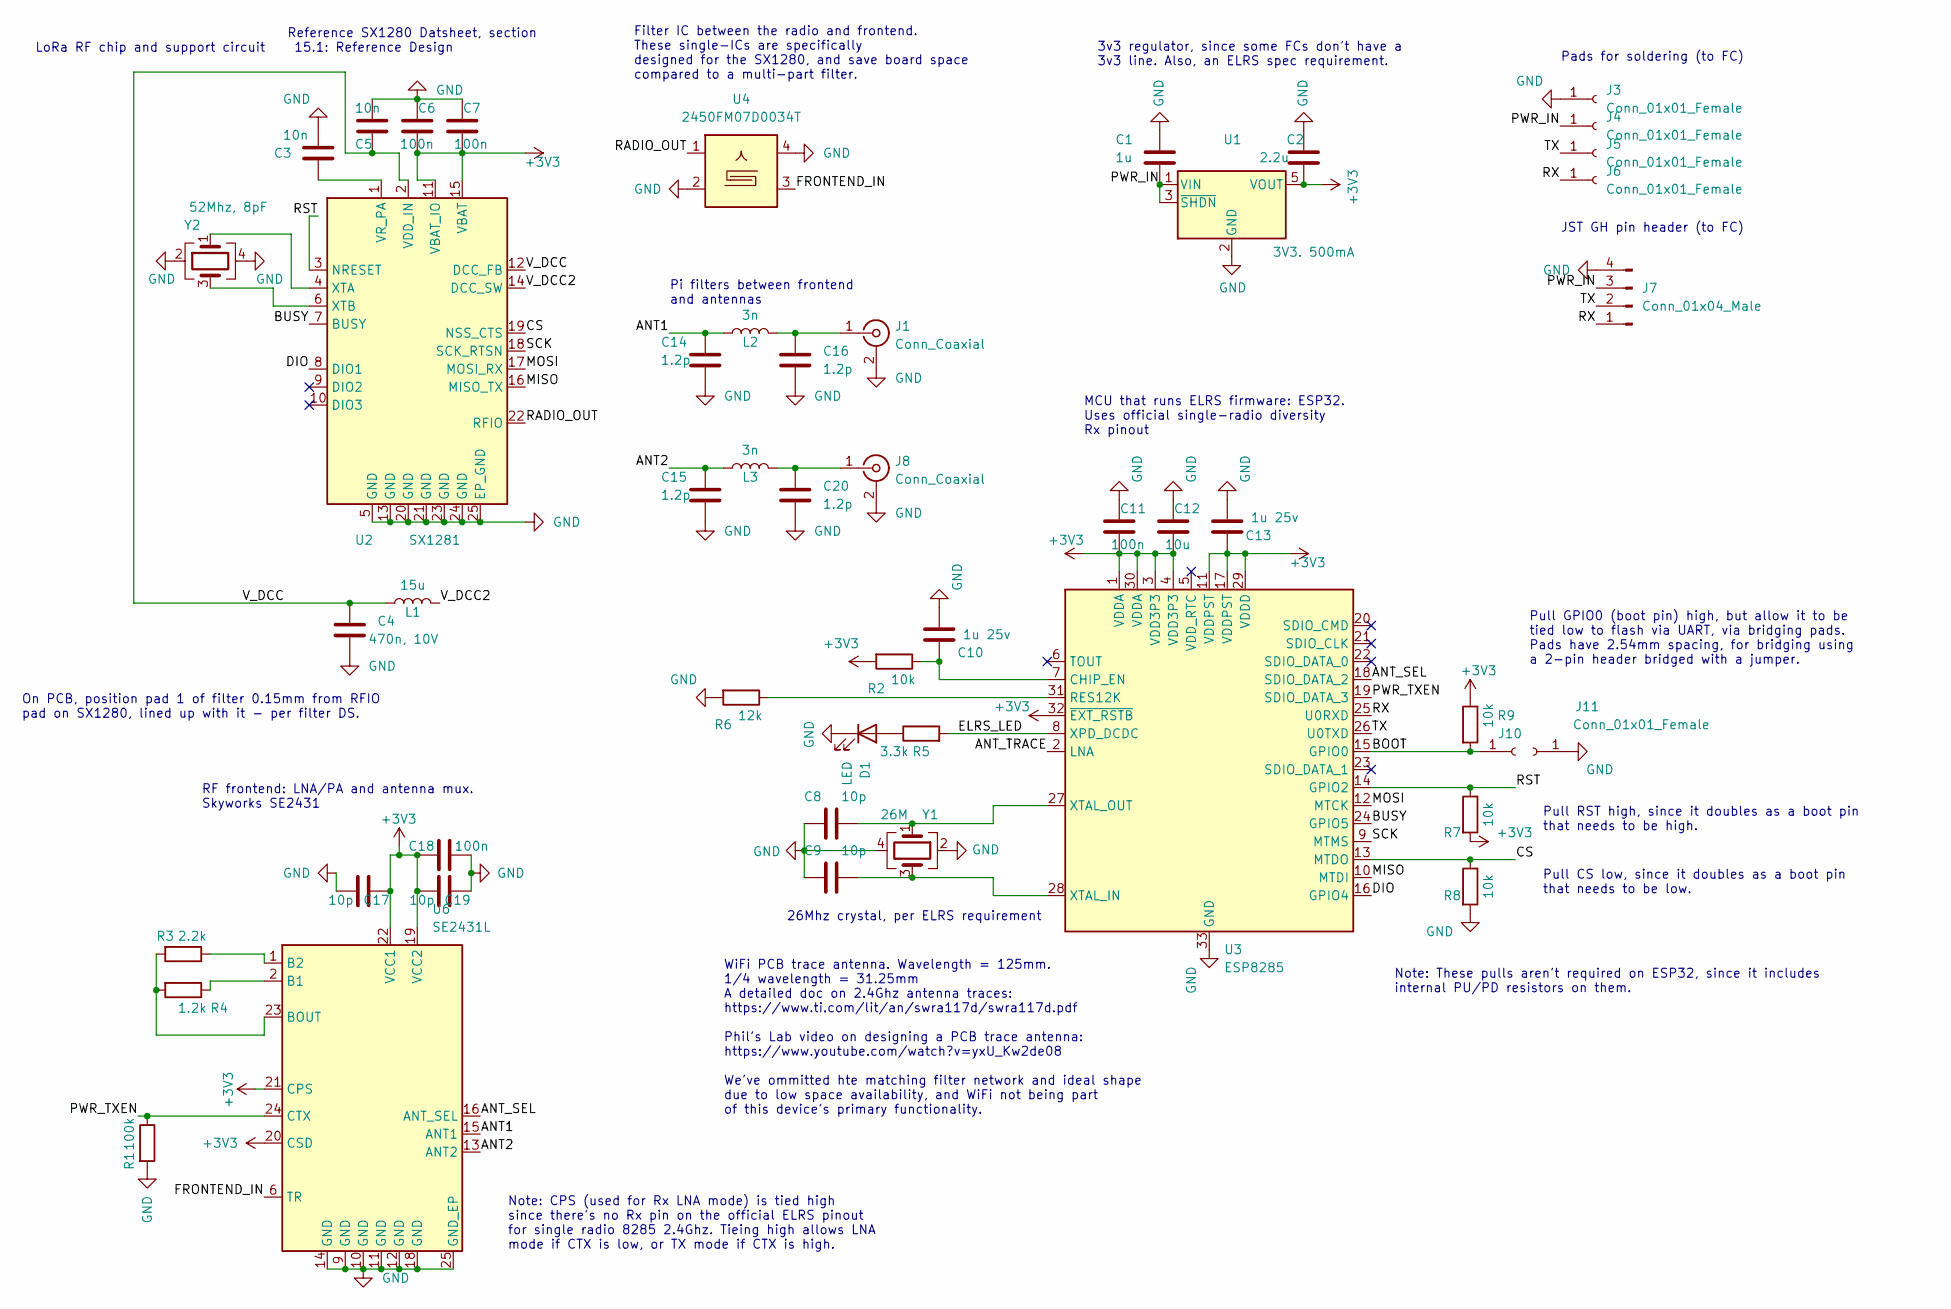
[picture p40: schematic single radio schematic.kicad_sch, AnyLeaf ELRS single-radio Rx]

Parts:
C1: 1u; C_0402_1005Metric; LCSC C52923
C2: 2.2u; C_0402_1005Metric; LCSC C12530
C3, C5: 10n; C_0402_1005Metric; LCSC C15195
C4: 470n, 10V; C_0402_1005Metric; LCSC C47339
C6, C7, C11, C18: 100n; C_0402_1005Metric; LCSC C1525
C8, C9, C17, C19: 10p; C_0402_1005Metric; LCSC C32949
C10, C13: 1u 25v; C_0402_1005Metric; LCSC C52923
C12: 10u; C_0402_1005Metric; LCSC C15525
C14, C15, C16, C20: 1.2p; C_0402_1005Metric; LCSC C327292
D1: LED; LED_0603_1608Metric; LCSC C2286
J1, J8: Conn_Coaxial; U.FL_Hirose_U.FL-R-SMT-1_Vertical; Part Hirose U.FL-R-SMT-1(80); LCSC C88374
J3, J4, J5, J6: Conn_01x01_Female; TestPoint_Pad_2.5x2.5mm
J7: Conn_01x04_Male; JST_GH_SM04B-GHS-TB_1x04-1MP_P1.25mm_Horizontal; LCSC C189895
J10, J11: Conn_01x01_Female; TestPoint_Pad_1.0x1.0mm
L1: 15u; L_0805_2012Metric; LCSC C486333
L2, L3: 3n; L_0402_1005Metric; LCSC C269824
R1: 100k; R_0402_1005Metric; LCSC C25741
R2, R7, R8, R9: 10k; R_0402_1005Metric; LCSC C25744
R3: 2.2k; R_0402_1005Metric; LCSC C25879
R4: 1.2k; R_0402_1005Metric; LCSC C25862
R5: 3.3k; R_0402_1005Metric; LCSC C25890
R6: 12k; R_0402_1005Metric; LCSC C25752
U1: 3V3. 500mA; TSOT-23-5; Part TPRT9013-33GB; LCSC C587158
U2: SX1281; QFN-24-1EP_4x4mm_P0.5mm_EP2.6x2.6mm; Digikey SX1281IMLTRTTR-ND
U3: ESP8285; QFN-32-1EP_5x5mm_P0.5mm_EP3.45x3.45mm; LCSC C967019
U4: 2450FM07D0034T; 2450FM07D0034; Mouser 609-2450FM07D0034T
U6: SE2431L; QFN-24-1EP_3x4mm_P0.4mm_EP1.65x2.65mm; Digikey 863-1347-2-ND
Y1: 26M; Crystal_SMD_2016-4Pin_2.0x1.6mm; LCSC C843259
Y2: 52Mhz, 8pF; Crystal_SMD_2016-4Pin_2.0x1.6mm; LCSC C781783

Connections:
+3V3: C2.2, C6.2, C7.2, C11.2, C12.2, C13.1, C17.2, C18.1, C19.1, R2.2, R7.2, R9.1, U1.5 (VOUT), U2.11 (VBAT_IO), U2.15 (VBAT), U3.1 (VDDA), U3.3 (VDD3P3), U3.4 (VDD3P3), U3.11 (VDDPST), U3.17 (VDDPST), U3.29 (VDDD), U3.30 (VDDA), U3.32 (~EXT_RSTB), U6.19 (VCC2), U6.20 (CSD), U6.21 (CPS), U6.22 (VCC1)
/ANT1: C14.1, L2.1, U6.15 (ANT1)
/ANT2: C15.1, L3.1, U6.13 (ANT2)
/ANT_SEL: U3.18 (SDIO_DATA_2), U6.16 (ANT_SEL)
/ANT_TRACE: U3.2 (LNA)
/BOOT: J10.1, R9.2, U3.15 (GPIO0)
/BUSY: U2.7 (BUSY), U3.24 (GPIO5)
/CS: R8.1, U2.19 (NSS_CTS), U3.13 (MTDO)
/DIO: U2.8 (DIO1), U3.16 (GPIO4)
/ELRS_LED: R5.2, U3.8 (XPD_DCDC)
/FRONTEND_IN: U4.3, U6.6 (TR)
/MISO: U2.16 (MISO_TX), U3.10 (MTDI)
/MOSI: U2.17 (MOSI_RX), U3.12 (MTCK)
/PWR_IN: C1.2, J4.1, J7.3, U1.1 (VIN), U1.3 (~SHDN)
/PWR_TXEN: R1.1, U3.19 (SDIO_DATA_3), U6.24 (CTX)
/RADIO_OUT: U2.22 (RFIO), U4.1
/RST: R7.1, U2.3 (NRESET), U3.14 (GPIO2)
/RX: J6.1, J7.1, U3.25 (U0RXD)
/SCK: U2.18 (SCK_RTSN), U3.9 (MTMS)
/TX: J5.1, J7.2, U3.26 (U0TXD)
/V_DCC: C4.1, C5.2, L1.1, U2.2 (VDD_IN), U2.12 (DCC_FB)
/V_DCC2: L1.2, U2.14 (DCC_SW)
GND: C1.1, C2.1, C3.1, C4.2, C5.1, C6.1, C7.1, C8.1, C9.1, C10.2, C11.1, C12.1, C13.2, C14.2, C15.2, C16.2, C17.1, C18.2, C19.2, C20.2, D1.1 (K), J1.2 (Ext), J3.1, J7.4, J8.2 (Ext), J11.1, R1.2, R6.2, R8.2, U1.2 (GND), U2.5 (GND), U2.13 (GND), U2.20 (GND), U2.21 (GND), U2.23 (GND), U2.24 (GND), U2.25 (EP_GND), U3.33 (GND), U4.2, U4.4, U4.5, U6.9 (GND), U6.10 (GND), U6.11 (GND), U6.12 (GND), U6.14 (GND), U6.18 (GND), U6.25 (GND_EP), Y1.2, Y1.4, Y2.2, Y2.4
unnamed: C3.2, U2.1 (VR_PA)
unnamed: C8.2, U3.27 (XTAL_OUT), Y1.1
unnamed: C9.2, U3.28 (XTAL_IN), Y1.3
unnamed: C10.1, R2.1, U3.7 (CHIP_EN)
unnamed: C16.1, J1.1 (In), L2.2
unnamed: C20.1, J8.1 (In), L3.2
unnamed: D1.2 (A), R5.1
unnamed: R3.1, U6.1 (B2)
unnamed: R3.2, R4.2, U6.23 (BOUT)
unnamed: R4.1, U6.2 (B1)
unnamed: R6.1, U3.31 (RES12K)
unnamed: U2.4 (XTA), Y2.1
unnamed: U2.6 (XTB), Y2.3

Notes on the sheet:
26Mhz crystal, per ELRS requirement
MCU that runs ELRS firmware: ESP32. Uses official single-radio diversity Rx pinout
JST GH pin header (to FC)
Note: These pulls aren't required on ESP32, since it includes internal PU/PD resistors on them.
Pi filters between frontend and antennas
Pads for soldering (to FC)
Note: CPS (used for Rx LNA mode) is tied high since there's no Rx pin on the official ELRS pinout for single radio 8285 2.4Ghz. Tieing high allows LNA mode if CTX is low, or TX mode if CTX is high.
3v3 regulator, since some FCs don't have a 3v3 line. Also, an ELRS spec requirement.
WiFi PCB trace antenna. Wavelength = 125mm. 1/4 wavelength = 31.25mm A detailed doc on 2.4Ghz antenna traces: https://www.ti.com/lit/an/swra117d/swra117d.pdf Phil's Lab video on designing a PCB trace antenna: https://www.youtube.com/watch?v=yxU_Kw2de08 We've ommitted hte matching filter network and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
Pull CS low, since it doubles as a boot pin that needs to be low.
Reference SX1280 Datsheet, section 15.1: Reference Design
RF frontend: LNA/PA and antenna mux. Skyworks SE2431
Pull GPIO0 (boot pin) high, but allow it to be tied low to flash via UART, via bridging pads. Pads have 2.54mm spacing, for bridging using a 2-pin header bridged with a jumper.
On PCB, position pad 1 of filter 0.15mm from RFIO pad on SX1280, lined up with it - per filter DS.
Pull RST high, since it doubles as a boot pin that needs to be high.
LoRa RF chip and support circuit
Filter IC between the radio and frontend. These single-ICs are specifically designed for the SX1280, and save board space compared to a multi-part filter.

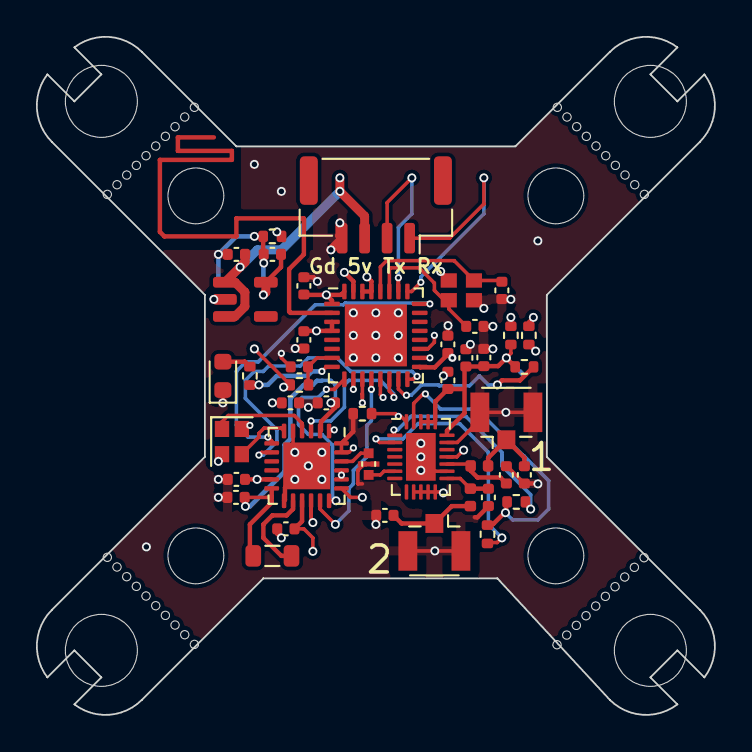
[picture p41: board single radio pcb.kicad_pcb from above]

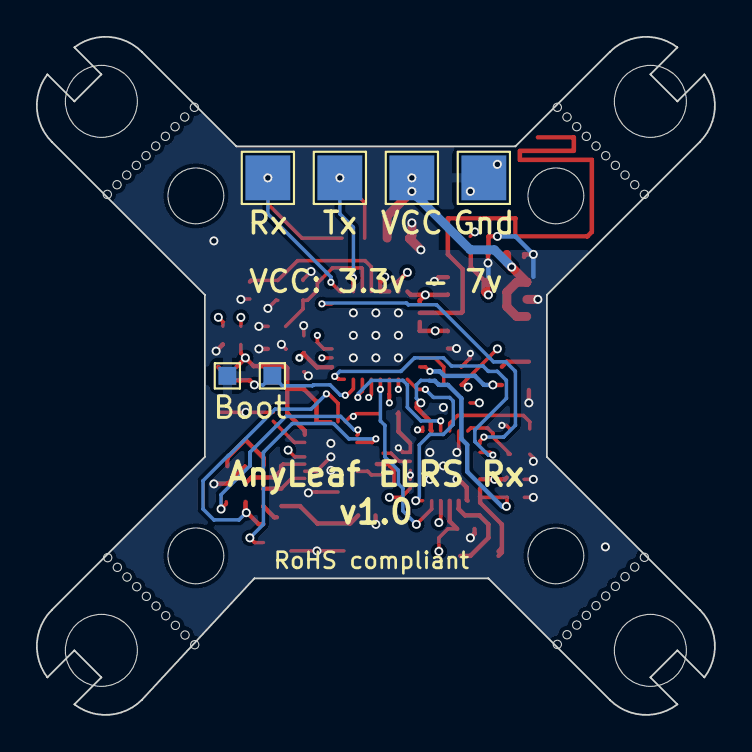
[picture p42: board single radio pcb.kicad_pcb from below]

Board: 4 copper layers, 37.7 x 37.7 mm, 61 parts (6 on the bottom side), 35 nets.

Other parts of the board:
H1, H2, H3, H4, H7, H8, H9, H10: MountingHole; MountingHole_3.2mm_M3
H5, H6, H11, H12: MountingHole_Pad; Mouse bites_7mm
