koradeh/STM32_Drone/Sample Firmware/STM32_Drone_Dev-master/STM32H723/STM32H723.ioc

Mcu.UserName=STM32H723ZGTx
PA0.GPIO_Label=UART4_TX_GPS
PA0.Signal=UART4_TX
PA1.GPIO_Label=UART4_RX_GPS
PA1.Signal=UART4_RX
PA10.Signal=USART1_RX
PA11.Signal=USB_OTG_HS_DM
PA12.Signal=USB_OTG_HS_DP
PA13(JTMS/SWDIO).Signal=DEBUG_JTMS-SWDIO
PA14(JTCK/SWCLK).Signal=DEBUG_JTCK-SWCLK
PA2.Signal=USART2_TX
PA3.Signal=USART2_RX
PA5.Signal=S_TIM2_CH1_ETR
PA7.Signal=S_TIM3_CH2
PA9.Signal=USART1_TX
PB1.Signal=S_TIM3_CH4
PB10.Signal=S_TIM2_CH3
PB12.Signal=UART5_RX
PB13.Signal=UART5_TX
PB3(JTDO/TRACESWO).Signal=DEBUG_JTDO-SWO
PB5.GPIO_Label=IMU_INT
PB5.Signal=GPIO_Input
PB6.Signal=I2C1_SCL
PB7.Signal=I2C1_SDA
PC14-OSC32_IN.Signal=RCC_OSC32_IN
PC15-OSC32_OUT.Signal=RCC_OSC32_OUT
PF10.Signal=OCTOSPIM_P1_CLK
PF11.Signal=ADC1_INP2
PF6.Signal=OCTOSPIM_P1_IO3
PF7.Signal=OCTOSPIM_P1_IO2
PF8.Signal=OCTOSPIM_P1_IO0
PF9.Signal=OCTOSPIM_P1_IO1
PG10.Signal=DCMI_D2
PG11.Signal=DCMI_D3
PG13.Signal=SPI6_SCK
PG14.Signal=SPI6_MOSI
PG2.Signal=GPXTI2
PG6.Signal=OCTOSPIM_P1_NCS
PG7.GPIO_Label=LED_Blue
PG7.Signal=GPIO_Output
PG8.Signal=SPI6_NSS
PH0-OSC_IN.Signal=RCC_OSC_IN
PH1-OSC_OUT.Signal=RCC_OSC_OUT
