koradeh/STM32_Drone/Sample Firmware/STM32_Drone_Dev-master/STM32H723/Core/Inc/main.h

#define UART4_TX_GPS_Pin GPIO_PIN_0
#define UART4_TX_GPS_GPIO_Port GPIOA
#define UART4_RX_GPS_Pin GPIO_PIN_1
#define UART4_RX_GPS_GPIO_Port GPIOA
#define LED_Blue_Pin GPIO_PIN_7
#define LED_Blue_GPIO_Port GPIOG
#define IMU_INT_Pin GPIO_PIN_5
#define IMU_INT_GPIO_Port GPIOB
