koradeh/STM32_Drone/Sample Firmware/STM32_Drone_Dev-master/UAV_F722/Core/Src/sensors/BMP280.c

#include "BMP280.h"
#include "../CommonMath/filters.h"
#include "Timers.h"
#include "i2c.h"
#include "math.h"
#include "../flight/defines.h"
/* BMP280 registers*/

/*Temperature Registers*/
#define BMP280_REG_TEMP_XLSB   0xFC /* bits: 7-4  ; 3-0 are empty*/
#define BMP280_REG_TEMP_LSB    0xFB /* bits: 7-0 */
#define BMP280_REG_TEMP_MSB    0xFA /* bits: 7-0 ; reset state = 0x80 */
#define BMP280_REG_TEMP        (BMP280_REG_TEMP_MSB)

/*Pressure Registers*/ //Same bit map as above
#define BMP280_REG_PRESS_XLSB  0xF9
#define BMP280_REG_PRESS_LSB   0xF8
#define BMP280_REG_PRESS_MSB   0xF7
#define BMP280_REG_PRESSURE    (BMP280_REG_PRESS_MSB)

#define BMP280_REG_CTRL_HUM    0xF2 /* bits: 2-0 osrs_h; */

/*General Registers*/
#define BMP280_REG_CONFIG      0xF5 /* bits: 7-5 t_sb; 4-2 filter; 0 spi3w_en */
#define BMP280_REG_CTRL        0xF4 /* bits: 7-5 osrs_t; 4-2 osrs_p; 1-0 mode */
#define BMP280_REG_STATUS      0xF3 /* bits: 3 measuring; 0 im_update */ //Read ONLY
#define BMP280_REG_RESET       0xE0
#define BMP280_REG_ID          0xD0 /*Chip ID*/
#define BMP280_REG_CALIB       0x88
#define BMP280_REG_HUM_CALIB   0x88


/*If the value 0xB6 is written to the
 *register, the device is reset using the complete power-on-reset procedure.
*/
#define BMP280_RESET_VALUE     0xB6

/*Constant For Altitude Calculation*/
//ISA
#define SEA_LEVEL_PRESSURE 1013.25 // in hPa
#define TEMPERATURE_LAPSE_RATE -0.0065 // in K/m
#define SEA_LEVEL_TEMPERATURE 288.15 // in K
#define GRAVITATIONAL_ACCELERATION 9.80665 // in m/s^2
#define MOLAR_MASS_AIR 0.0289644 // in kg/mol
#define UNIVERSAL_GAS_CONSTANT 8.3144598 // in J/(mol*K)

//Pressure Low Pass Filter
pt2Filter_t Pressure_Filter;

/*System Parameter Preset*/
void bmp280_init_default_params(bmp280_params_t *params) {

	/*See Datasheet 3.3.4*/
	params->mode = BMP280_MODE_NORMAL;
	params->filter = BMP280_FILTER_16;
	params->oversampling_pressure = BMP280_ULTRA_HIGH_RES;
	params->oversampling_temperature = BMP280_LOW_POWER;
	params->standby = BMP280_STANDBY_05;
	params->oversampling_humidity = BMP280_STANDARD;//BME280
}


/*For Reading 16 bits value from registers*/
static bool read_register16(Baro_HandleTypedef *dev, uint8_t addr, uint16_t *value) {
	uint16_t tx_buff;
	uint8_t rx_buff[2];
	tx_buff = (dev->addr << 1);

	if (HAL_I2C_Mem_Read(dev->i2c, tx_buff, addr, 1, rx_buff, 2, 50) == HAL_OK)
	{
		*value = (uint16_t) ((rx_buff[1] << 8) | rx_buff[0]);
		return true;
	} else
		return false;
}




static inline int read_data(Baro_HandleTypedef *dev, uint8_t addr, uint8_t *value, uint8_t len)
{
	uint16_t tx_buff;
	tx_buff = (dev->addr << 1); //buffer to store the device address


	/* tx_buff = device address ; addr = register address ; 1byte = register size ; value = storage location ; len = # of byte read ; 5000 = timeout*/
	if (HAL_I2C_Mem_Read(dev->i2c, tx_buff, addr, 1, value, len, 1000) == HAL_OK)
		return 0;
	else
		return 1;

}


/*
 * This is to read what the manufacturer calibrated
 *
 * If all read_register16 calls are successful
 * (i.e., they all return true), the function returns true,
 * indicating that the calibration data was successfully read.
 *
 *
 * If any read_register16 call fails,
 * the function returns false,
 * indicating that the calibration data
 * could not be read successfully.
 *
 */
static bool read_calibration_data(Baro_HandleTypedef *dev) {

	if (	read_register16(dev, 0x88, &dev->dig_T1)
		&& 	read_register16(dev, 0x8a, (uint16_t *) &dev->dig_T2)
		&& 	read_register16(dev, 0x8c, (uint16_t *) &dev->dig_T3)
		&& 	read_register16(dev, 0x8e, &dev->dig_P1)
		&& 	read_register16(dev, 0x90, (uint16_t *) &dev->dig_P2)
		&& 	read_register16(dev, 0x92, (uint16_t *) &dev->dig_P3)
		&& 	read_register16(dev, 0x94, (uint16_t *) &dev->dig_P4)
		&& 	read_register16(dev, 0x96, (uint16_t *) &dev->dig_P5)
		&& 	read_register16(dev, 0x98, (uint16_t *) &dev->dig_P6)
		&& 	read_register16(dev, 0x9a, (uint16_t *) &dev->dig_P7)
		&& 	read_register16(dev, 0x9c, (uint16_t *) &dev->dig_P8)
		&& 	read_register16(dev, 0x9e, (uint16_t *) &dev->dig_P9))
	{
		return true;
	}

	return false;
}

/*Same Thing for BME280*/
static bool read_hum_calibration_data(Baro_HandleTypedef *dev) {
	uint16_t h4, h5;

	if (!read_data(dev, 0xa1, &dev->dig_H1, 1)
			&& read_register16(dev, 0xe1, (uint16_t *) &dev->dig_H2)
			&& !read_data(dev, 0xe3, &dev->dig_H3, 1)
			&& read_register16(dev, 0xe4, &h4)
			&& read_register16(dev, 0xe5, &h5)
			&& !read_data(dev, 0xe7, (uint8_t *) &dev->dig_H6, 1)) {
		dev->dig_H4 = (h4 & 0x00ff) << 4 | (h4 & 0x0f00) >> 8;
		dev->dig_H5 = h5 >> 4;

		return true;
	}

	return false;
}


static int write_register8(Baro_HandleTypedef *dev, uint8_t addr, uint8_t value) {
	uint16_t tx_buff;

	tx_buff = (dev->addr << 1);

	if (HAL_I2C_Mem_Write(dev->i2c, tx_buff, addr, 1, &value, 1, 10000) == HAL_OK)
		return false;
	else
		return true;
}


/*Functions*/
bool BMP280_Init(Baro_HandleTypedef *dev, bmp280_params_t *params, I2C_HandleTypeDef *hi2c)
{
	//Update the system parameter
	bmp280_init_default_params(&dev->params);

	/*Transmission*/
  	dev->addr = BMP280_I2C_ADDRESS_0;

  	dev->i2c = hi2c;


	/*Check The I2C Address*/
	if (dev->addr != BMP280_I2C_ADDRESS_0 && dev->addr != BMP280_I2C_ADDRESS_1) {return false;} //either 0x76 or 0x77

	/*Read The Device ID, store at id*/
	if (read_data(dev, BMP280_REG_ID, &dev->id, 1)) {return false;}

	/* Check The Device ID*/
	if (dev->id != BMP280_CHIP_ID && dev->id != BME280_CHIP_ID) {return false;}

	/*Reset The Device By Writing 0xB6 to Perform Soft Reset*/
	if (write_register8(dev, BMP280_REG_RESET, BMP280_RESET_VALUE)) {return false;}



	// Wait until finished copying over the NVP data.
	while (1)
	{
		uint8_t status;
		if (!read_data(dev, BMP280_REG_STATUS, &status, 1)
				&& (status & 1) == 0)
			break;
	}


	/*Read and Check Calibration Data From Manufacturer*/
	if (!read_calibration_data(dev)) {return false;}


	/*Read and Check if the chip is BME280*/
	if (dev->id == BME280_CHIP_ID && !read_hum_calibration_data(dev)) {return false;}


	/*Device Configuration*/

	//Writing 0xF5, standby and filter
	uint8_t config = (params->standby << 5) | (params->filter << 2);
	if (write_register8(dev, BMP280_REG_CONFIG, config)) {return false;}

	//Control Registers
	if (params->mode == BMP280_MODE_FORCED) {params->mode = BMP280_MODE_SLEEP;}  // initial mode for forced is sleep

	uint8_t ctrl = (params->oversampling_temperature << 5)| (params->oversampling_pressure << 2) | (params->mode);

	if (dev->id == BME280_CHIP_ID)
	{
		// Write crtl hum reg first, only active after write to BMP280_REG_CTRL.
		uint8_t ctrl_hum = params->oversampling_humidity;
		if (write_register8(dev, BMP280_REG_CTRL_HUM, ctrl_hum))
		{
			return false;
		}
	}

	if (write_register8(dev, BMP280_REG_CTRL, ctrl)) {return false;}

	return true;
}


bool bmp280_force_measurement(Baro_HandleTypedef *dev) {
	uint8_t ctrl;
	if (read_data(dev, BMP280_REG_CTRL, &ctrl, 1))
		return false;
	ctrl &= ~0b11;  // clear two lower bits
	ctrl |= BMP280_MODE_FORCED;
	if (write_register8(dev, BMP280_REG_CTRL, ctrl)) {
		return false;
	}
	return true;
}

bool bmp280_is_measuring(Baro_HandleTypedef *dev) {
	uint8_t status;
	if (read_data(dev, BMP280_REG_STATUS, &status, 1))
		return false;
	if (status & (1 << 3)) {
		return true;
	}
	return false;
}

/**
 * Compensation algorithm is taken from BMP280 datasheet.
 *
 * Return value is in degrees Celsius.
 */
static inline int32_t compensate_temperature(Baro_HandleTypedef *dev, int32_t adc_temp, int32_t *fine_temp)
{
	int32_t var1, var2;

	var1 = ((((adc_temp >> 3) - ((int32_t) dev->dig_T1 << 1))) * (int32_t) dev->dig_T2) >> 11;
	var2 = (((((adc_temp >> 4) - (int32_t) dev->dig_T1) * ((adc_temp >> 4) - (int32_t) dev->dig_T1)) >> 12) * (int32_t) dev->dig_T3) >> 14;

	*fine_temp = var1 + var2;
	return (*fine_temp * 5 + 128) >> 8;
}

/**
 * Compensation algorithm is taken from BMP280 datasheet.
 *
 * Return value is in Pa, 24 integer bits and 8 fractional bits.
 */
static inline uint32_t compensate_pressure(Baro_HandleTypedef *dev, int32_t adc_press,
		int32_t fine_temp) {
	int64_t var1, var2, p;

	var1 = (int64_t) fine_temp - 128000;
	var2 = var1 * var1 * (int64_t) dev->dig_P6;
	var2 = var2 + ((var1 * (int64_t) dev->dig_P5) << 17);
	var2 = var2 + (((int64_t) dev->dig_P4) << 35);
	var1 = ((var1 * var1 * (int64_t) dev->dig_P3) >> 8) + ((var1 * (int64_t) dev->dig_P2) << 12);
	var1 = (((int64_t) 1 << 47) + var1) * ((int64_t) dev->dig_P1) >> 33;

	if (var1 == 0)
	{
		return 0;  // avoid exception caused by division by zero
	}

	p = 1048576 - adc_press;
	p = (((p << 31) - var2) * 3125) / var1;
	var1 = ((int64_t) dev->dig_P9 * (p >> 13) * (p >> 13)) >> 25;
	var2 = ((int64_t) dev->dig_P8 * p) >> 19;

	p = ((p + var1 + var2) >> 8) + ((int64_t) dev->dig_P7 << 4);
	return p;
}
/**
 * Compensation algorithm is taken from BME280 datasheet.
 *
 * Return value is in Pa, 24 integer bits and 8 fractional bits.
 */
static inline uint32_t compensate_humidity(Baro_HandleTypedef *dev, int32_t adc_hum,
		int32_t fine_temp) {
	int32_t v_x1_u32r;

	v_x1_u32r = fine_temp - (int32_t) 76800;
	v_x1_u32r = ((((adc_hum << 14) - ((int32_t) dev->dig_H4 << 20)
			- ((int32_t) dev->dig_H5 * v_x1_u32r)) + (int32_t) 16384) >> 15)
			* (((((((v_x1_u32r * (int32_t) dev->dig_H6) >> 10)
					* (((v_x1_u32r * (int32_t) dev->dig_H3) >> 11)
							+ (int32_t) 32768)) >> 10) + (int32_t) 2097152)
					* (int32_t) dev->dig_H2 + 8192) >> 14);
	v_x1_u32r = v_x1_u32r
			- (((((v_x1_u32r >> 15) * (v_x1_u32r >> 15)) >> 7)
					* (int32_t) dev->dig_H1) >> 4);
	v_x1_u32r = v_x1_u32r < 0 ? 0 : v_x1_u32r;
	v_x1_u32r = v_x1_u32r > 419430400 ? 419430400 : v_x1_u32r;
	return v_x1_u32r >> 12;
}


bool bmp280_read_fixed(Baro_HandleTypedef *dev, int32_t *temperature, uint32_t *pressure, uint32_t *humidity)
{
	int32_t adc_pressure;
	int32_t adc_temp;
	uint8_t data[8];

	// Only the BME280 supports reading the humidity.
	if (dev->id != BME280_CHIP_ID)
	{
		if (humidity)
			*humidity = 0;
		humidity = NULL;
	}

	// Need to read in one sequence to ensure they match.
	size_t size = humidity ? 8 : 6;
	if (read_data(dev, 0xf7, data, size))
	{
		return false;
	}

	adc_pressure = data[0] << 12 | data[1] << 4 | data[2] >> 4;
	adc_temp = data[3] << 12 | data[4] << 4 | data[5] >> 4;

	int32_t fine_temp;
	*temperature = compensate_temperature(dev, adc_temp, &fine_temp);
	*pressure = compensate_pressure(dev, adc_pressure, fine_temp);

	if (humidity)
	{
		int32_t adc_humidity = data[6] << 8 | data[7];
		*humidity = compensate_humidity(dev, adc_humidity, fine_temp);
	}

	return true;
}


bool bmp280_read_float(Baro_HandleTypedef *dev, float *temperature, float *pressure, float *humidity)
{
	int32_t fixed_temperature;
	uint32_t fixed_pressure;
	uint32_t fixed_humidity;

	if (bmp280_read_fixed(dev, &fixed_temperature, &fixed_pressure, humidity ? &fixed_humidity : NULL))
	{
		*temperature = (float) fixed_temperature / 100;
		*pressure = (float) fixed_pressure / 256;
		if (humidity)
			*humidity = (float) fixed_humidity / 1024;
		return true;
	}
}


/*Data Processing*/

/*Pressure to Altitude*/
float pressureToAltitude(float pressure)
{
    float exponent = (-UNIVERSAL_GAS_CONSTANT * TEMPERATURE_LAPSE_RATE) / (GRAVITATIONAL_ACCELERATION * MOLAR_MASS_AIR);
    float pressureRatio = pressure / SEA_LEVEL_PRESSURE;
    float altitude = (SEA_LEVEL_TEMPERATURE / TEMPERATURE_LAPSE_RATE) * (pow(pressureRatio, exponent) - 1);
    return altitude;
}
int baro_cnt = 0;
bool Process_BMP280(Baro_HandleTypedef *dev)
{
	if(baro_cnt==80)
	{
		/*Attain Current Tick from TIM6 and get dt*/

		dev->dt = (1.0f/PID_Freq) *baro_cnt;
		/*Get Pressure and Temperature Data*/
		if(bmp280_read_float(dev, &dev->Temperature, &dev->Pressure, &dev->Humidity));

		/*Calculate Altitude*/
		dev->Altitude = pressureToAltitude((float)dev->Pressure/100.0f) * 100.0f; //pascals to hectopascals and m to cm

		/*Calculate Z Velocity*/
		dev->Zvelocity = (float)(dev->Altitude - dev->Prev_Altitude )/dev->dt ;

		dev->Prev_Altitude = dev->Altitude; //store the prev altitude for calculating velocity

		baro_cnt=0;
		return 1;
	}
	baro_cnt++;
	return 0;
}
