koradeh/STM32_Drone/Sample Firmware/STM32_Drone_Dev-master/UAV_F722/Core/Src/flash/Flash_Sector_F4.h

/*
 * Flash_Sector_F4.h
 *
 *  Created on: Oct 30, 2024
 *      Author: Vincent
 */

#ifndef SRC_FLASH_FLASH_SECTOR_F4_H_
#define SRC_FLASH_FLASH_SECTOR_F4_H_

#include "stdint.h"

uint32_t Flash_Write_Data (uint32_t StartSectorAddress, uint32_t *Data, uint16_t numberofwords);

void Flash_Read_Data (uint32_t StartSectorAddress, uint32_t *RxBuf, uint16_t numberofwords);

void Convert_To_Str (uint32_t *Data, char *Buf);

void Flash_Write_NUM (uint32_t StartSectorAddress, float Num);

float Flash_Read_NUM (uint32_t StartSectorAddress);

#endif /* SRC_FLASH_FLASH_SECTOR_F4_H_ */
