koradeh/STM32_Drone/Sample Firmware/STM32_Drone_Dev-master/UAV_F722/Core/Src/sensors/acceleration.h

/*
 * acceleration.h
 *
 *  Created on: Oct 6, 2024
 *      Author: Vincent
 */

#ifndef SRC_SENSORS_ACCELERATION_H_
#define SRC_SENSORS_ACCELERATION_H_
#include "ICM42688P.h"


#endif /* SRC_SENSORS_ACCELERATION_H_ */
