koradeh/STM32_Drone/(notices)

Notices in the files:
Sample Firmware/STM32_Drone_Dev-master/STM32H723/Core/Src/main.c:
Copyright (c) 2024 STMicroelectronics.
All rights reserved.
This software is licensed under terms that can be found in the LICENSE file
